eldrickm/wakey_wakey/netlists/README.md

Use:
design_extracted.spice-hand-route-diode-fix.gz
- This has D0 instead of X0 in the raw spice for the diode issue
design.lvs.v-dbg-decapped-wrapped.gz
- This adds user_project_wrapper as well as the relevant power connections

These pass LVS.
