eldrickm/wakey_wakey/pd_proprietary/custom_lvs_no_bbox/inputs/README.md

This needs:
adk/
design.lvs.v
design_extracted.spice

Move stdcells.spi to adk/, this deals with he VNB pins in conb_1
