eldrickm/wakey_wakey/py/model_summary.png

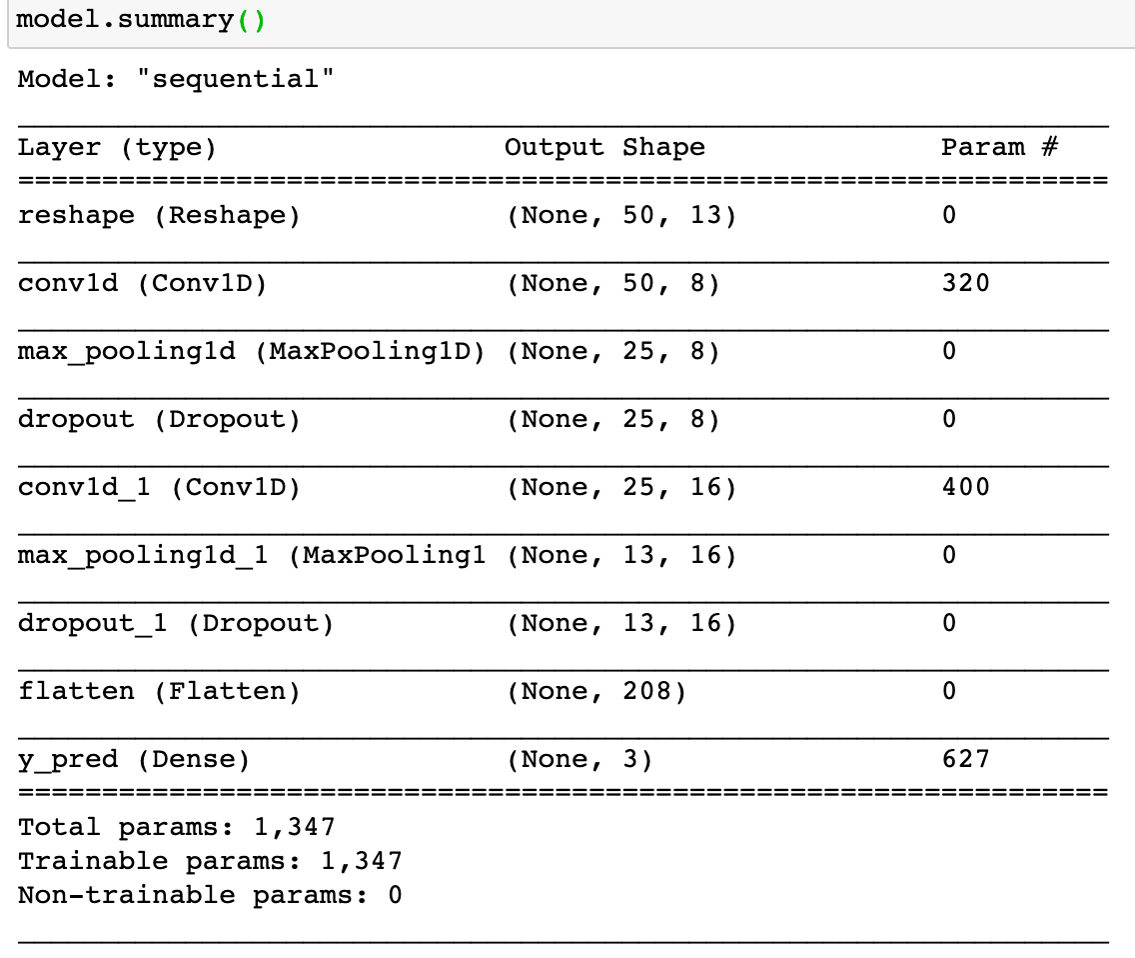
py/model_summary.png
