eldrickm/wakey_wakey/py/outputs/err_cic1_16000_ps.png

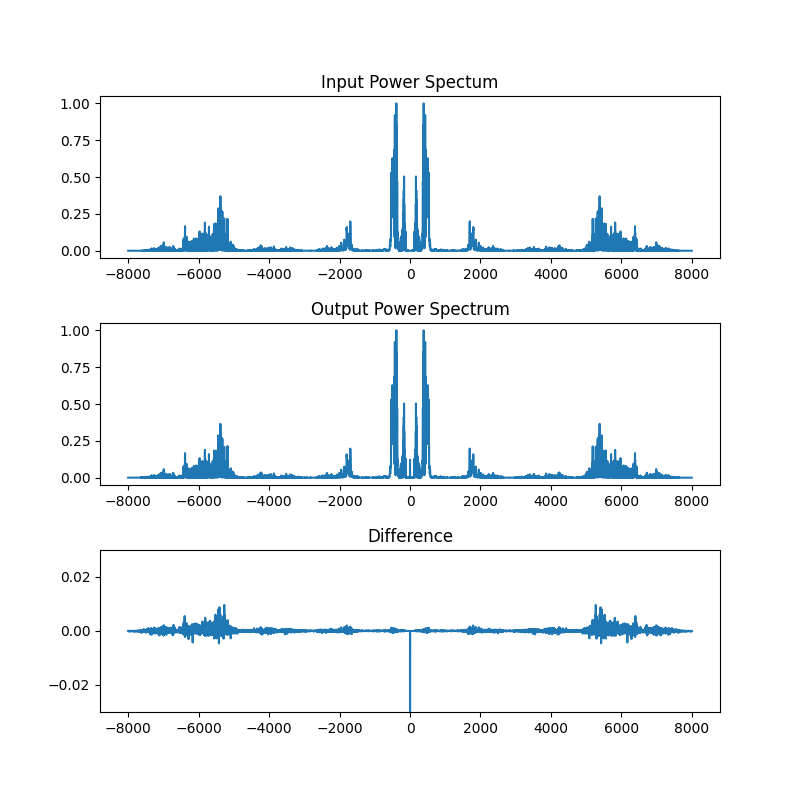
py/outputs/err_cic1_16000_ps.png
