eldrickm/wakey_wakey/rtl/aco/aco/plots/test_1/2Power_spectrum.png

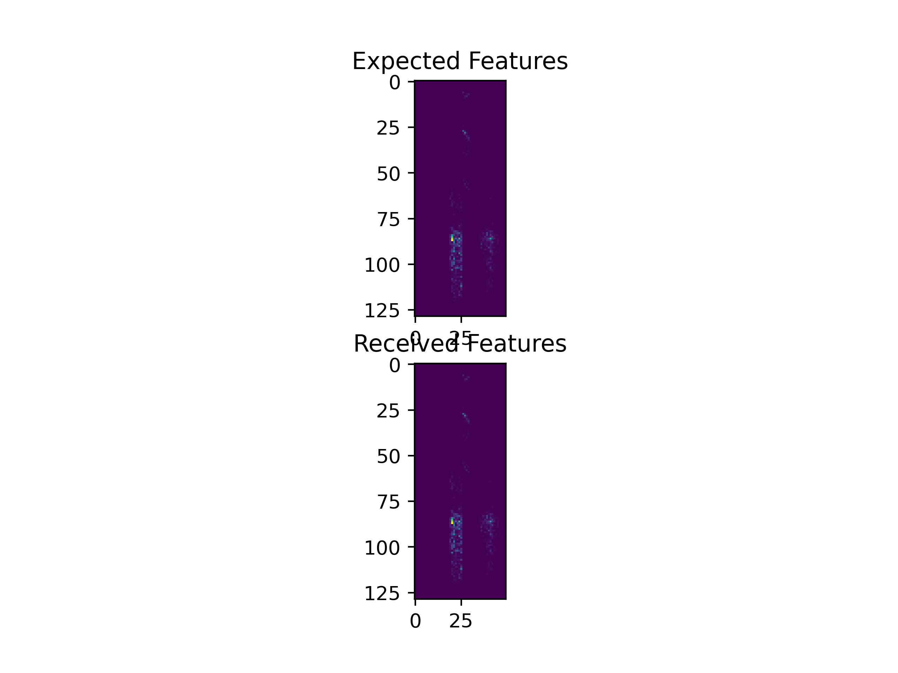
rtl/aco/aco/plots/test_1/2Power_spectrum.png
