eldrickm/wakey_wakey/rtl/aco/fft_wrapper/plots/0.png

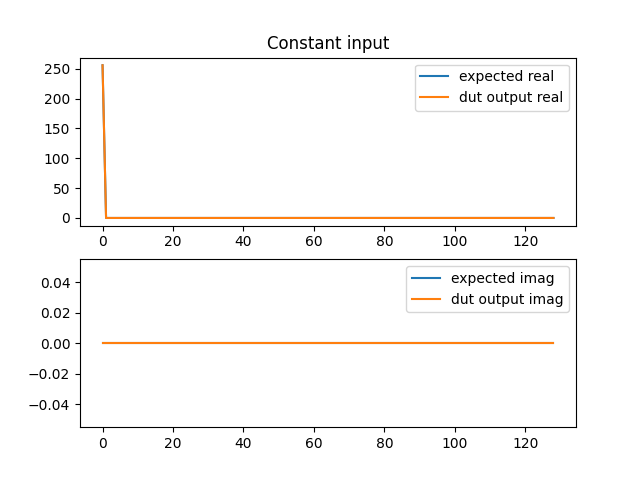
rtl/aco/fft_wrapper/plots/0.png
