eldrickm/wakey_wakey/rtl/aco/fft_wrapper/plots/1.png

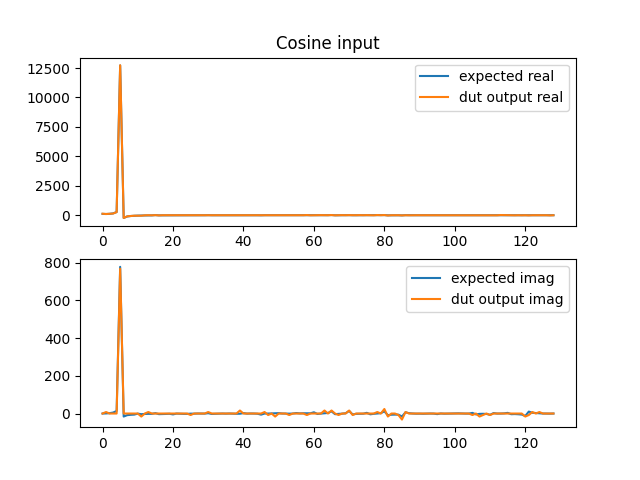
rtl/aco/fft_wrapper/plots/1.png
