eldrickm/wakey_wakey/rtl/aco/fft_wrapper/plots/2.png

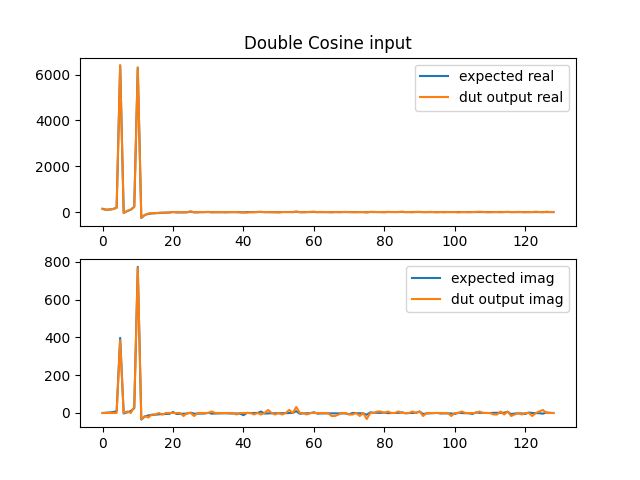
rtl/aco/fft_wrapper/plots/2.png
