eldrickm/wakey_wakey/rtl/aco/fft_wrapper/plots/3.png

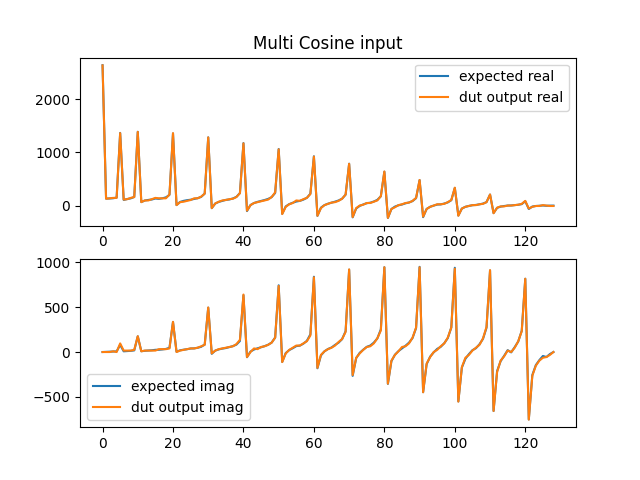
rtl/aco/fft_wrapper/plots/3.png
