eldrickm/wakey_wakey/rtl/aco/fft_wrapper/plots/4.png

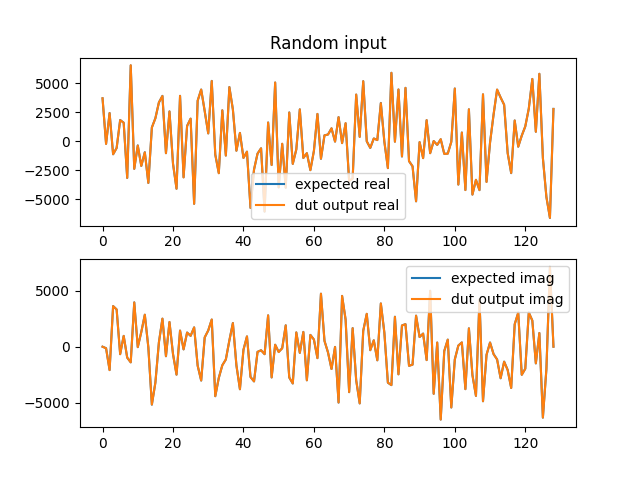
rtl/aco/fft_wrapper/plots/4.png
