eldrickm/wakey_wakey/rtl/aco/aco/plots/test_1/3Filterbank.png

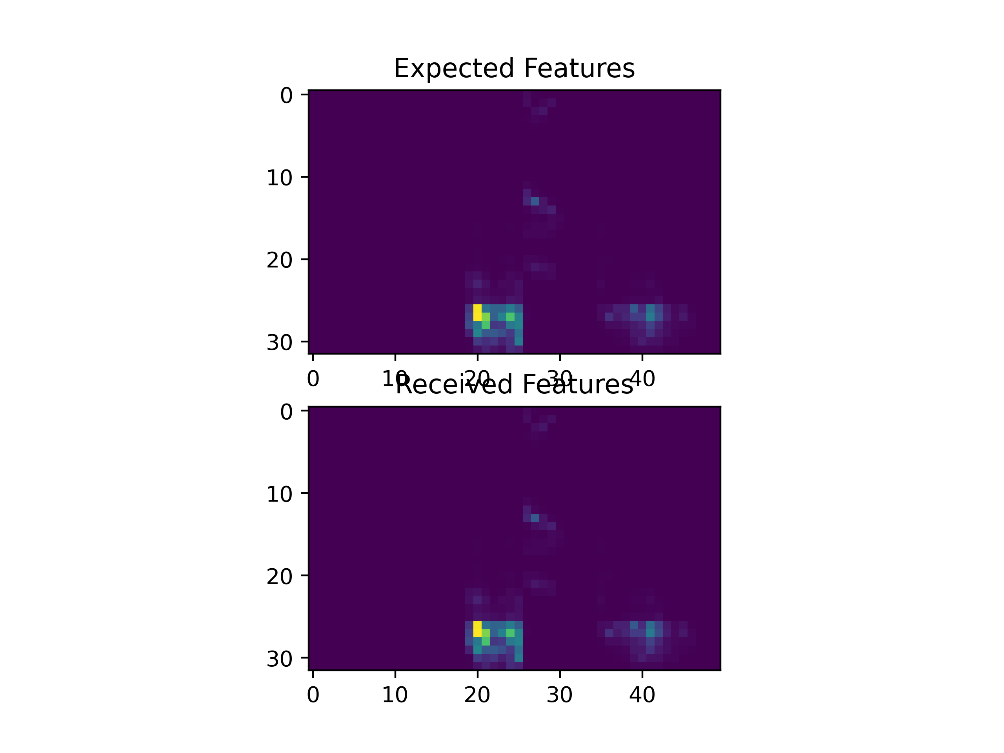
rtl/aco/aco/plots/test_1/3Filterbank.png
