eldrickm/wakey_wakey/rtl/aco/aco/plots/test_1/4Log.png

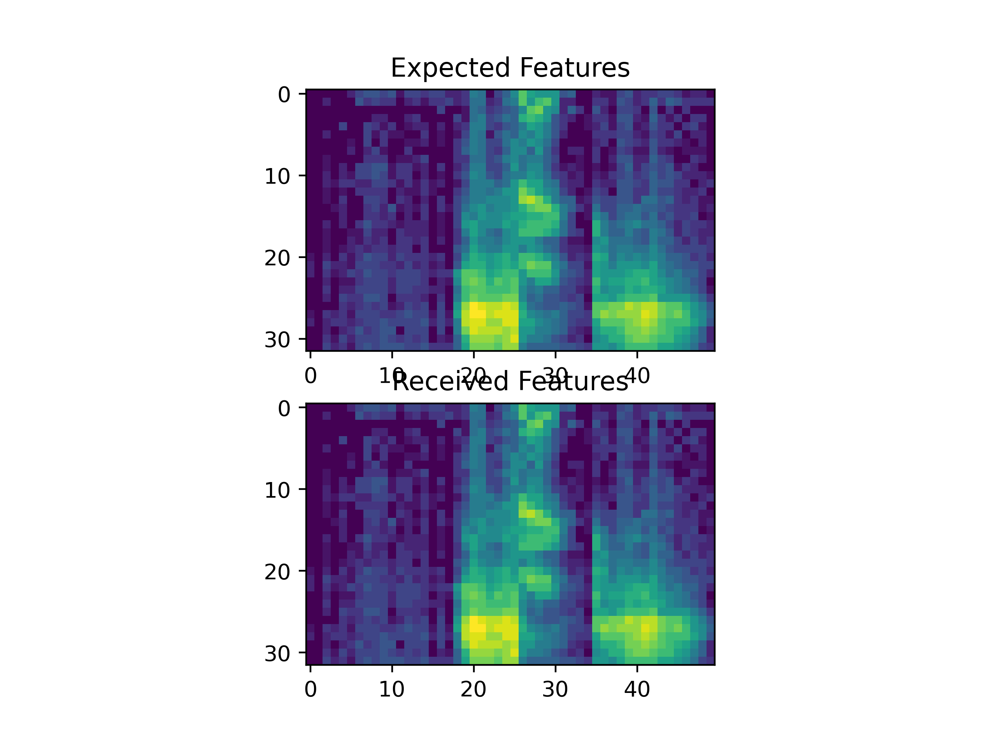
rtl/aco/aco/plots/test_1/4Log.png
