eldrickm/wakey_wakey/rtl/aco/aco/plots/test_1/5DCT.png

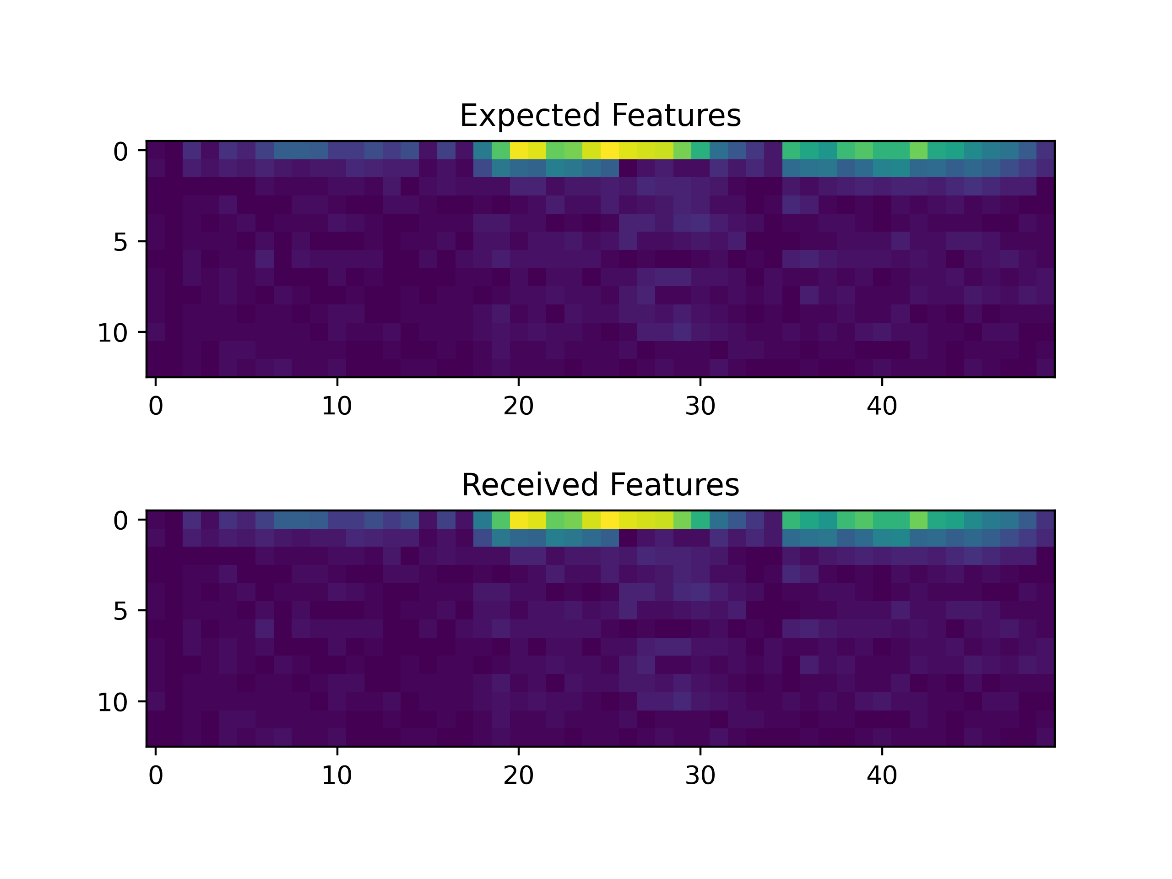
rtl/aco/aco/plots/test_1/5DCT.png
