eldrickm/wakey_wakey/rtl/aco/aco/plots/test_2/3Filterbank.png

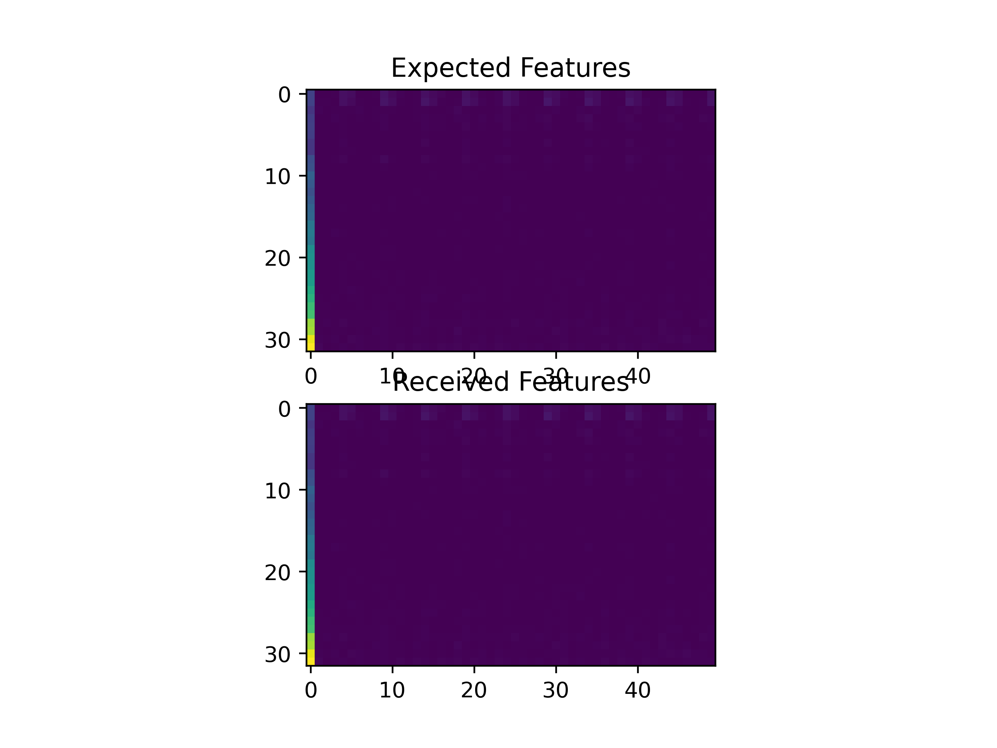
rtl/aco/aco/plots/test_2/3Filterbank.png
