eldrickm/wakey_wakey/rtl/aco/aco/plots/test_2/5DCT.png

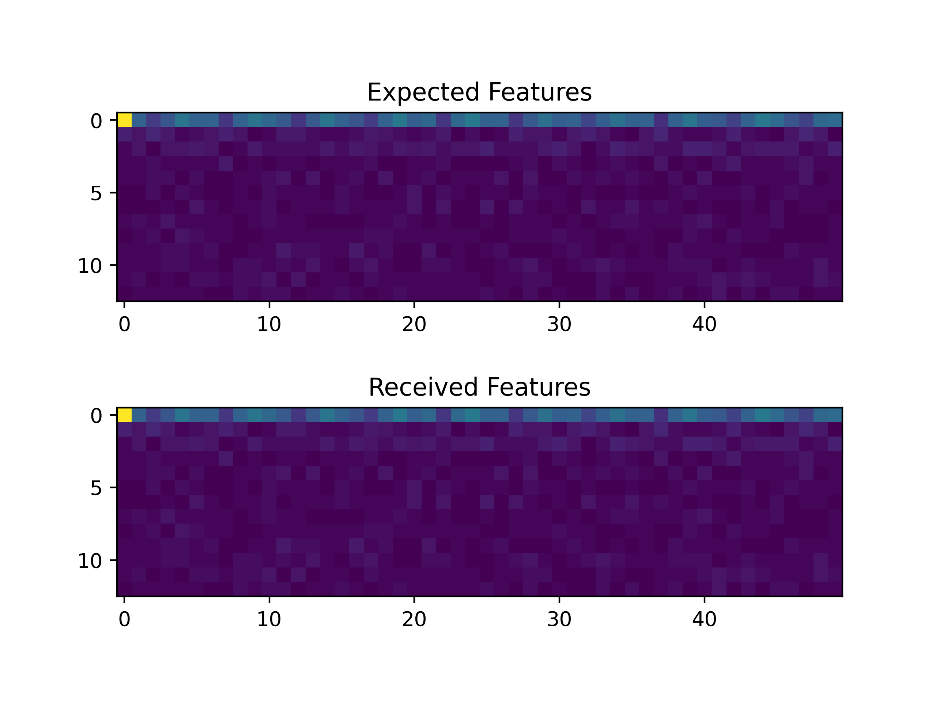
rtl/aco/aco/plots/test_2/5DCT.png
