eldrickm/wakey_wakey/rtl/aco/aco/plots/test_3/4Log.png

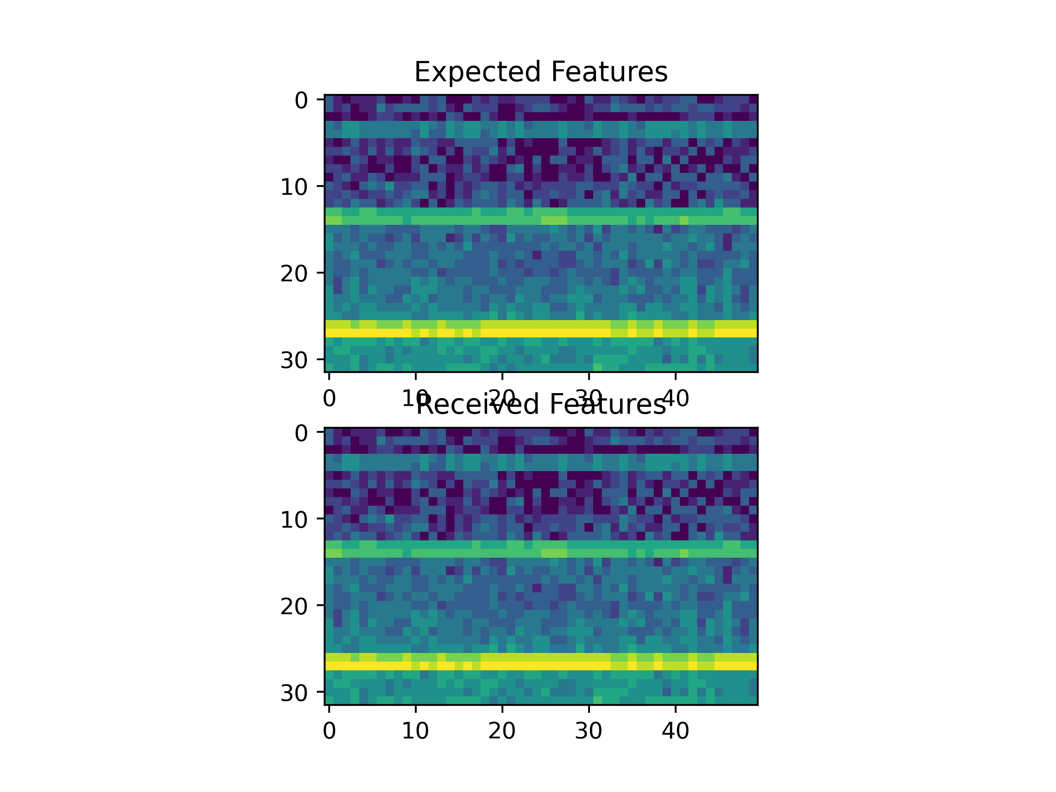
rtl/aco/aco/plots/test_3/4Log.png
