eldrickm/wakey_wakey/rtl/aco/aco/plots/test_3/5DCT.png

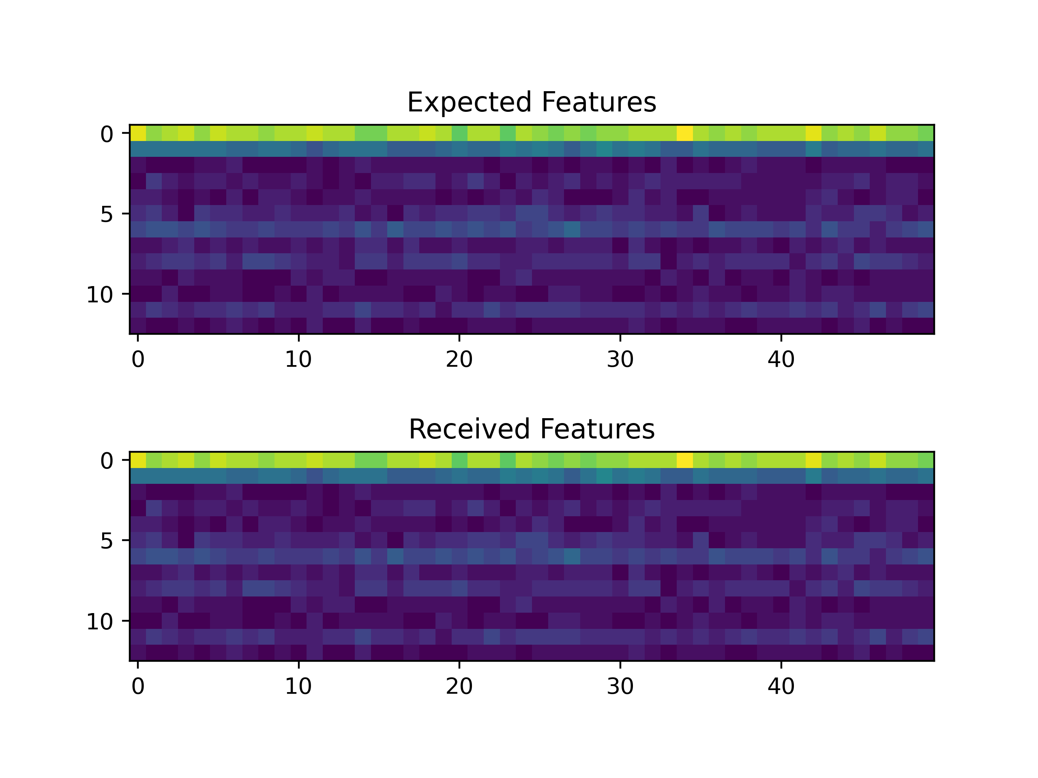
rtl/aco/aco/plots/test_3/5DCT.png
