eldrickm/wakey_wakey/rtl/aco/aco/plots/test_4/5DCT.png

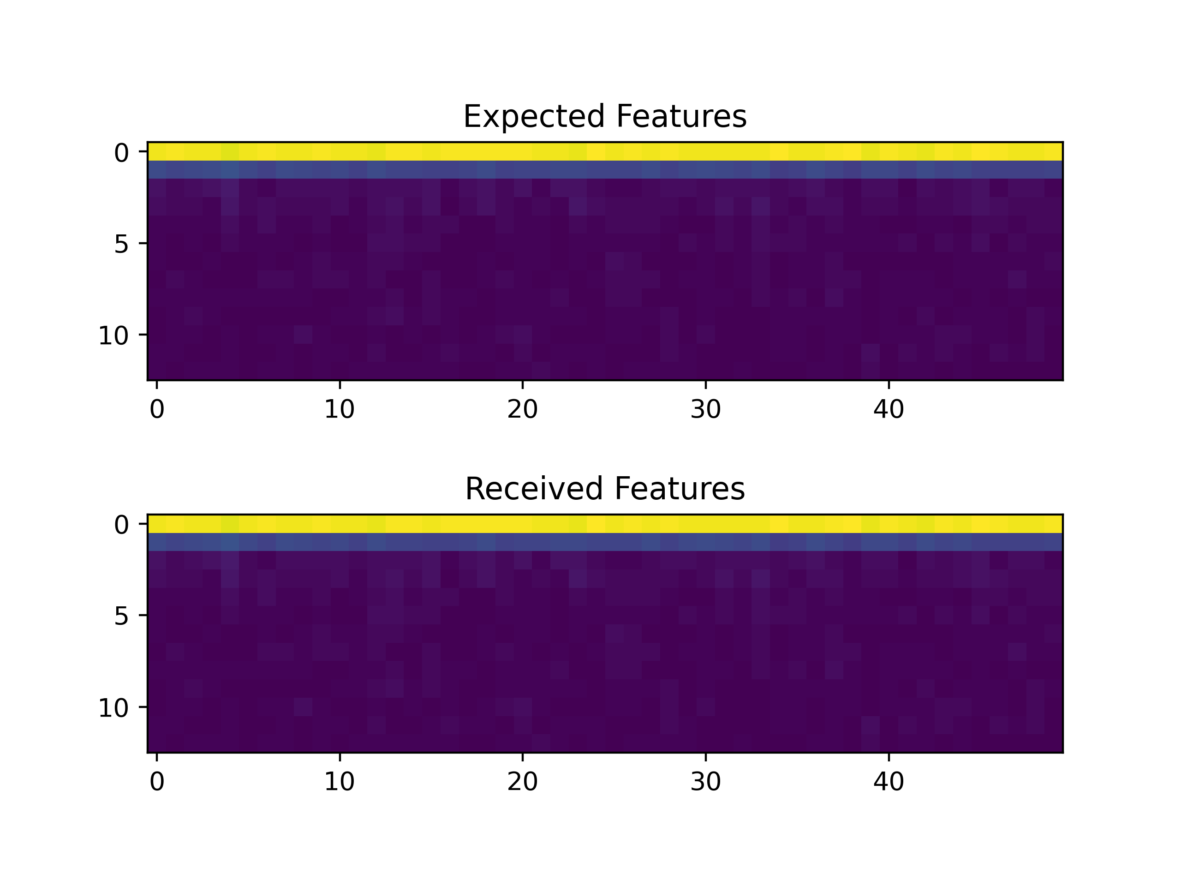
rtl/aco/aco/plots/test_4/5DCT.png
