eldrickm/wakey_wakey/rtl/aco/aco/plots/test_5/5DCT.png

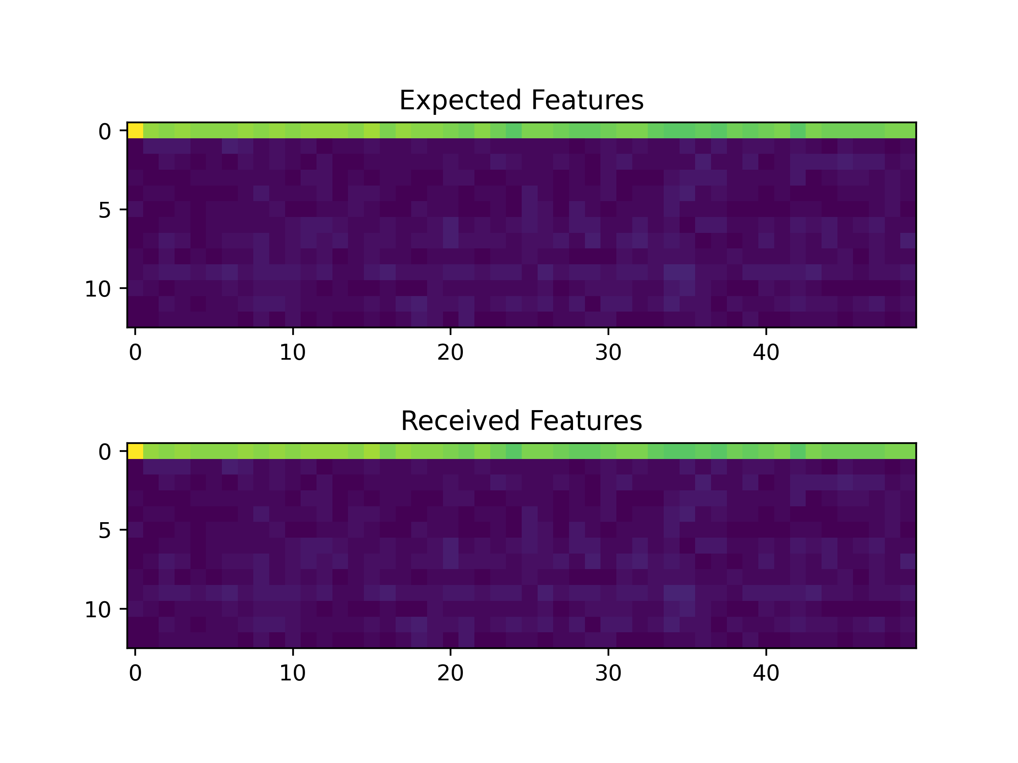
rtl/aco/aco/plots/test_5/5DCT.png
