eldrickm/wakey_wakey/rtl/aco/aco/plots/test_6/5DCT.png

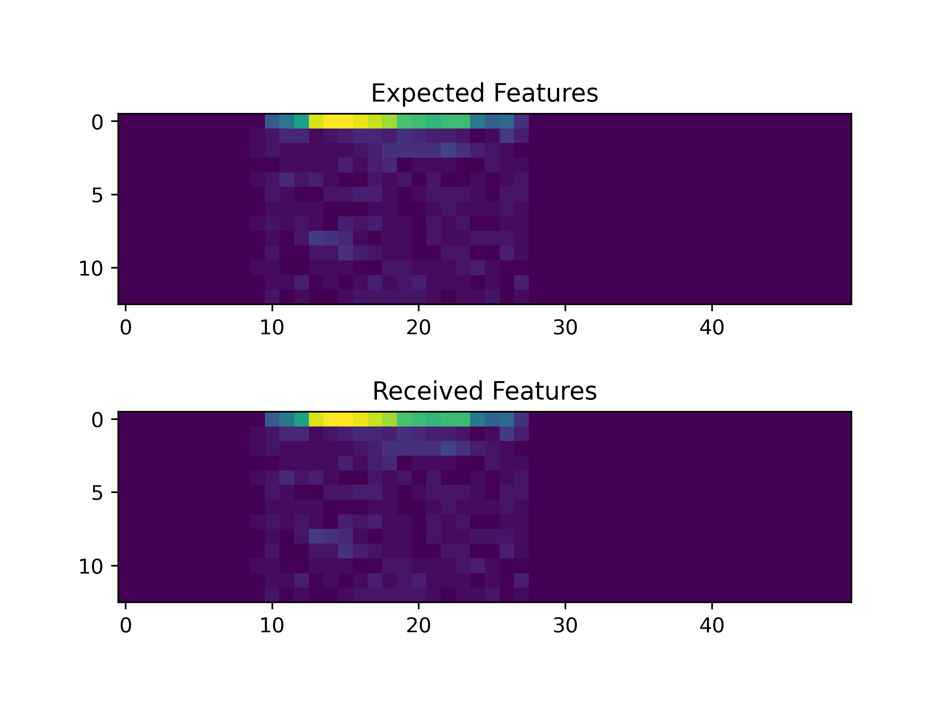
rtl/aco/aco/plots/test_6/5DCT.png
