eldrickm/wakey_wakey/rtl/aco/aco/plots/test_7/5DCT.png

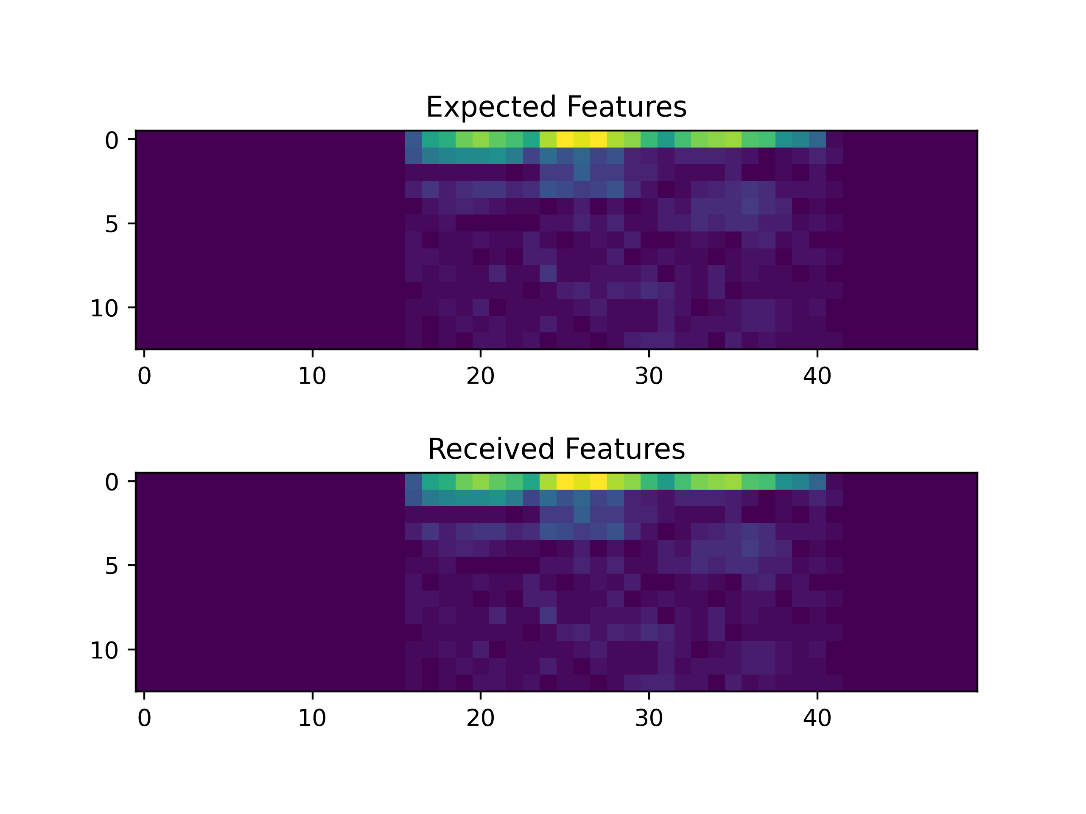
rtl/aco/aco/plots/test_7/5DCT.png
