eldrickm/wakey_wakey/rtl/aco/aco/plots/test_8/5DCT.png

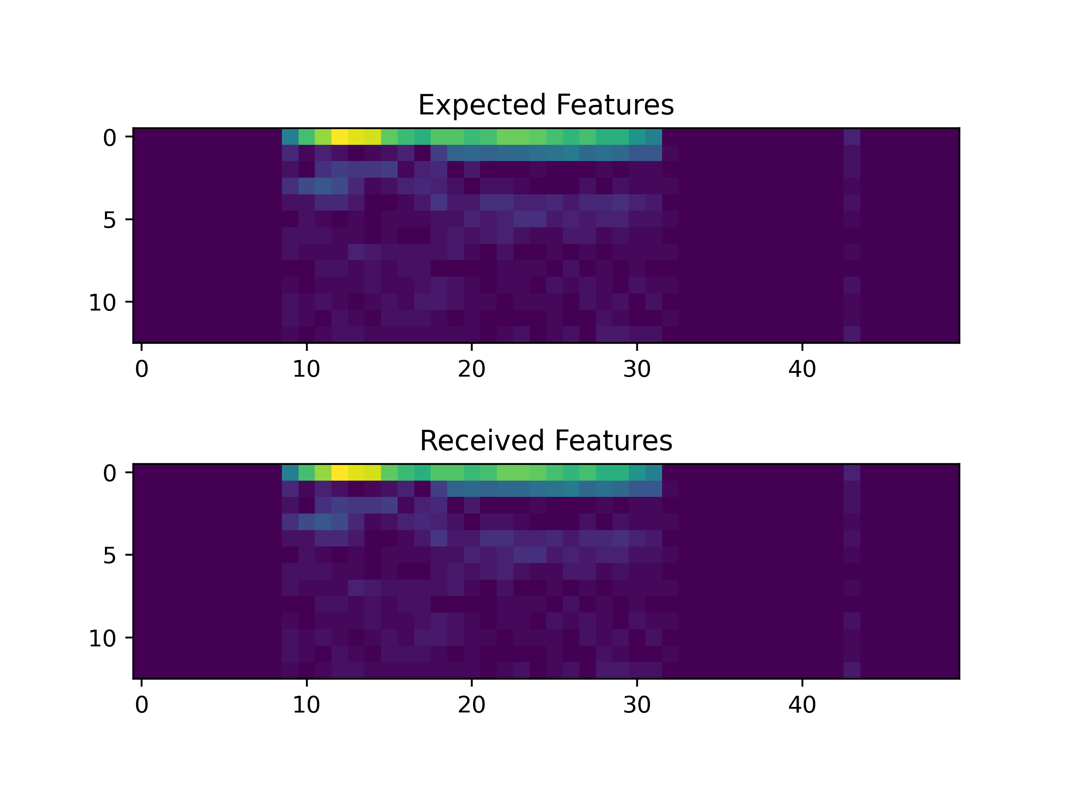
rtl/aco/aco/plots/test_8/5DCT.png
