eldrickm/wakey_wakey/rtl/aco/aco/plots/test_9/5DCT.png

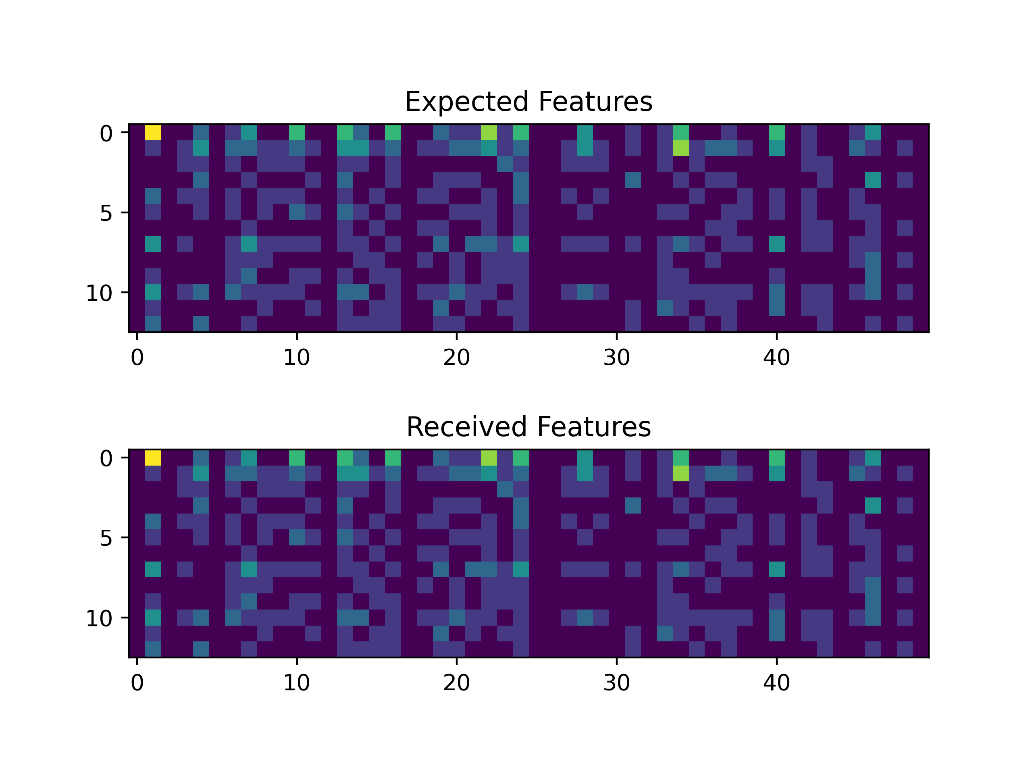
rtl/aco/aco/plots/test_9/5DCT.png
