eldrickm/wakey_wakey/rtl/aco/aco/plots/test_10/5DCT.png

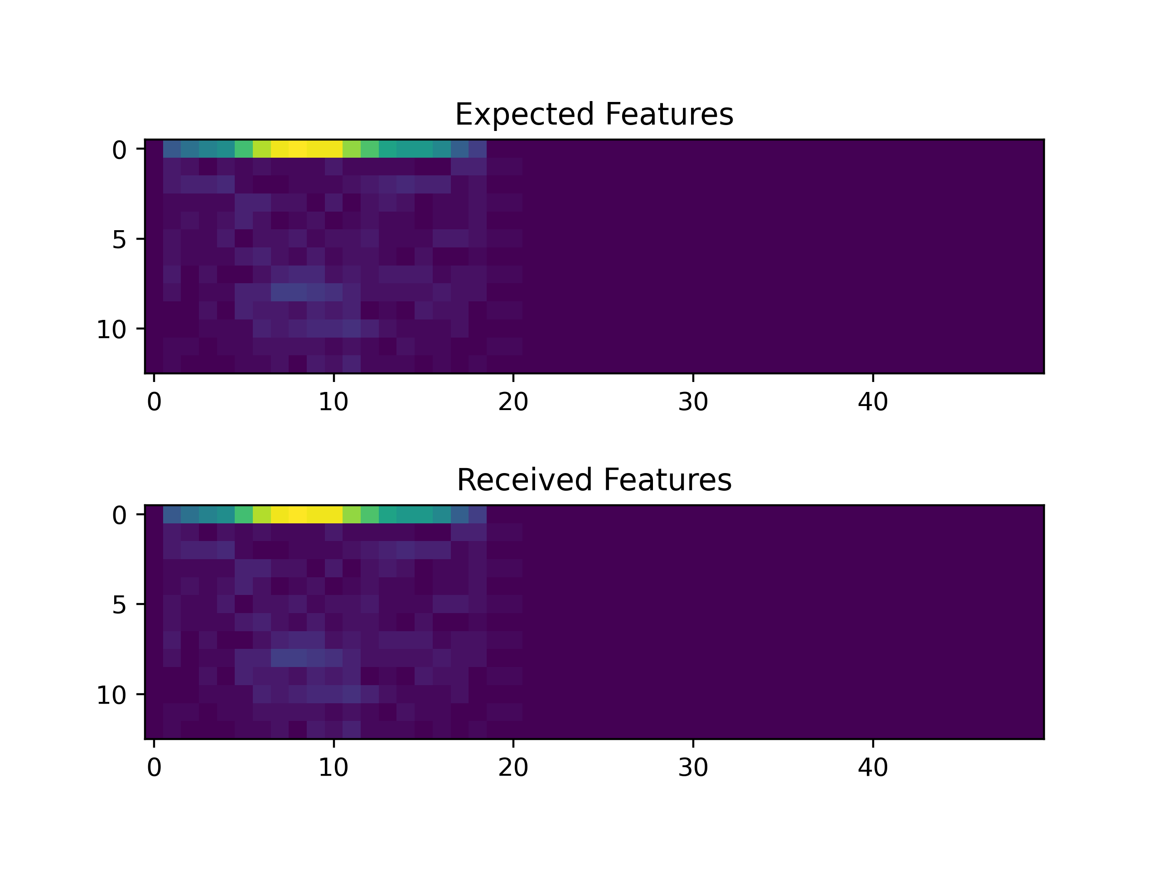
rtl/aco/aco/plots/test_10/5DCT.png
