eldrickm/wakey_wakey/rtl/aco/aco/plots/test_11/4Log.png

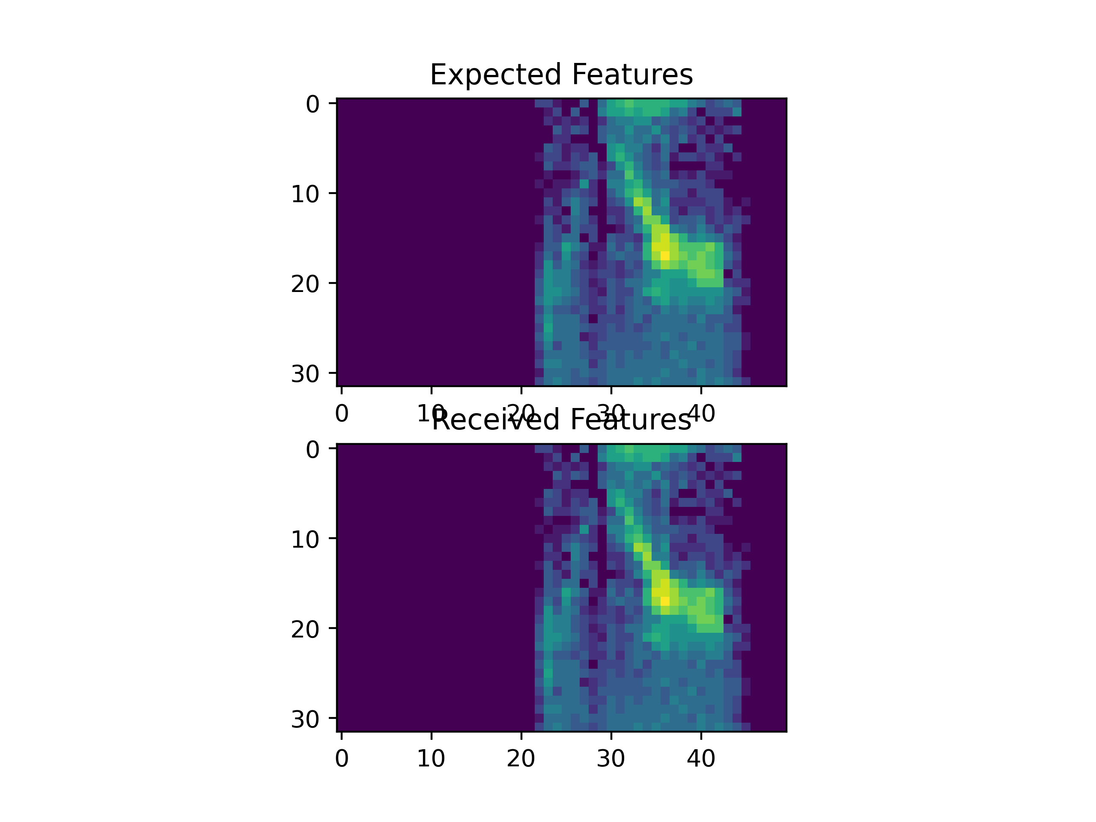
rtl/aco/aco/plots/test_11/4Log.png
