eldrickm/wakey_wakey/rtl/aco/aco/plots/test_11/5DCT.png

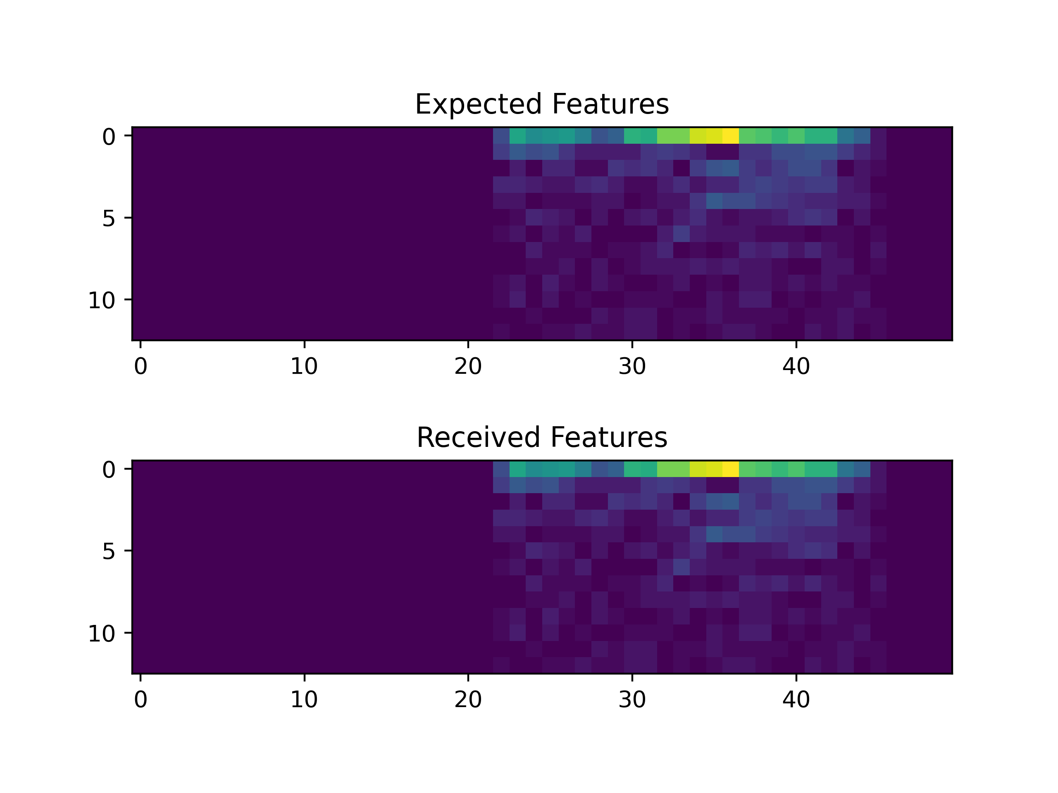
rtl/aco/aco/plots/test_11/5DCT.png
