eldrickm/wakey_wakey/rtl/top/top/plots/test_4/7Final.png

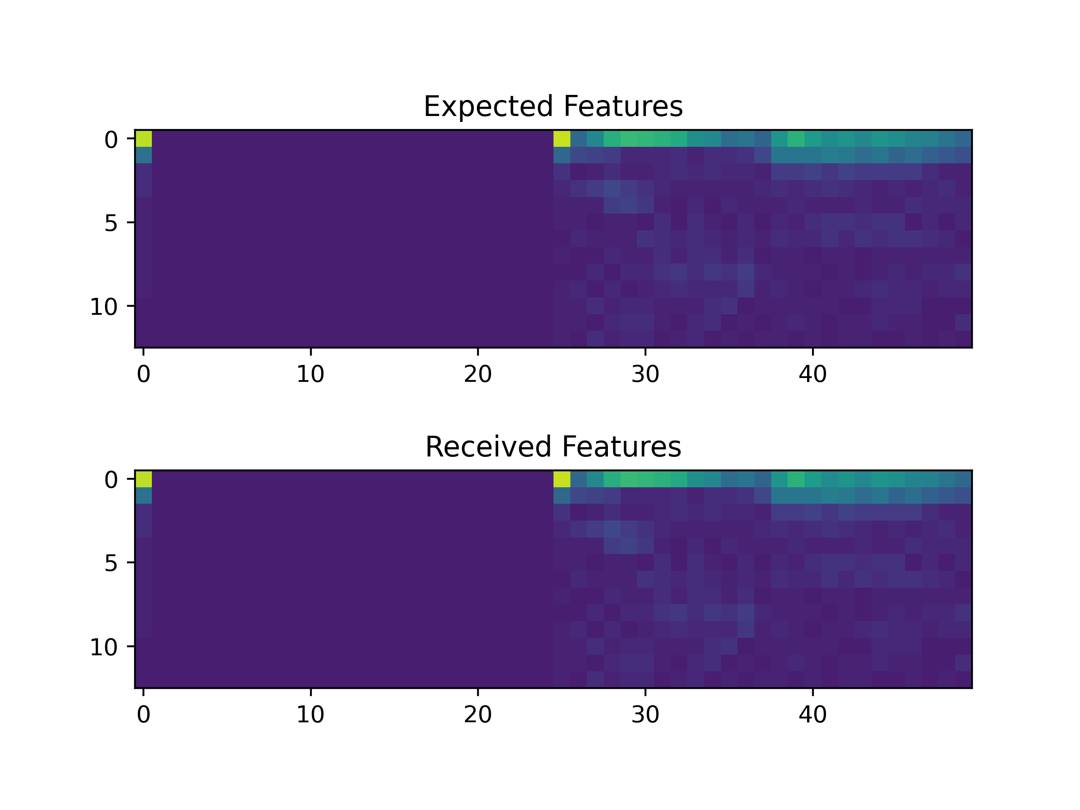
rtl/top/top/plots/test_4/7Final.png
