eldrickm/wakey_wakey/rtl/top/top/plots/test_5/7Final.png

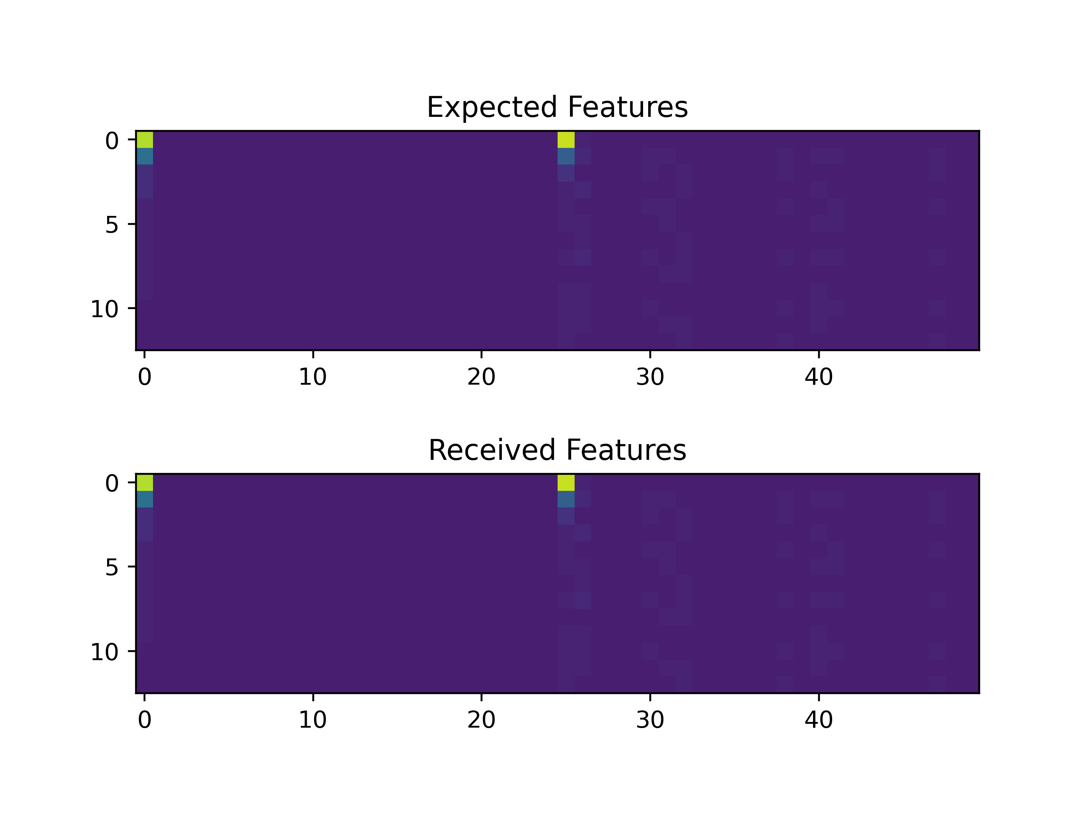
rtl/top/top/plots/test_5/7Final.png
