eldrickm/wakey_wakey/rtl/top/top/plots/test_6/7Final.png

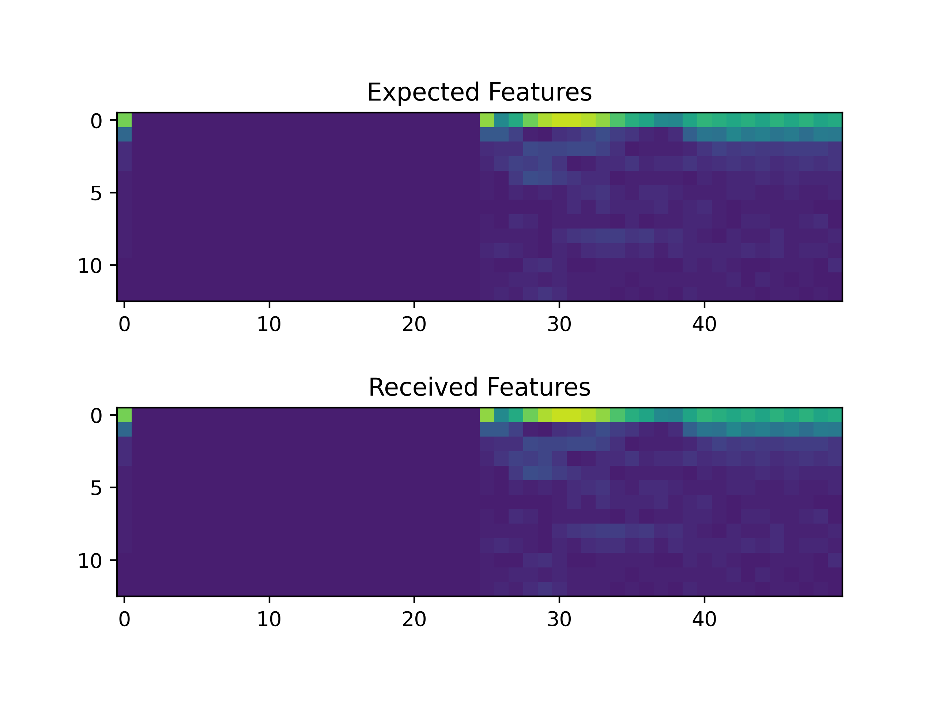
rtl/top/top/plots/test_6/7Final.png
