eldrickm/wakey_wakey/rtl/top/top/plots/test_9/7Final.png

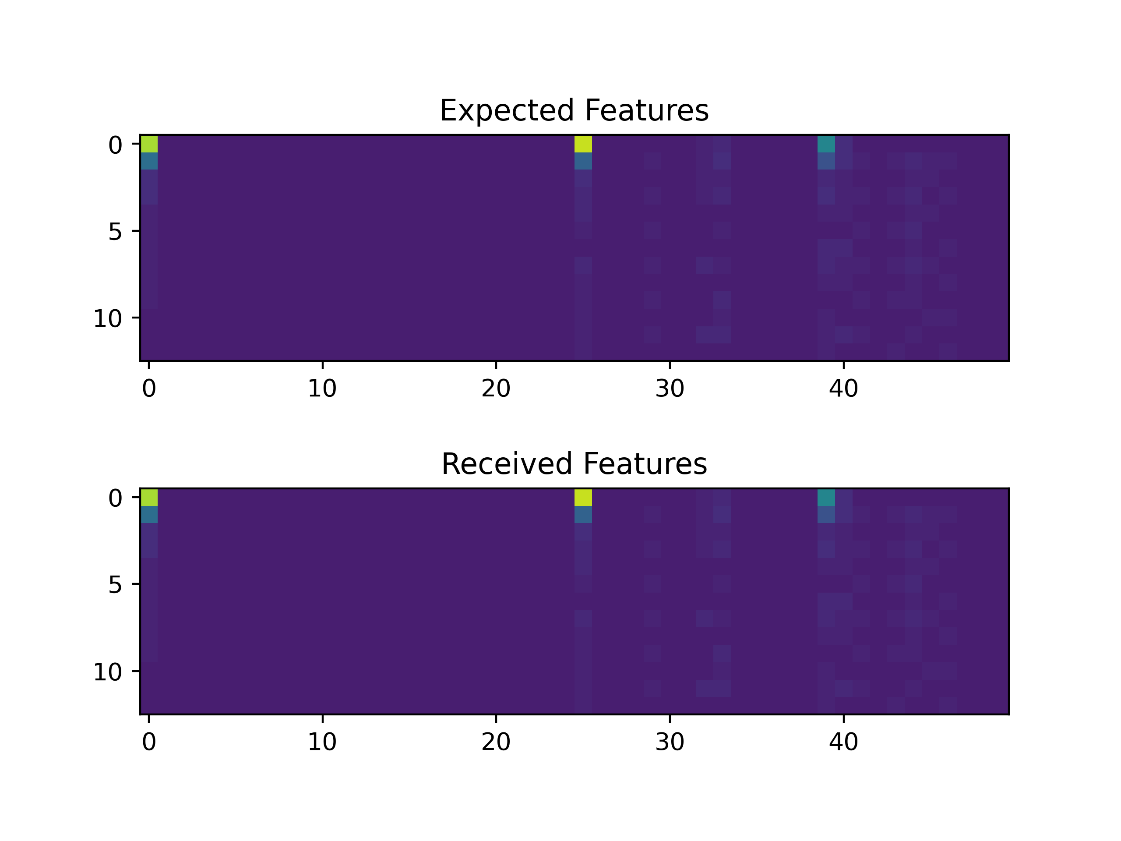
rtl/top/top/plots/test_9/7Final.png
