eldrickm/wakey_wakey/rtl/top/top/plots/test_11/7Final.png

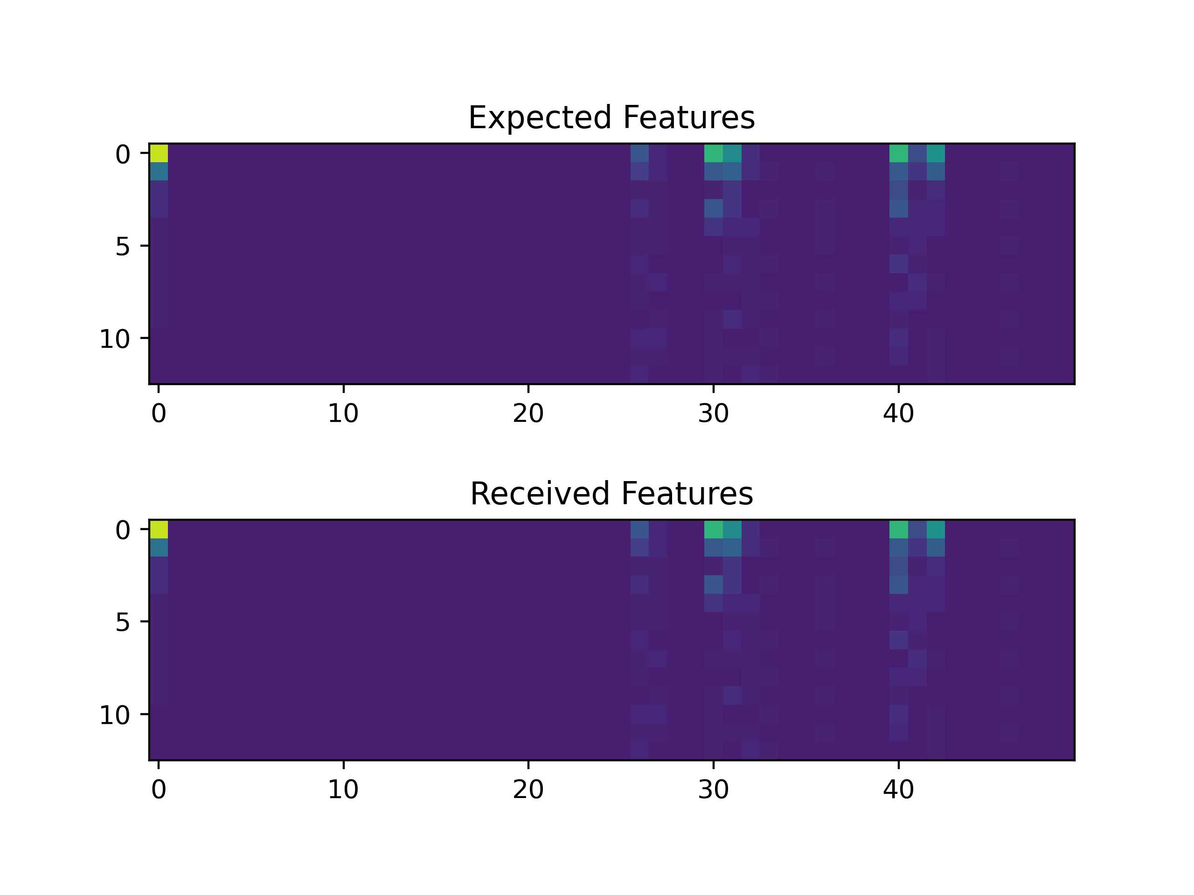
rtl/top/top/plots/test_11/7Final.png
