eldrickm/wakey_wakey/rtl/top/top/plots/test_13/7Final.png

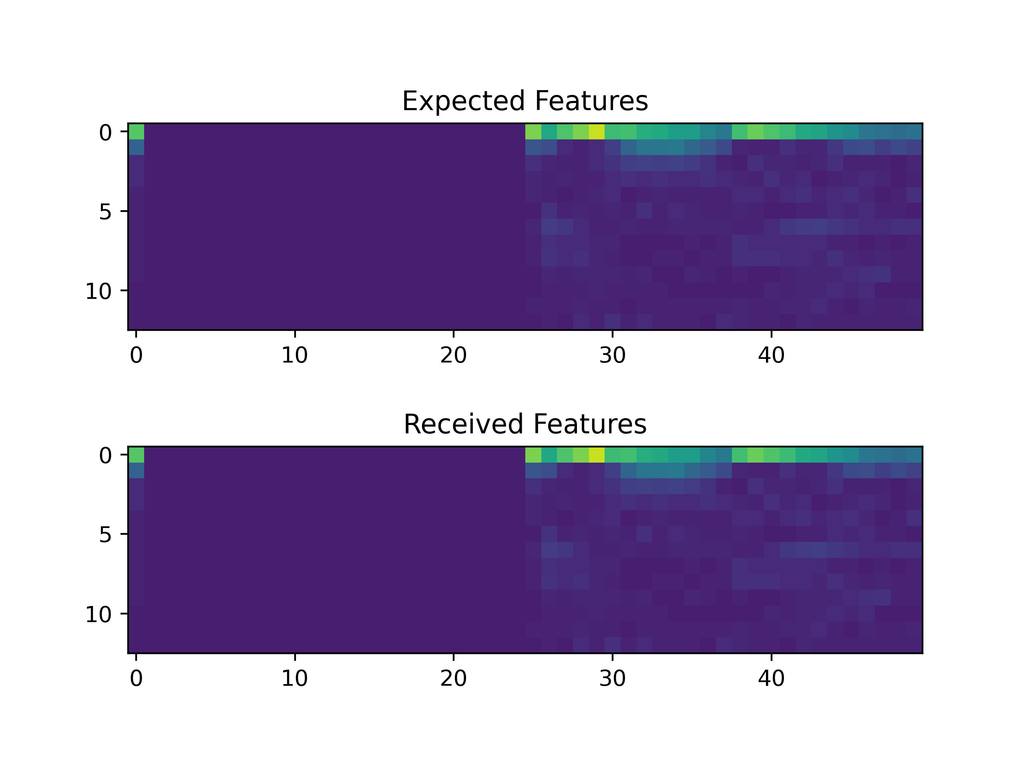
rtl/top/top/plots/test_13/7Final.png
