eldrickm/wakey_wakey/rtl/top/top/plots/test_15/7Final.png

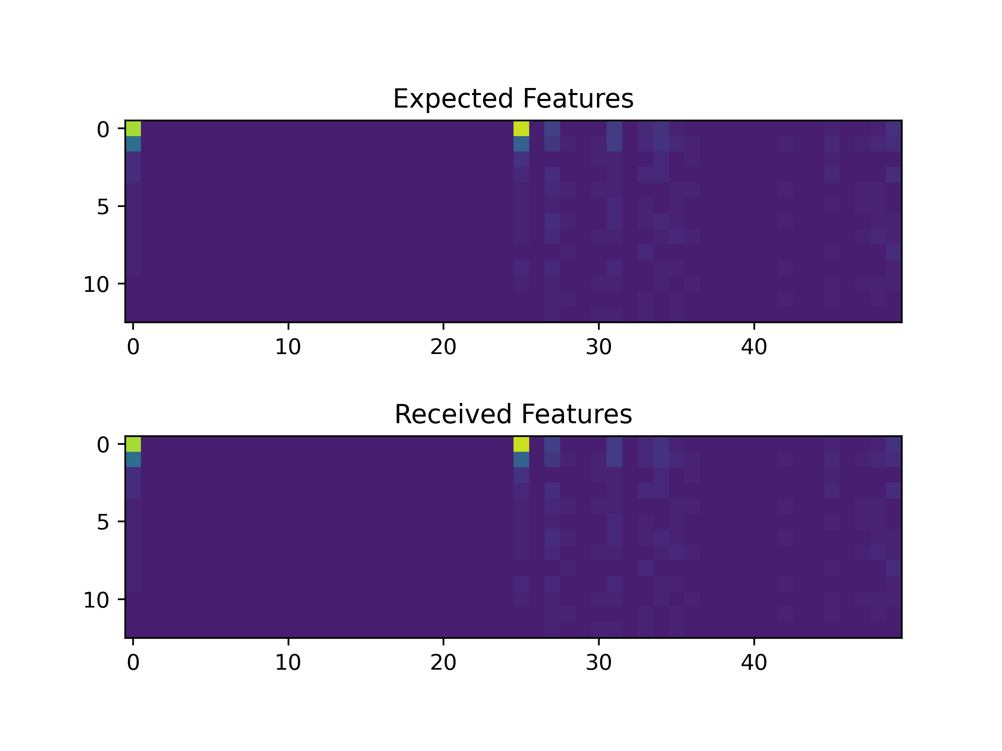
rtl/top/top/plots/test_15/7Final.png
