eldrickm/wakey_wakey/rtl/top/top/plots/test_17/7Final.png

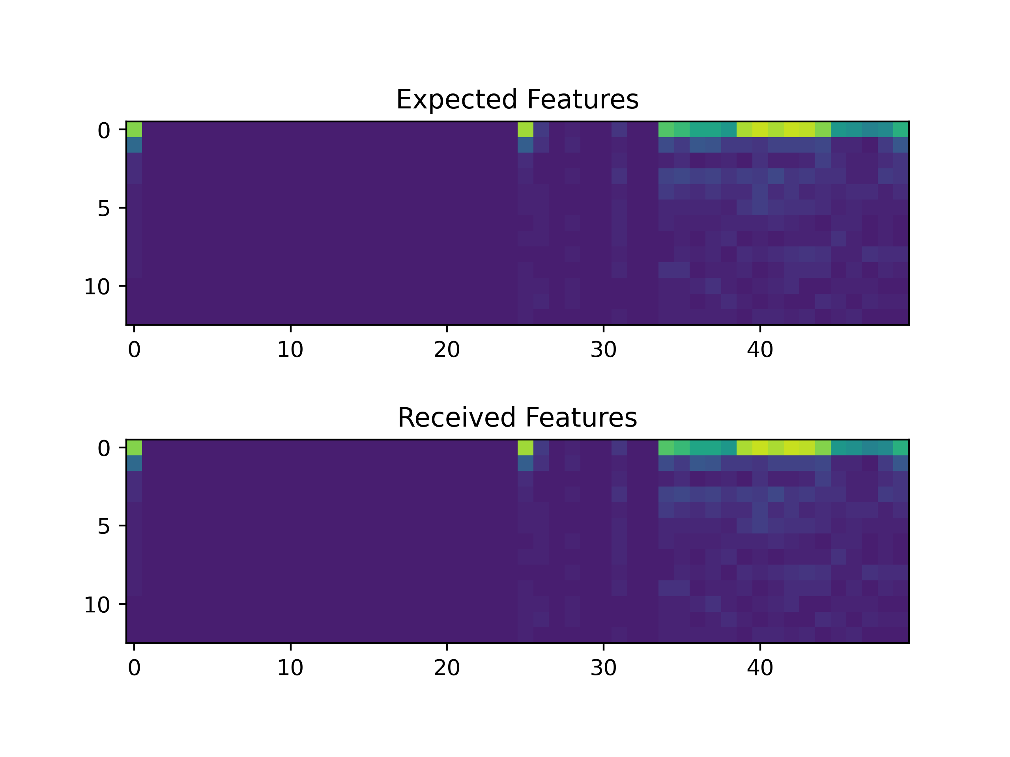
rtl/top/top/plots/test_17/7Final.png
