eldrickm/wakey_wakey/rtl/top/top/plots/test_19/7Final.png

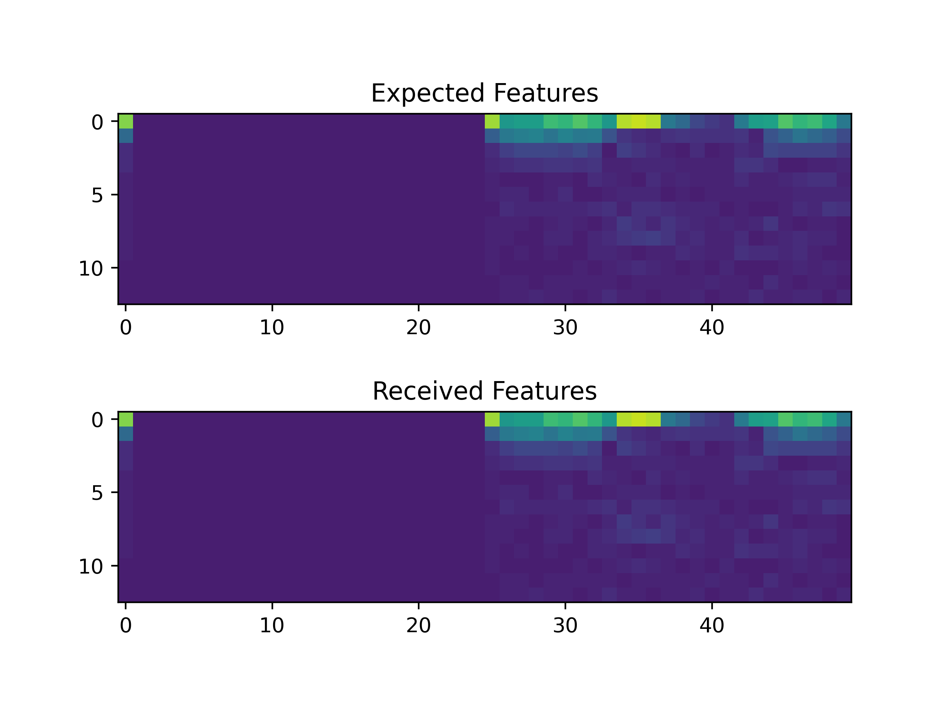
rtl/top/top/plots/test_19/7Final.png
