eldrickm/wakey_wakey/rtl/top/top/plots/test_20/7Final.png

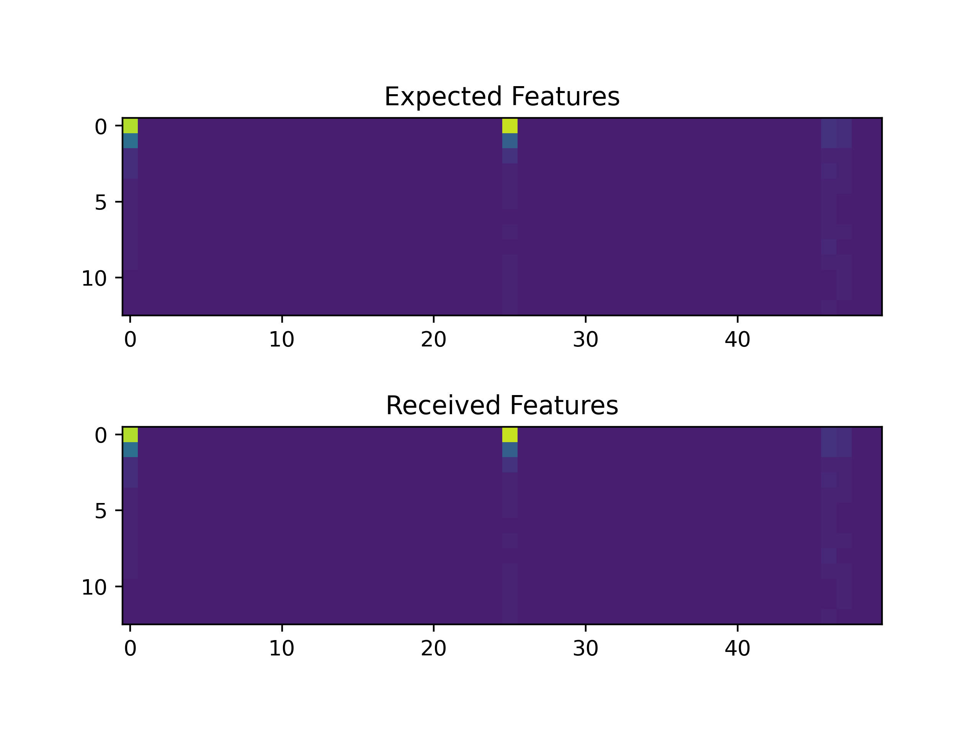
rtl/top/top/plots/test_20/7Final.png
