eldrickm/wakey_wakey/rtl/top/top/plots/test_21/7Final.png

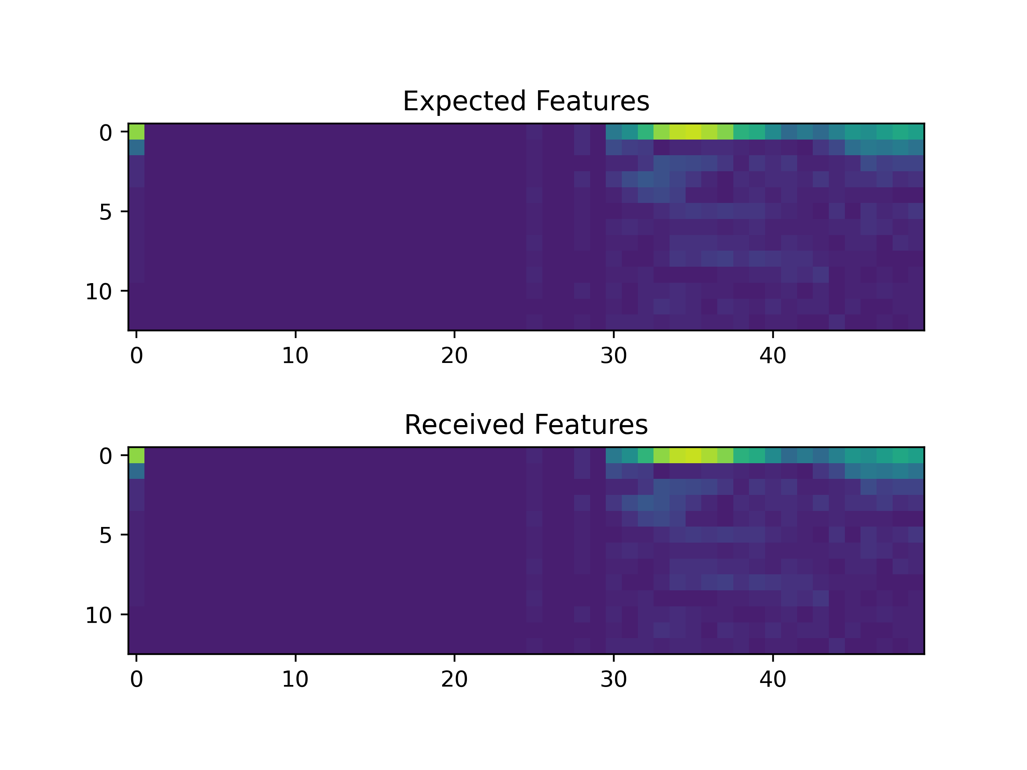
rtl/top/top/plots/test_21/7Final.png
