eldrickm/wakey_wakey/rtl/top/top/plots/test_22/7Final.png

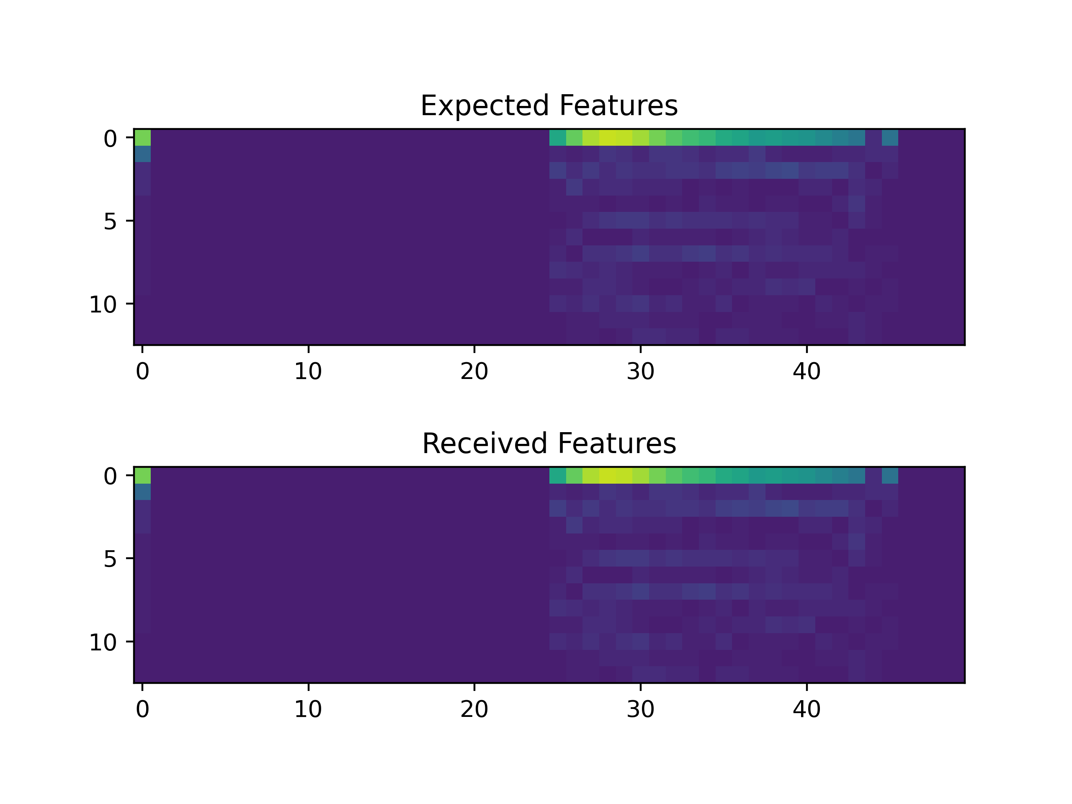
rtl/top/top/plots/test_22/7Final.png
