eldrickm/wakey_wakey/rtl/top/top/plots/test_28/7Final.png

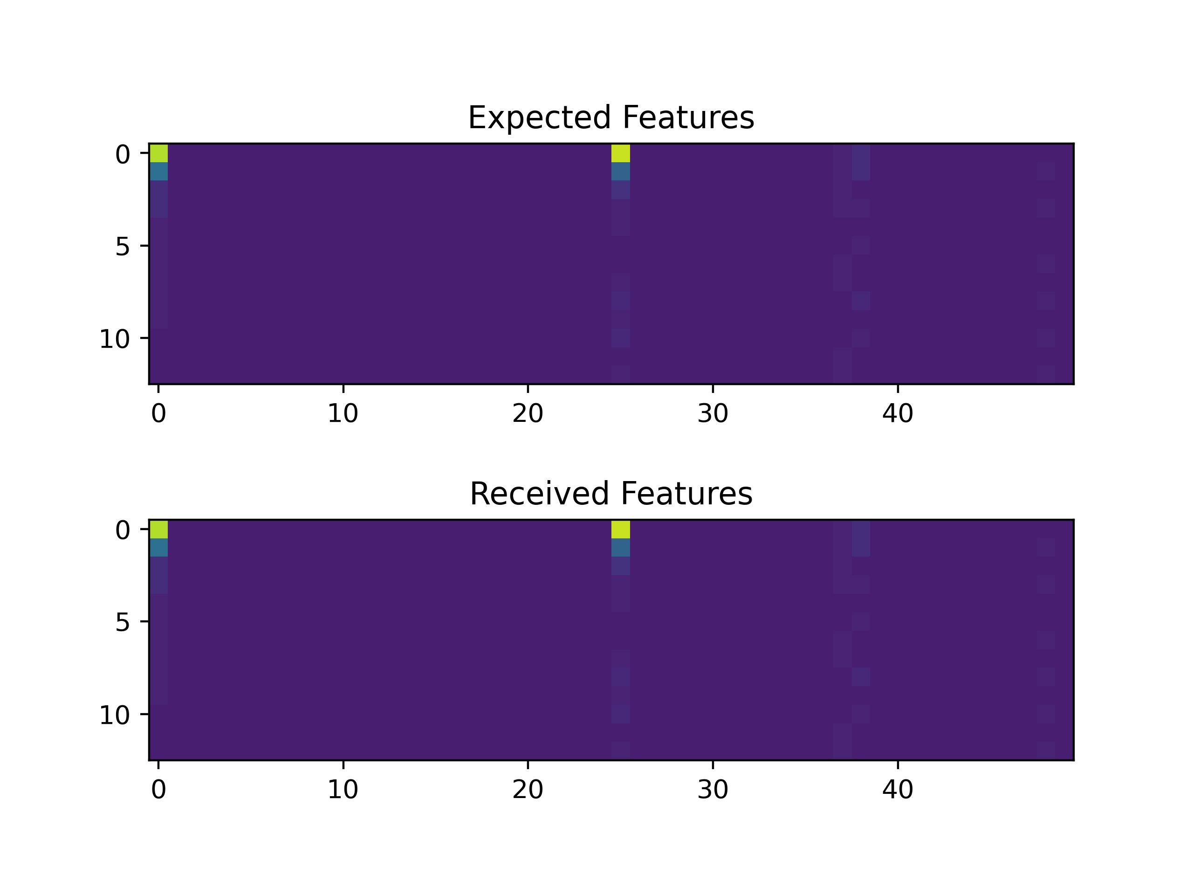
rtl/top/top/plots/test_28/7Final.png
