eldrickm/wakey_wakey/test/pdm_capture_test/py/out_dfe_dynamic_range_1cic_2mhz.png

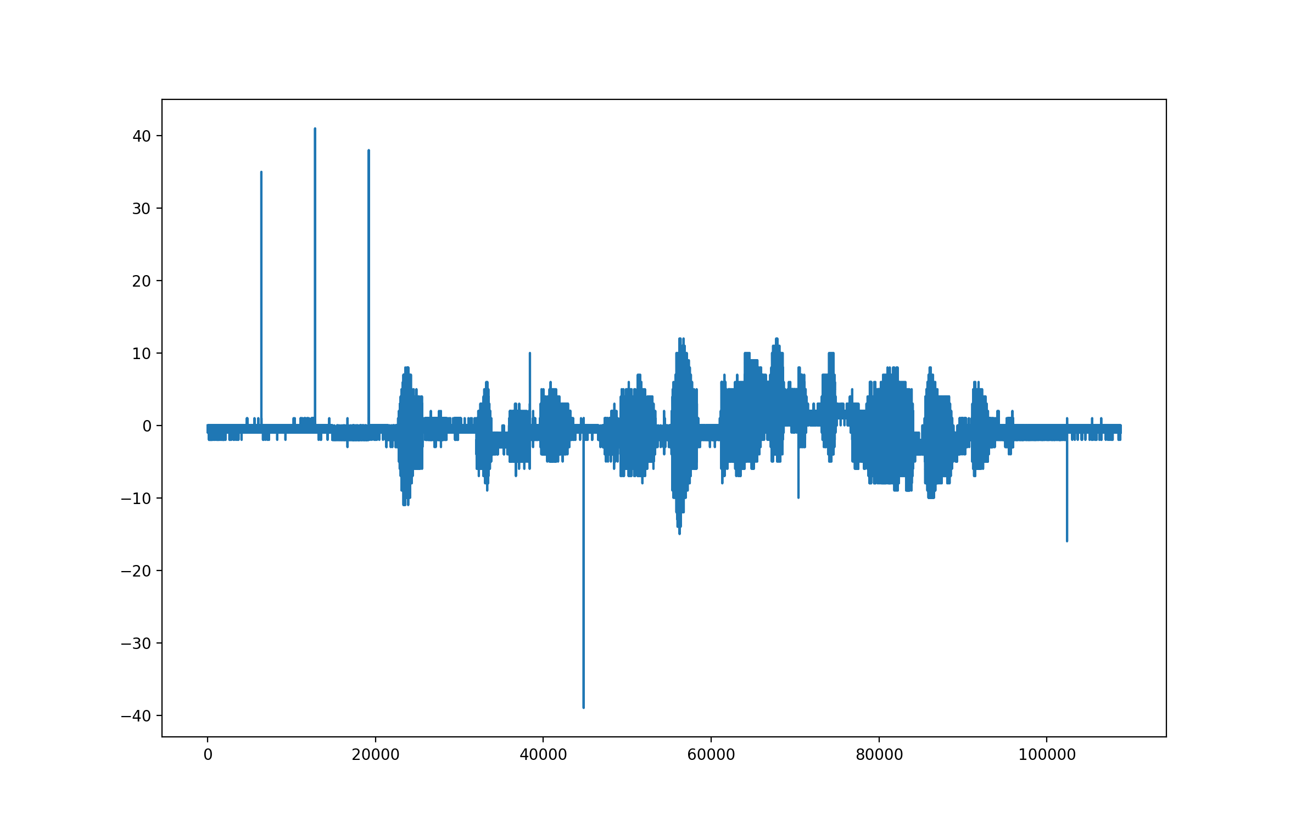
test/pdm_capture_test/py/out_dfe_dynamic_range_1cic_2mhz.png
