eldrickm/wakey_wakey/pd_proprietary/WakeyWakey/build/graph.pdf

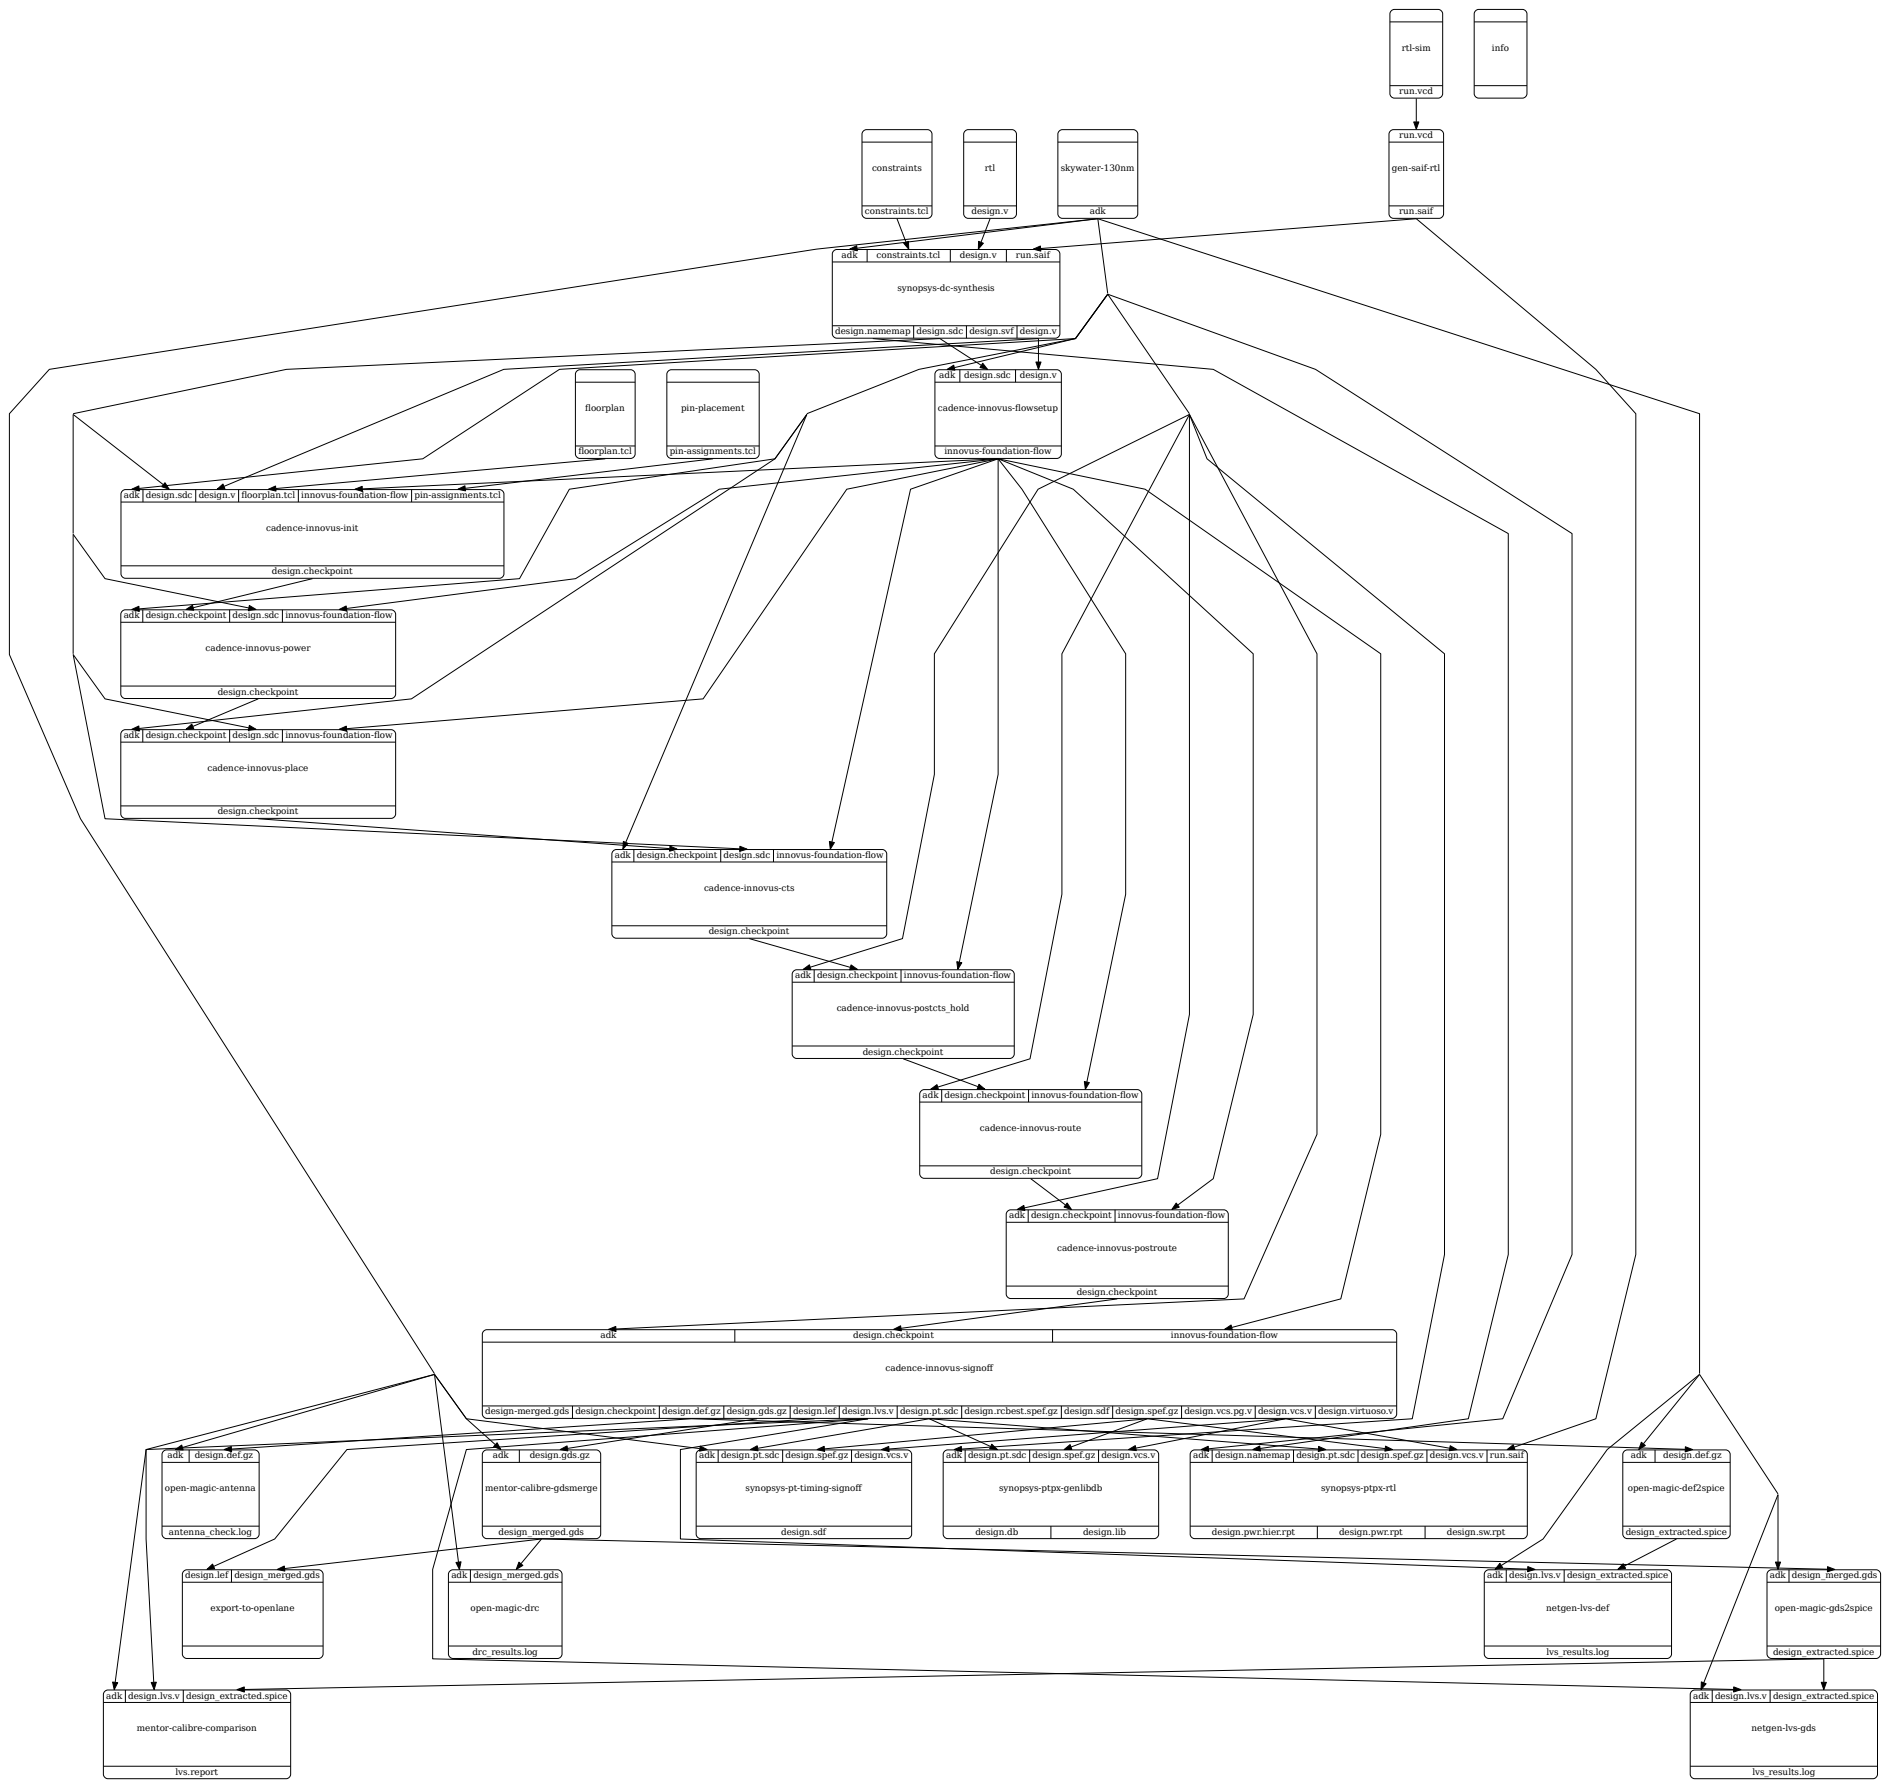
[picture p45: page 1]
design.checkpoint; cadence-innovus-postcts_hold; adk; innovus-foundation-flow; lvs.report; design.gds.gz; design_merged.gds; lvs_results.log; antenna_check.log; design.def.gz; open-magic-def2spice; design_extracted.spice; design.sdf; design.db; design.lib; design.pwr.hier.rpt; design.pwr.rpt; design.sw.rpt; constraints; constraints.tcl; design.v; run.saif; floorplan; floorplan.tcl; run.vcd; info; adk design_merged.gds; drc_results.log; open-magic-gds2spice; pin-placement; rtl; rtl-sim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

gen-saif-rtl

synopsys-dc-synthesis

design.namemap design.sdc design.svf design.v

adk design.sdc design.v

cadence-innovus-flowsetup

pin-assignments.tcl

innovus-foundation-flow

adk design.sdc design.v floorplan.tcl innovus-foundation-flow pin-assignments.tcl

cadence-innovus-init

adk design.checkpoint design.sdc innovus-foundation-flow

cadence-innovus-power

cadence-innovus-place

cadence-innovus-cts

adk design.checkpoint innovus-foundation-flow

cadence-innovus-route

cadence-innovus-postroute

cadence-innovus-signoff

design-merged.gds design.checkpoint design.def.gz design.gds.gz design.lef design.lvs.v design.pt.sdc design.rcbest.spef.gz design.sdf design.spef.gz design.vcs.pg.v design.vcs.v design.virtuoso.v

adk design.def.gz

adk design.pt.sdc design.spef.gz design.vcs.v

adk design.namemap design.pt.sdc design.spef.gz design.vcs.v run.saif

open-magic-antenna

mentor-calibre-gdsmerge

synopsys-pt-timing-signoff

synopsys-ptpx-genlibdb

synopsys-ptpx-rtl

design.lef design_merged.gds

adk design.lvs.v design_extracted.spice

export-to-openlane

open-magic-drc

netgen-lvs-def

mentor-calibre-comparison

netgen-lvs-gds
