eldrickm/wakey_wakey/rtl/aco/filterbank_half/filterbank_half.v

// =============================================================================
// Module:       Filterbank Half
// Design:       Matthew Pauly
// Verification: Eldrick Millares
// Notes:        Takes in an input power spectrum and multiplies it by half 
//               (even or odd only) MFCC overlapping triangular windows.
//               Deassertions of valid are not permitted.
// =============================================================================

module filterbank_half # (
    parameter COEFFILE     = "coef_even.hex",
    parameter BOUNDARYFILE = "boundary_even.hex",

    // =========================================================================
    // Local Parameters - Do Not Edit
    // =========================================================================
    parameter I_BW = 32,
    parameter O_BW = 32
) (
    // clock and reset
    input                                   clk_i,
    input                                   rst_n_i,
    input                                   en_i,

    // streaming input
    input         [I_BW - 1 : 0]            data_i,
    input                                   valid_i,
    input                                   last_i,

    // streaming output
    output         [O_BW - 1 : 0]           data_o,
    output                                  valid_o,
    output                                  last_o
);
    // =========================================================================
    // Local Parameters
    // =========================================================================
    localparam INTERNAL_BW  = 64;   // 48 would be sufficient but why not
    localparam COEF_BW      = 16;   // bitwidth of the filterbank coefficients
    localparam INPUT_LEN    = 129;  // length of the power spectrum
    localparam NUM_BOUNDARY = 16;   // number of triangle boundary indices
                                    // Signals when a MFCC coefficient is done
    localparam BOUNDARY_BW  = 8;

    // =========================================================================
    // Signal Declarations
    // =========================================================================
    reg [COEF_BW - 1 : 0] coef;  // filters 0,2,...30 (even)
                                                     // or      1,3,...31 (odd)
    reg [BOUNDARY_BW - 1 : 0] boundary;  // boundaries

    // =========================================================================
    // Element counter
    // =========================================================================
    reg [BOUNDARY_BW - 1 : 0] elem_counter;
    always @(posedge clk_i) begin
        if (!rst_n_i | !en_i) begin
            elem_counter <= 'd0;
        end else begin
            if (last_i) begin
                elem_counter <= 'd0;
            end else if (valid_i) begin
                elem_counter <= elem_counter + 'd1;
            end else begin
                elem_counter <= 'd0;
            end
        end
    end

    // =========================================================================
    // Boundary counter
    // =========================================================================
    reg [BOUNDARY_BW - 1 : 0] boundary_counter;
    // wire at_boundary = (boundary[boundary_counter] == elem_counter);
    wire at_boundary = (boundary == elem_counter);
    always @(posedge clk_i) begin
        if (!rst_n_i | !en_i) begin
            boundary_counter <= 'd0;
        end else begin
            if (last_i) begin
                boundary_counter <= 'd0;
            end else if (at_boundary & (boundary_counter == NUM_BOUNDARY - 1)) begin
                boundary_counter <= 'd0;
            end else if (at_boundary) begin
                boundary_counter <= boundary_counter + 'd1;
            end else begin
                boundary_counter <= boundary_counter;
            end
        end
    end

    // =========================================================================
    // Running sum
    // =========================================================================
    // Stores the running sum for an output coefficient up to but not
    // including the last element.
    reg [INTERNAL_BW - 1 : 0] sum;
    always @(posedge clk_i) begin
        if (!rst_n_i | !en_i) begin
            sum <= 'd0;
        end else begin
            if (at_boundary) begin  // reset the running sum at boundaries
                sum <= 'd0;
            end else if (valid_i) begin
                // sum <= sum + (data_i * coef[elem_counter]);
                sum <= sum + (data_i * coef);
            end else begin
                sum <= 'd0;
            end
        end
    end

    // wire [INTERNAL_BW - 1 : 0] sum_result = sum + (data_i * coef[elem_counter]);
    wire [INTERNAL_BW - 1 : 0] sum_result = sum + (data_i * coef);

    // =========================================================================
    // Output Assignment
    // =========================================================================
    assign valid_o = (en_i & at_boundary);
    assign data_o = sum_result >> COEF_BW;
    assign last_o = last_i;

    // =========================================================================
    // ROM Memories for filterbank coefficients and boundary indices
    // =========================================================================
    // reg [COEF_BW - 1 : 0] coef [0 : INPUT_LEN - 1];  // filters 0,2,...30 (even)
    //                                                  // or      1,3,...31 (odd)
    // reg [BOUNDARY_BW - 1 : 0] boundary [0 : NUM_BOUNDARY - 1];  // boundaries

    generate
    if (COEFFILE == "coef_even.hex") begin
        always @(*) begin
            case(elem_counter)
                0   : coef = 'h0000;
                1   : coef = 'h0000;
                2   : coef = 'h0000;
                3   : coef = 'h0000;
                4   : coef = 'h0000;
                5   : coef = 'hffff;
                6   : coef = 'h7fff;
                7   : coef = 'h0000;
                8   : coef = 'hffff;
                9   : coef = 'h0000;
                10  : coef = 'h7fff;
                11  : coef = 'hffff;
                12  : coef = 'h0000;
                13  : coef = 'h7fff;
                14  : coef = 'hffff;
                15  : coef = 'h0000;
                16  : coef = 'h7fff;
                17  : coef = 'hffff;
                18  : coef = 'h7fff;
                19  : coef = 'h0000;
                20  : coef = 'h7fff;
                21  : coef = 'hffff;
                22  : coef = 'haaaa;
                23  : coef = 'h5555;
                24  : coef = 'h0000;
                25  : coef = 'h7fff;
                26  : coef = 'hffff;
                27  : coef = 'h7fff;
                28  : coef = 'h0000;
                29  : coef = 'h5555;
                30  : coef = 'haaaa;
                31  : coef = 'hffff;
                32  : coef = 'haaaa;
                33  : coef = 'h5555;
                34  : coef = 'h0000;
                35  : coef = 'h5555;
                36  : coef = 'haaaa;
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
                100 : coef = 'h9248;
                101 : coef = 'hb6da;
                102 : coef = 'hdb6c;
                103 : coef = 'hffff;
                104 : coef = 'hdfff;
                105 : coef = 'hbfff;
                106 : coef = 'h9fff;
                107 : coef = 'h7fff;
                108 : coef = 'h5fff;
                109 : coef = 'h3fff;
                110 : coef = 'h1fff;
                111 : coef = 'h0000;
                112 : coef = 'h1fff;
                113 : coef = 'h3fff;
                114 : coef = 'h5fff;
                115 : coef = 'h7fff;
                116 : coef = 'h9fff;
                117 : coef = 'hbfff;
                118 : coef = 'hdfff;
                119 : coef = 'hffff;
                120 : coef = 'he38d;
                121 : coef = 'hc71b;
                122 : coef = 'haaaa;
                123 : coef = 'h8e38;
                124 : coef = 'h71c6;
                125 : coef = 'h5555;
                126 : coef = 'h38e3;
                127 : coef = 'h1c71;
                128 : coef = 'h0000;
            endcase
        end
    end
    endgenerate

    generate
    if (BOUNDARYFILE == "boundary_even.hex") begin
        always @(*) begin
            case(boundary_counter)
                0   : boundary = 'h07;
                1   : boundary = 'h09;
                2   : boundary = 'h0c;
                3   : boundary = 'h0f;
                4   : boundary = 'h13;
                5   : boundary = 'h18;
                6   : boundary = 'h1c;
                7   : boundary = 'h22;
                8   : boundary = 'h29;
                9   : boundary = 'h30;
                10  : boundary = 'h38;
                11  : boundary = 'h42;
                12  : boundary = 'h4d;
                13  : boundary = 'h59;
                14  : boundary = 'h67;
                15  : boundary = 'h77;
            endcase
        end
    end else begin
        always @(*) begin
            case(boundary_counter)
                0   : boundary = 'h08;
                1   : boundary = 'h0b;
                2   : boundary = 'h0e;
                3   : boundary = 'h11;
                4   : boundary = 'h15;
                5   : boundary = 'h1a;
                6   : boundary = 'h1f;
                7   : boundary = 'h25;
                8   : boundary = 'h2c;
                9   : boundary = 'h34;
                10  : boundary = 'h3d;
                11  : boundary = 'h47;
                12  : boundary = 'h53;
                13  : boundary = 'h60;
                14  : boundary = 'h6f;
                15  : boundary = 'h80;
            endcase
        end
    end
    endgenerate

    initial begin
        // $display("reading from: %s", COEFFILE);
        // $display("reading from: %s", BOUNDARYFILE);
        // $readmemh(COEFFILE, coef);
        // $readmemh(BOUNDARYFILE, boundary);

        // =====================================================================
        // Simulation Only Waveform Dump (.vcd export)
        // =====================================================================
        `ifdef COCOTB_SIM
        `ifndef SCANNED
        `define SCANNED
        $dumpfile ("wave.vcd");
        $dumpvars (0, filterbank_half);
        #1;
        `endif
        `endif
    end

endmodule
