eldrickm/wakey_wakey/pd/caravel_integration/verilog/rtl/design.v

// SPDX-FileCopyrightText: 2020 Efabless Corporation
//
// Licensed under the Apache License, Version 2.0 (the "License");
// you may not use this file except in compliance with the License.
// You may obtain a copy of the License at
//
//      http://www.apache.org/licenses/LICENSE-2.0
//
// Unless required by applicable law or agreed to in writing, software
// distributed under the License is distributed on an "AS IS" BASIS,
// WITHOUT WARRANTIES OR CONDITIONS OF ANY KIND, either express or implied.
// See the License for the specific language governing permissions and
// limitations under the License.
// SPDX-License-Identifier: Apache-2.0

// `default_nettype none

`ifndef MPRJ_IO_PADS
    `define MPRJ_IO_PADS 38
`endif

/*
 *-------------------------------------------------------------
 *
 * user_proj_example
 *
 * Instatiates WakeyWakey in user_proj_example for Caravel integration
 *-------------------------------------------------------------
 */

module user_proj_example (
`ifdef USE_POWER_PINS
    // inout vdda1,	// User area 1 3.3V supply
    // inout vdda2,	// User area 2 3.3V supply
    // inout vssa1,	// User area 1 analog ground
    // inout vssa2,	// User area 2 analog ground
    inout vccd1,	// User area 1 1.8V supply
    inout vccd2,	// User area 2 1.8v supply
    inout vssd1,	// User area 1 digital ground
    inout vssd2,	// User area 2 digital ground
`endif

    input wire user_clock2,

    // Wishbone Slave ports (WB MI A)
    input wire wb_clk_i,
    input wire wb_rst_i,
    input wire wbs_stb_i,
    input wire wbs_cyc_i,
    input wire wbs_we_i,
    input wire [3:0] wbs_sel_i,
    input wire [31:0] wbs_dat_i,
    input wire [31:0] wbs_adr_i,
    output wire wbs_ack_o,
    output wire [31:0] wbs_dat_o,

    // Logic Analyzer Signals
    input  wire [127:0] la_data_in,
    output wire [127:0] la_data_out,
    input  wire [127:0] la_oenb,

    // IOs
    input  wire [`MPRJ_IO_PADS-1:0] io_in,
    output wire [`MPRJ_IO_PADS-1:0] io_out,
    output wire [`MPRJ_IO_PADS-1:0] io_oeb,

    // IRQ
    output wire [2:0] irq
);

    // =========================================================================
    // Wakey Wakey External I/O Declarations
    // =========================================================================
    wire wake;
    `ifndef COCOTB_SIM
    wire pdm_data;
    wire pdm_clk;
    `endif
    wire vad;

    // =========================================================================
    // Wakey Wakey Inputs
    // =========================================================================
    `ifdef COCOTB_SIM
    localparam DFE_OUTPUT_BW = 8;
    wire [DFE_OUTPUT_BW - 1 : 0] dfe_data = io_in[DFE_OUTPUT_BW - 1 : 0];  // 7-0
    wire dfe_valid                        = io_in[DFE_OUTPUT_BW];  // 8
    `else
    assign pdm_data = io_in[36];
    `endif
    assign vad = io_in[34];

    // =========================================================================
    // Wakey Wakey Instantiation
    // =========================================================================
    wakey_wakey wakey_wakey_inst (
        // clock and reset
        .clk_i(wb_clk_i),
        .rst_n_i(~wb_rst_i),

        // wishbone slave ports (wb mi a)
        .wbs_stb_i(wbs_stb_i),
        .wbs_cyc_i(wbs_cyc_i),
        .wbs_we_i(wbs_we_i),
        .wbs_sel_i(wbs_sel_i),
        .wbs_dat_i(wbs_dat_i),
        .wbs_adr_i(wbs_adr_i),
        .wbs_ack_o(wbs_ack_o),
        .wbs_dat_o(wbs_dat_o),

        // logic analyzer signals
        .la_data_in_i(la_data_in),
        .la_data_out_o(la_data_out),
        .la_oenb_i(la_oenb),

        // microphone i/o
        `ifdef COCOTB_SIM
        .dfe_data(dfe_data),  // bypass DFE for test bench
        .dfe_valid(dfe_valid),
        `else
        .pdm_data_i(pdm_data),
        .pdm_clk_o(pdm_clk),
        `endif
        .vad_i(vad),

        // wake output
        .wake_o_muxed(wake)
    );

    // =========================================================================
    // Pin Directions (Output Enable)
    // =========================================================================
    assign io_oeb[37] = 1'b0;       // wake_o
    assign io_oeb[36] = 1'b1;       // pdm_data_i
    assign io_oeb[35] = 1'b0;       // pdm_clk_o
    assign io_oeb[34] = 1'b1;       // vad_i
    assign io_oeb[33:0] = 34'b1;    // unused, except by test bench

    // =========================================================================
    // Wakey Wakey Outputs
    // =========================================================================
    assign io_out[37] = wake;       // wake_o
    assign io_out[36] = 1'b0;       // pdm_data_i
    `ifdef COCOTB_SIM
    assign io_out[35] = 1'b0;       // no pdm clock for test bench
    `else
    assign io_out[35] = pdm_clk;    // pdm_clk_o
    `endif
    assign io_out[34] = 1'b0;       // vad_i
    assign io_out[33:0] = 34'b0;    // unused


    // =========================================================================
    // IRQ
    // =========================================================================
    assign irq = 3'b000;            // unused

    // =========================================================================
    // Simulation Only Waveform Dump (.vcd export)
    // =========================================================================
    `ifdef COCOTB_SIM
    `ifndef SCANNED
    `define SCANNED
    initial begin
      $dumpfile ("wave.vcd");
      $dumpvars (0, user_proj_example);
      #1;
    end
    `endif
    `endif

endmodule
// =============================================================================
// Module:       Wakey Wakey
// Design:       Eldrick Millares & Matthew Pauly
// Verification: Eldrick Millares & Matthew Pauly
// Notes:
// =============================================================================

module wakey_wakey (
    // clock and reset
    input           clk_i,
    input           rst_n_i,

    // wishbone slave ports (wb mi a)
    input           wbs_stb_i,
    input           wbs_cyc_i,
    input           wbs_we_i,
    input  [3  : 0] wbs_sel_i,
    input  [31 : 0] wbs_dat_i,
    input  [31 : 0] wbs_adr_i,
    output          wbs_ack_o,
    output [31 : 0] wbs_dat_o,

    // logic analyzer signals
    input  [127:0] la_data_in_i,
    output [127:0] la_data_out_o,
    input  [127:0] la_oenb_i,

    // microphone i/o
    `ifdef COCOTB_SIM
    input [DFE_OUTPUT_BW - 1 : 0] dfe_data,  // bypass DFE for test bench
    input                         dfe_valid,
    `else
    input           pdm_data_i,
    output          pdm_clk_o,
    `endif
    input           vad_i,  // voice activity detection

    // wake output
    output wake_o_muxed
);
    localparam F_SYSTEM_CLK = 16000000;

    // =========================================================================
    // CFG - System Configuration
    // =========================================================================
    localparam CONV1_BANK_BW = 3;
    localparam CONV1_ADDR_BW = 3;
    localparam CONV1_VECTOR_BW = 104;
    localparam CONV2_BANK_BW = 3;
    localparam CONV2_ADDR_BW = 4;
    localparam CONV2_VECTOR_BW = 64;
    localparam FC_BANK_BW = 2;
    localparam FC_ADDR_BW = 8;
    localparam FC_BIAS_BW = 32;
    localparam WISHBONE_BASE_ADDR = 32'h30000000;

    // conv1 memory configuration
    wire                                  conv1_rd_en;
    wire                                  conv1_wr_en;
    wire        [CONV1_BANK_BW - 1 : 0]   conv1_rd_wr_bank;
    wire        [CONV1_ADDR_BW - 1 : 0]   conv1_rd_wr_addr;
    wire signed [CONV1_VECTOR_BW - 1 : 0] conv1_wr_data;
    wire signed [CONV1_VECTOR_BW - 1 : 0] conv1_rd_data;

    // conv2 memory configuration
    wire                                  conv2_rd_en;
    wire                                  conv2_wr_en;
    wire        [CONV2_BANK_BW - 1 : 0]   conv2_rd_wr_bank;
    wire        [CONV2_ADDR_BW - 1 : 0]   conv2_rd_wr_addr;
    wire signed [CONV2_VECTOR_BW - 1 : 0] conv2_wr_data;
    wire signed [CONV2_VECTOR_BW - 1 : 0] conv2_rd_data;

    // fc memory configuration
    wire                                  fc_rd_en;
    wire                                  fc_wr_en;
    wire        [FC_BANK_BW - 1 : 0]      fc_rd_wr_bank;
    wire        [FC_ADDR_BW - 1 : 0]      fc_rd_wr_addr;
    wire signed [FC_BIAS_BW - 1 : 0]      fc_wr_data;
    wire signed [FC_BIAS_BW - 1 : 0]      fc_rd_data;

    cfg #(
        .CONV1_BANK_BW(CONV1_BANK_BW),
        .CONV1_ADDR_BW(CONV1_ADDR_BW),
        .CONV1_VECTOR_BW(CONV1_VECTOR_BW),
        .CONV2_BANK_BW(CONV2_BANK_BW),
        .CONV2_ADDR_BW(CONV2_ADDR_BW),
        .CONV2_VECTOR_BW(CONV2_VECTOR_BW),
        .FC_BANK_BW(FC_BANK_BW),
        .FC_ADDR_BW(FC_ADDR_BW),
        .FC_BIAS_BW(FC_BIAS_BW),
        .WISHBONE_BASE_ADDR(WISHBONE_BASE_ADDR)
    ) cfg_inst (
        // clock and reset
        .clk_i(clk_i),
        .rst_n_i(rst_n_i),

        // wishbone slave ports (wb mi a)
        .wbs_stb_i(wbs_stb_i),
        .wbs_cyc_i(wbs_cyc_i),
        .wbs_we_i(wbs_we_i),
        .wbs_sel_i(wbs_sel_i),
        .wbs_dat_i(wbs_dat_i),
        .wbs_adr_i(wbs_adr_i),
        .wbs_ack_o(wbs_ack_o),
        .wbs_dat_o(wbs_dat_o),

        // conv1 memory configuration
        .conv1_rd_en_o(conv1_rd_en),
        .conv1_wr_en_o(conv1_wr_en),
        .conv1_rd_wr_bank_o(conv1_rd_wr_bank),
        .conv1_rd_wr_addr_o(conv1_rd_wr_addr),
        .conv1_wr_data_o(conv1_wr_data),
        .conv1_rd_data_i(conv1_rd_data),

        // conv2 memory configuration
        .conv2_rd_en_o(conv2_rd_en),
        .conv2_wr_en_o(conv2_wr_en),
        .conv2_rd_wr_bank_o(conv2_rd_wr_bank),
        .conv2_rd_wr_addr_o(conv2_rd_wr_addr),
        .conv2_wr_data_o(conv2_wr_data),
        .conv2_rd_data_i(conv2_rd_data),

        // fc memory configuration
        .fc_rd_en_o(fc_rd_en),
        .fc_wr_en_o(fc_wr_en),
        .fc_rd_wr_bank_o(fc_rd_wr_bank),
        .fc_rd_wr_addr_o(fc_rd_wr_addr),
        .fc_wr_data_o(fc_wr_data),
        .fc_rd_data_i(fc_rd_data)
    );

    // =========================================================================
    // CTL - Pipeline control
    // =========================================================================
    wire pipeline_en;
    wire pipeline_en_muxed;
    wire wake_valid;  // driven by WRD
    wire wake_valid_muxed;

    ctl #(
        .F_SYSTEM_CLK(F_SYSTEM_CLK)
    ) ctl_inst (
        .clk_i(clk_i),
        .rst_n_i(rst_n_i),

        .vad_i(vad_i),

        .wake_valid_i(wake_valid_muxed),

        .en_o(pipeline_en)
    );

    // =========================================================================
    // DFE - Digital Front End
    // =========================================================================
    localparam DFE_OUTPUT_BW = 8;

    wire [DFE_OUTPUT_BW - 1 : 0] dfe_data_muxed;
    wire                         dfe_valid_muxed;
    `ifndef COCOTB_SIM
    wire pdm_data_i_muxed;
    wire [DFE_OUTPUT_BW - 1 : 0] dfe_data;
    wire                         dfe_valid;

    dfe dfe_inst (
        // clock, reset, and enable
        .clk_i(clk_i),
        .rst_n_i(rst_n_i),
        .en_i(pipeline_en_muxed),

        // pdm input
        .pdm_data_i(pdm_data_i_muxed),

        // pdm clock output
        .pdm_clk_o(pdm_clk_o),

        // streaming output
        .data_o(dfe_data),
        .valid_o(dfe_valid)
    );
    `endif

    // =========================================================================
    // ACO - Acoustic Featurizer
    // =========================================================================
    localparam ACO_OUTPUT_BW = 8 * 13;

    wire [ACO_OUTPUT_BW - 1 : 0] aco_data;
    wire                         aco_valid;
    wire                         aco_last;
    wire [ACO_OUTPUT_BW - 1 : 0] aco_data_muxed;
    wire                         aco_valid_muxed;
    wire                         aco_last_muxed;

    aco aco_inst (
        // clock, reset, and enable
        .clk_i(clk_i),
        .rst_n_i(rst_n_i),
        .en_i(pipeline_en_muxed),

        // streaming input
        .data_i(dfe_data_muxed),
        .valid_i(dfe_valid_muxed),

        // streaming output
        .data_o(aco_data),
        .valid_o(aco_valid),
        .last_o(aco_last)
    );

    // =========================================================================
    // WRD - Word Recognition DNN Accelerator Module
    // =========================================================================
    wire wrd_ready;
    wire wake_o;

    wrd wrd_inst (
        // clock and reset
        .clk_i(clk_i),
        .rst_n_i(rst_n_i & pipeline_en_muxed),

        // streaming input
        .data_i(aco_data_muxed),
        .valid_i(aco_valid_muxed),
        .last_i(aco_last_muxed),
        .ready_o(wrd_ready),

        // wake pin
        .wake_o(wake_o),
        .wake_valid(wake_valid),

        // conv1 memory configuration
        .conv1_rd_en_i(conv1_rd_en),
        .conv1_wr_en_i(conv1_wr_en),
        .conv1_rd_wr_bank_i(conv1_rd_wr_bank),
        .conv1_rd_wr_addr_i(conv1_rd_wr_addr),
        .conv1_wr_data_i(conv1_wr_data),
        .conv1_rd_data_o(conv1_rd_data),

        // conv2 memory configuration
        .conv2_rd_en_i(conv2_rd_en),
        .conv2_wr_en_i(conv2_wr_en),
        .conv2_rd_wr_bank_i(conv2_rd_wr_bank),
        .conv2_rd_wr_addr_i(conv2_rd_wr_addr),
        .conv2_wr_data_i(conv2_wr_data),
        .conv2_rd_data_o(conv2_rd_data),

        // fc memory configuration
        .fc_rd_en_i(fc_rd_en),
        .fc_wr_en_i(fc_wr_en),
        .fc_rd_wr_bank_i(fc_rd_wr_bank),
        .fc_rd_wr_addr_i(fc_rd_wr_addr),
        .fc_wr_data_i(fc_wr_data),
        .fc_rd_data_o(fc_rd_data)
    );

    // =========================================================================
    // DBG - Debug Logic Analyzer
    // =========================================================================
    dbg #(
        .DFE_OUTPUT_BW(DFE_OUTPUT_BW),
        .ACO_OUTPUT_BW(ACO_OUTPUT_BW)
    ) dbg_inst (
        .clk_i(clk_i),
        .rst_n_i(rst_n_i),

        .la_data_in_i(la_data_in_i),
        .la_data_out_o(la_data_out_o),
        .la_oenb_i(la_oenb_i),

        // ctl
        .ctl_pipeline_en_i(pipeline_en),
        .ctl_pipeline_en_o(pipeline_en_muxed),

        `ifndef COCOTB_SIM
        // mic -> dfe
        .mic_pdm_data_i(pdm_data_i),
        .mic_pdm_data_o(pdm_data_i_muxed),
        `endif

        // dfe -> aco
        .dfe_data_i(dfe_data),
        .dfe_valid_i(dfe_valid),
        .dfe_data_o(dfe_data_muxed),
        .dfe_valid_o(dfe_valid_muxed),

        // aco -> wrd
        .aco_data_i(aco_data),
        .aco_valid_i(aco_valid),
        .aco_last_i(aco_last),
        .aco_data_o(aco_data_muxed),
        .aco_valid_o(aco_valid_muxed),
        .aco_last_o(aco_last_muxed),

        // wrd -> wake
        .wrd_wake_i(wake_o),
        .wrd_wake_valid_i(wake_valid),
        .wrd_wake_o(wake_o_muxed),
        .wrd_wake_valid_o(wake_valid_muxed)
    );

    // =========================================================================
    // Simulation Only Waveform Dump (.vcd export)
    // =========================================================================
    `ifdef COCOTB_SIM
    `ifndef SCANNED
    `define SCANNED
    initial begin
      $dumpfile ("wave.vcd");
      $dumpvars (0, wakey_wakey);
      #1;
    end
    `endif
    `endif

endmodule
// =============================================================================
// Module:       Configuration
// Design:       Eldrick Millares
// Verification: Matthew Pauly
// Notes:
// User address space goes from 0x3000_0000 to 0x7FFF_FFFF
// INFO: Design not sensitized to cyc_i; only strobe is needed if trust wb
// INFO: Wishbone ack may be one cycle too early, add NOP to firmware if needed
// =============================================================================

module cfg #(
    parameter CONV1_BANK_BW = 3,
    parameter CONV1_ADDR_BW = 3,
    parameter CONV1_VECTOR_BW = 104,
    parameter CONV2_BANK_BW = 3,
    parameter CONV2_ADDR_BW = 4,
    parameter CONV2_VECTOR_BW = 64,
    parameter FC_BANK_BW = 2,
    parameter FC_ADDR_BW = 8,
    parameter FC_BIAS_BW = 32,
    parameter WISHBONE_BASE_ADDR = 32'h30000000
)(
    // clock and reset
    input                                   clk_i,
    input                                   rst_n_i,

    // wishbone slave ports (wb mi a)
    input                                   wbs_stb_i,
    input                                   wbs_cyc_i,
    input                                   wbs_we_i,
    input         [3  : 0]                  wbs_sel_i,
    input         [31 : 0]                  wbs_dat_i,
    input         [31 : 0]                  wbs_adr_i,
    output                                  wbs_ack_o,
    output reg    [31 : 0]                  wbs_dat_o,

    // conv1 memory configuration
    output                                  conv1_rd_en_o,
    output                                  conv1_wr_en_o,
    output        [CONV1_BANK_BW - 1 : 0]   conv1_rd_wr_bank_o,
    output        [CONV1_ADDR_BW - 1 : 0]   conv1_rd_wr_addr_o,
    output signed [CONV1_VECTOR_BW - 1 : 0] conv1_wr_data_o,
    input  signed [CONV1_VECTOR_BW - 1 : 0] conv1_rd_data_i,

    // conv2 memory configuration
    output                                  conv2_rd_en_o,
    output                                  conv2_wr_en_o,
    output        [CONV2_BANK_BW - 1 : 0]   conv2_rd_wr_bank_o,
    output        [CONV2_ADDR_BW - 1 : 0]   conv2_rd_wr_addr_o,
    output signed [CONV2_VECTOR_BW - 1 : 0] conv2_wr_data_o,
    input  signed [CONV2_VECTOR_BW - 1 : 0] conv2_rd_data_i,

    // fc memory configuration
    output                                  fc_rd_en_o,
    output                                  fc_wr_en_o,
    output        [FC_BANK_BW - 1 : 0]      fc_rd_wr_bank_o,
    output        [FC_ADDR_BW - 1 : 0]      fc_rd_wr_addr_o,
    output signed [FC_BIAS_BW - 1 : 0]      fc_wr_data_o,
    input  signed [FC_BIAS_BW - 1 : 0]      fc_rd_data_i
);

    // =========================================================================
    // Wishbone Address Space
    // =========================================================================
    localparam ADDR   = WISHBONE_BASE_ADDR + 'h00;
    localparam CTRL   = WISHBONE_BASE_ADDR + 'h04;
    localparam DATA_0 = WISHBONE_BASE_ADDR + 'h08;
    localparam DATA_1 = WISHBONE_BASE_ADDR + 'h0C;
    localparam DATA_2 = WISHBONE_BASE_ADDR + 'h10;
    localparam DATA_3 = WISHBONE_BASE_ADDR + 'h14;


    // =========================================================================
    // Wakey Wakey Address Space
    // =========================================================================
    localparam CONV1_WEIGHT0_START = 'h000;
    localparam CONV1_WEIGHT0_END   = 'h007;
    localparam CONV1_WEIGHT1_START = 'h010;
    localparam CONV1_WEIGHT1_END   = 'h017;
    localparam CONV1_WEIGHT2_START = 'h020;
    localparam CONV1_WEIGHT2_END   = 'h027;
    localparam CONV1_BIAS_START    = 'h030;
    localparam CONV1_BIAS_END      = 'h037;
    localparam CONV1_SHIFT_START   = 'h040;
    localparam CONV1_SHIFT_END     = 'h040;

    localparam CONV2_WEIGHT0_START = 'h050;
    localparam CONV2_WEIGHT0_END   = 'h05F;
    localparam CONV2_WEIGHT1_START = 'h060;
    localparam CONV2_WEIGHT1_END   = 'h06F;
    localparam CONV2_WEIGHT2_START = 'h070;
    localparam CONV2_WEIGHT2_END   = 'h07F;
    localparam CONV2_BIAS_START    = 'h080;
    localparam CONV2_BIAS_END      = 'h08F;
    localparam CONV2_SHIFT_START   = 'h090;
    localparam CONV2_SHIFT_END     = 'h090;

    localparam FC_WEIGHT0_START    = 'h100;
    localparam FC_WEIGHT0_END      = 'h1CF;
    localparam FC_WEIGHT1_START    = 'h200;
    localparam FC_WEIGHT1_END      = 'h2CF;
    localparam FC_BIAS_0_START     = 'h300;
    localparam FC_BIAS_0_END       = 'h300;
    localparam FC_BIAS_1_START     = 'h400;
    localparam FC_BIAS_1_END       = 'h400;


    // =========================================================================
    // Wishbone Addressable Registers
    // =========================================================================
    reg [31 : 0] addr;
    reg [31 : 0] ctrl;
    reg [31 : 0] data_0;
    reg [31 : 0] data_1;
    reg [31 : 0] data_2;
    reg [31 : 0] data_3;


    // =========================================================================
    // Wishbone Addressing Logic
    // =========================================================================
    // shorthand for this peripheral is selected and we're writing
    wire wr_active  = wbs_stb_i && wbs_we_i;

    // shorthand for wishbone addressable registers being addressed
    wire adr_addr   = wbs_adr_i == ADDR;
    wire adr_ctrl   = wbs_adr_i == CTRL;
    wire adr_data_0 = wbs_adr_i == DATA_0;
    wire adr_data_1 = wbs_adr_i == DATA_1;
    wire adr_data_2 = wbs_adr_i == DATA_2;
    wire adr_data_3 = wbs_adr_i == DATA_3;


    // =========================================================================
    // Module Selection Logic
    // =========================================================================
    wire conv1_sel = (addr >= CONV1_WEIGHT0_START) && (addr <= CONV1_SHIFT_END);
    wire conv2_sel = (addr >= CONV2_WEIGHT0_START) && (addr <= CONV2_SHIFT_END);
    wire fc_sel    = (addr >= FC_WEIGHT0_START)    && (addr <= FC_BIAS_1_END);


    // =========================================================================
    // Bank Selection Logic
    // =========================================================================
    reg [CONV1_BANK_BW - 1 : 0] conv1_rd_wr_bank;
    reg [CONV2_BANK_BW - 1 : 0] conv2_rd_wr_bank;
    reg [FC_BANK_BW - 1 : 0]    fc_rd_wr_bank;

    always @(posedge clk_i) begin
        if (!rst_n_i) begin
            conv1_rd_wr_bank <= 0;
            conv2_rd_wr_bank <= 0;
            fc_rd_wr_bank    <= 0;
        end else begin
            // conv1 address space is laid out so we can use the upper 4 bits in
            // the LSB to select the bank
            conv1_rd_wr_bank <= addr[6:4];

            // conv2 address space is laid out so we can use the upper 4 bits in
            // the LSB, minus 5, to select the bank
            conv2_rd_wr_bank <= addr[6:4] - 3'd5;

            // fc address space is laid out so we can use the lower 2 bits in
            // the 2nd byte, minus 1, to select the bank
            fc_rd_wr_bank    <= addr[9:8] - 2'd1;
        end
    end

    assign conv1_rd_wr_bank_o = conv1_rd_wr_bank;
    assign conv2_rd_wr_bank_o = conv2_rd_wr_bank;
    assign fc_rd_wr_bank_o    = fc_rd_wr_bank;


    // =========================================================================
    // Address Assignment
    // =========================================================================
    assign conv1_rd_wr_addr_o = addr[2:0];
    assign conv2_rd_wr_addr_o = addr[3:0];
    assign fc_rd_wr_addr_o    = addr[7:0];

    // =========================================================================
    // Data Assignment
    // =========================================================================
    assign conv1_wr_data_o = {data_3[7:0], data_2, data_1, data_0};
    assign conv2_wr_data_o =                      {data_1, data_0};
    assign fc_wr_data_o    =                              {data_0};

    // =========================================================================
    // Address Register
    // =========================================================================
    always @(posedge clk_i) begin
        if (!rst_n_i) begin
            addr <= 'h0;
        end else begin
            addr <= (wr_active && adr_addr) ? wbs_dat_i : addr;
        end
    end

    // =========================================================================
    // Control Register
    // =========================================================================
    always @(posedge clk_i) begin
        if (!rst_n_i) begin
            ctrl <= 'h0;
        end else begin
            // self clearing register
            ctrl <= (wr_active && adr_ctrl) ? wbs_dat_i : 0;
        end
    end

    // =========================================================================
    // Wishbone Read
    // =========================================================================
    always @(posedge clk_i) begin
        if (!rst_n_i) begin
            wbs_dat_o <= 'h0;
        end else begin
            if (wbs_stb_i) begin
                case (wbs_adr_i)
                    ADDR: begin
                        wbs_dat_o <= addr;
                    end
                    CTRL: begin
                        wbs_dat_o <= ctrl;
                    end
                    DATA_0: begin
                        wbs_dat_o <= data_0;
                    end
                    DATA_1: begin
                        wbs_dat_o <= data_1;
                    end
                    DATA_2: begin
                        wbs_dat_o <= data_2;
                    end
                    DATA_3: begin
                        wbs_dat_o <= data_3;
                    end
                    default: begin
                        wbs_dat_o <= 'h0;
                    end
                endcase
            end
        end
    end


    // =========================================================================
    // Wishbone Acknowledge
    // =========================================================================
    reg wbs_ack;
    reg wbs_ack_q;

    always @(posedge clk_i) begin
        if (!rst_n_i) begin
            wbs_ack   <= 1'b0;
            wbs_ack_q <= 1'b0;
        end else begin
            wbs_ack   <= wbs_stb_i;
            wbs_ack_q <= wbs_ack;
        end
    end

    assign wbs_ack_o = wbs_ack_q;


    // =========================================================================
    // Store
    // =========================================================================
    assign conv1_wr_en_o = (ctrl == 'h1) && (conv1_sel);
    assign conv2_wr_en_o = (ctrl == 'h1) && (conv2_sel);
    assign fc_wr_en_o    = (ctrl == 'h1) && (fc_sel);


    // =========================================================================
    // Load
    // =========================================================================
    assign conv1_rd_en_o = (ctrl == 'h2) && (conv1_sel);
    assign conv2_rd_en_o = (ctrl == 'h2) && (conv2_sel);
    assign fc_rd_en_o    = (ctrl == 'h2) && (fc_sel);

    reg conv1_rd_en_d;
    reg conv2_rd_en_d;
    reg fc_rd_en_d;

    always @(posedge clk_i) begin
        if (!rst_n_i) begin
            conv1_rd_en_d <= 1'b0;
            conv2_rd_en_d <= 1'b0;
            fc_rd_en_d    <= 1'b0;
        end else begin
            conv1_rd_en_d <= conv1_rd_en_o;
            conv2_rd_en_d <= conv2_rd_en_o;
            fc_rd_en_d    <= fc_rd_en_o;
        end
    end


    // =========================================================================
    // Data Registers
    // =========================================================================
    always @(posedge clk_i) begin
        if (!rst_n_i) begin
            data_0 <= 'h0;
            data_1 <= 'h0;
            data_2 <= 'h0;
            data_3 <= 'h0;
        end else begin
            data_0 <= (wr_active && adr_data_0) ?   wbs_dat_i:
                      (conv1_rd_en_d) ? conv1_rd_data_i[31:0]:
                      (conv2_rd_en_d) ? conv2_rd_data_i[31:0]:
                      (fc_rd_en_d)    ?    fc_rd_data_i[31:0]:
                      data_0;
            data_1 <= (wr_active && adr_data_1) ?    wbs_dat_i:
                      (conv1_rd_en_d) ? conv1_rd_data_i[63:32]:
                      (conv2_rd_en_d) ? conv2_rd_data_i[63:32]:
                      (fc_rd_en_d)    ? 'h0:
                      data_1;
            data_2 <= (wr_active && adr_data_2) ?    wbs_dat_i:
                      (conv1_rd_en_d) ? conv1_rd_data_i[95:64]:
                      (conv2_rd_en_d) ? 'h0:
                      (fc_rd_en_d)    ? 'h0:
                      data_2;
            data_3 <= (wr_active && adr_data_3) ?     wbs_dat_i:
                      (conv1_rd_en_d) ? {24'b0, conv1_rd_data_i[103:96]}:
                      (conv2_rd_en_d) ? 'h0:
                      (fc_rd_en_d)    ? 'h0:
                      data_3;
        end
    end


    // =========================================================================
    // Simulation Only Waveform Dump (.vcd export)
    // =========================================================================
    `ifdef COCOTB_SIM
    `ifndef SCANNED
    `define SCANNED
    initial begin
      $dumpfile ("wave.vcd");
      $dumpvars (0, cfg);
      #1;
    end
    `endif
    `endif

endmodule
// =============================================================================
// Module:       CTL
// Design:       Matthew Pauly
// Verification: Eldrick Millares
// Notes:
//
// Top level module for pipeline control.
// =============================================================================

module ctl # (
    parameter F_SYSTEM_CLK = 1000  // used for unit test bench
) (
    // clock and reset
    input                                   clk_i,
    input                                   rst_n_i,

    // voice activity input 
    input                                   vad_i,

    // wake valid
    input                                   wake_valid_i,

    // enable output
    output                                  en_o
);
    // =========================================================================
    // Local Parameters
    // =========================================================================
    // 5ms empirically determined with microphone. See test/pdm_capture_test.
    // INFO: Design Compiler does not support rtoi
    // localparam COUNT_CYCLES   = $rtoi(0.005 * F_SYSTEM_CLK);
    `ifdef COCOTB_SIM
    localparam integer COUNT_CYCLES  = 1000 / 200;
    `else
    localparam integer COUNT_CYCLES  = F_SYSTEM_CLK / 200;
    `endif
    localparam COUNTER_BW            = $clog2(COUNT_CYCLES + 1);

    // =========================================================================
    // Falling Edge Detection for wake_valid_i
    // =========================================================================
    reg wake_valid_q;
    always @(posedge clk_i) begin
        if (!rst_n_i) begin
            wake_valid_q <= 'd0;
        end else begin
            wake_valid_q <= wake_valid_i;
        end
    end
    wire wake_valid_falling_edge = (wake_valid_q & !wake_valid_i);

    // =========================================================================
    // State Machine
    //
    // STATE_IDLE:              Waiting for voice activity on vad_i.
    // STATE_ON:                Wait for a falling edge on wake_valid_i
    //                            indicating that an inference just finished.
    // STATE_TIMEOUT:           Wait until 50ms has passed after turning off
    //                            pipeline and pdm clk before checking VAD
    //                            again.
    // =========================================================================
    localparam STATE_IDLE               = 2'd0,
               STATE_ON                 = 2'd1,
               STATE_TIMEOUT            = 2'd2;

    reg [1 : 0] state;
    reg [COUNTER_BW - 1 : 0] counter;

    always @(posedge clk_i) begin
        if (!rst_n_i) begin
            state <= STATE_IDLE;
            counter <= 'd0;
        end else begin
            case (state)
                STATE_IDLE: begin
                    state   <= (vad_i) ? STATE_ON : STATE_IDLE;
                    counter <= 'd0;
                end
                STATE_ON: begin
                    state   <= (wake_valid_falling_edge) ? STATE_TIMEOUT
                                                         : STATE_ON;
                    counter <= 'd0;
                end
                STATE_TIMEOUT: begin
                    state   <= (counter >= COUNT_CYCLES) ? STATE_IDLE
                                                         : STATE_TIMEOUT;
                    counter <= counter + 'd1;
                end
                default: begin
                    state   <= STATE_IDLE;
                    counter <= 'd0;
                end
            endcase
        end
    end

    // =========================================================================
    // Output Assignment
    // =========================================================================
    assign en_o = (state == STATE_ON) ? 'd1 : 'd0;

    // ========================================================================
    // Simulation Only Waveform Dump (.vcd export)
    // ========================================================================
    `ifdef COCOTB_SIM
    `ifndef SCANNED
    `define SCANNED
    initial begin
        $dumpfile ("wave.vcd");
        $dumpvars (0, ctl);
        #1;
    end
    `endif
    `endif

endmodule
// =============================================================================
// Module:       Convolution Memory
// Design:       Eldrick Millares
// Verification: Matthew Pauly
// Notes:
//
// Stores weights, biases, and shifts in different banks, numbered like so:
// [0, NUM_FILTERS-1] : Kernel weights for nth output channel
// [NUM_FILTERS]      : Bias terms for each kernel
// [NUM_FILTERS+1]    : Global shift applied to all outputs of this convolution
// =============================================================================

module conv_mem #(
    parameter BW          = 8,
    parameter BIAS_BW     = 32,
    parameter SHIFT_BW    = $clog2(BIAS_BW),
    parameter FRAME_LEN   = 50,
    parameter VECTOR_LEN  = 13,
    parameter NUM_FILTERS = 8,

    // =========================================================================
    // Local Parameters - DO NOT EDIT
    // =========================================================================
    // This unit is hard coded for width 3 filters
    parameter FILTER_LEN = 3,

    // Bitwidth Definitions
    parameter VECTOR_BW = VECTOR_LEN * BW,
    parameter ADDR_BW   = $clog2(NUM_FILTERS),
    // Number of weight banks + bias bank + shift bank
    parameter BANK_BW   = $clog2(FILTER_LEN + 2)
) (
    // clock and reset
    input                             clk_i,
    input                             rst_n_i,

    // control
    input                             cycle_en_i,

    // memory configuration
    input                             rd_en_i,
    input                             wr_en_i,
    input         [BANK_BW - 1 : 0]   rd_wr_bank_i,
    input         [ADDR_BW - 1 : 0]   rd_wr_addr_i,
    input  signed [VECTOR_BW - 1 : 0] wr_data_i,
    output signed [VECTOR_BW - 1 : 0] rd_data_o,

    // streaming output
    output signed [VECTOR_BW - 1 : 0] data0_o,
    output signed [VECTOR_BW - 1 : 0] data1_o,
    output signed [VECTOR_BW - 1 : 0] data2_o,
    output signed [BIAS_BW - 1 : 0]   bias_o,
    output        [SHIFT_BW - 1 : 0]  shift_o,
    output                            valid_o,
    output                            last_o,
    input                             ready_i
);

    // =========================================================================
    // Local Parameters
    // =========================================================================
    localparam FRAME_COUNTER_BW = $clog2(FRAME_LEN);
    localparam FILTER_COUNTER_BW = $clog2(NUM_FILTERS);

    genvar i;

    // ========================================================================
    // Convolution Memory Controller
    // ========================================================================
    // Define States
    reg [FRAME_COUNTER_BW - 1 : 0] frame_counter;
    reg [FILTER_COUNTER_BW - 1 : 0] filter_counter;

    always @(posedge clk_i) begin
        if (!rst_n_i) begin
            frame_counter <= 0;
            filter_counter <= 0;
        end else begin
            if (cycle_en_i) begin
                frame_counter <= (frame_counter < FRAME_LEN - 1) ?
                                  frame_counter + 'd1 : 'd0;
                filter_counter <= (frame_counter == FRAME_LEN - 1) ?
                                    ((filter_counter < NUM_FILTERS - 1) ?
                                     filter_counter + 1 : 'd0)
                                  : filter_counter;
            end else begin
                frame_counter <= frame_counter;
                filter_counter <= filter_counter;
            end
        end
    end

    // ========================================================================
    // Weight Memories
    // ========================================================================
    wire weight_en;
    wire                     weight_wr_en    [NUM_FILTERS - 1 : 0];
    wire [VECTOR_BW - 1 : 0] weight_data_in;
    wire [ADDR_BW - 1 : 0]   weight_addr;
    wire [VECTOR_BW - 1 : 0] weight_data_out [NUM_FILTERS - 1 : 0];

    assign weight_en      = (wr_en_i | rd_en_i | cycle_en_i);
    for (i = 0; i < FILTER_LEN; i = i + 1) begin: weight_banks_wr_en
        assign weight_wr_en[i] = (wr_en_i) & (rd_wr_bank_i == i);
    end
    assign weight_data_in = (wr_en_i) ? wr_data_i : 'd0;
    assign weight_addr    = (wr_en_i | rd_en_i) ? rd_wr_addr_i : filter_counter;

    for (i = 0; i < FILTER_LEN; i = i + 1) begin: weight_banks
        dffram #(
            .WIDTH(VECTOR_BW),
            .DEPTH(NUM_FILTERS)
        ) weight_ram_inst (
            .clk_i(clk_i),

            .wr_en_i(weight_wr_en[i]),
            .en_i(weight_en),

            .addr_i(weight_addr),
            .data_i(weight_data_in),
            .data_o(weight_data_out[i])
        );
    end

    // ========================================================================
    // Bias Memory
    // ========================================================================
    wire bias_en;
    wire                   bias_wr_en;
    wire [BIAS_BW - 1 : 0] bias_data_in;
    wire [ADDR_BW - 1 : 0] bias_addr;
    wire [BIAS_BW - 1 : 0] bias_data_out;

    assign bias_en      = (wr_en_i | rd_en_i | cycle_en_i);
    assign bias_wr_en   = (wr_en_i) & (rd_wr_bank_i == FILTER_LEN);
    assign bias_data_in = (wr_en_i) ? wr_data_i[BIAS_BW - 1 : 0] : 'd0;
    assign bias_addr    = (wr_en_i | rd_en_i) ? rd_wr_addr_i : filter_counter;

    dffram #(
        .WIDTH(BIAS_BW),
        .DEPTH(NUM_FILTERS)
    ) bias_ram_inst (
        .clk_i(clk_i),

        .wr_en_i(bias_wr_en),
        .en_i(bias_en),

        .addr_i(bias_addr),
        .data_i(bias_data_in),
        .data_o(bias_data_out)
    );

    // ========================================================================
    // Shift Memory
    // ========================================================================
    // wire shift_en;
    wire                   shift_wr_en;
    wire [SHIFT_BW - 1 : 0] shift_data_in;
    reg [SHIFT_BW - 1 : 0] shift_data_out;

    // assign shift_en      = (wr_en_i | rd_en_i | cycle_en_i);
    assign shift_wr_en   = (wr_en_i) & (rd_wr_bank_i == FILTER_LEN + 1);
    assign shift_data_in = (wr_en_i) ? wr_data_i[SHIFT_BW - 1 : 0] : 'd0;

    always @(posedge clk_i) begin
        if (shift_wr_en) begin
            shift_data_out <= shift_data_in;
        end else begin
            shift_data_out <= shift_data_out;
        end
    end

    // ========================================================================
    // Read Data Assignment
    // ========================================================================
    reg [BANK_BW - 1 : 0] rd_wr_bank_q;
    always @(posedge clk_i) begin
        if (!rst_n_i) begin
            rd_wr_bank_q <= 'b0;
        end else begin
            rd_wr_bank_q <= rd_wr_bank_i;
        end
    end

    // build array of all the output data, properly padded, to mux to rd_data_o
    wire [VECTOR_BW - 1 : 0] out_data_arr [FILTER_LEN + 1 : 0];

    for (i = 0; i < FILTER_LEN; i = i + 1) begin: weight_banks_out_data_arr
        assign out_data_arr[i] = weight_data_out[i];
    end
    assign out_data_arr[FILTER_LEN] = {{{VECTOR_BW - BIAS_BW}{1'b0}},
                                       bias_data_out};
    assign out_data_arr[FILTER_LEN + 1] = {{{VECTOR_BW - SHIFT_BW}{1'b0}},
                                           shift_data_out};

    assign rd_data_o = out_data_arr[rd_wr_bank_q];

    // ========================================================================
    // Output Assignment
    // ========================================================================
    reg cycle_en_i_q;
    always @(posedge clk_i) begin
        cycle_en_i_q <= cycle_en_i;
    end

    reg frame_last;
    always @(posedge clk_i) begin
        frame_last <= (frame_counter == FRAME_LEN - 1);
    end

    assign data0_o = weight_data_out[0];
    assign data1_o = weight_data_out[1];
    assign data2_o = weight_data_out[2];
    assign bias_o  = bias_data_out;
    assign shift_o  = shift_data_out;
    assign valid_o = cycle_en_i_q;
    assign last_o  = valid_o & frame_last;

    // ========================================================================
    // Simulation Only Waveform Dump (.vcd export)
    // ========================================================================
    `ifdef COCOTB_SIM
    `ifndef SCANNED
    `define SCANNED
    initial begin
        $dumpfile ("wave.vcd");
        $dumpvars (0, conv_mem);
        #1;
    end
    `endif
    `endif

endmodule
// ============================================================================
// Module:       Convolution Serial In, Parallel Out
// Design:       Eldrick Millares
// Verification: Matthew Pauly
// Notes:
// ============================================================================

module conv_sipo #(
    parameter BW         = 8,
    parameter FRAME_LEN  = 50,
    parameter VECTOR_LEN = 8,

    // ========================================================================
    // Local Parameters - Do Not Edit
    // ========================================================================
    parameter VECTOR_BW  = VECTOR_LEN * BW
) (
    // clock and reset
    input                      clk_i,
    input                      rst_n_i,

    // streaming input
    input  signed [BW - 1 : 0] data_i,
    input                      valid_i,
    input                      last_i,
    output                     ready_o,
 
    // streaming output
    output [VECTOR_BW - 1 : 0] data_o,
    output                     valid_o,
    output                     last_o,
    input                      ready_i
);

    genvar i;

    // ========================================================================
    // Local Parameters
    // ========================================================================
    // Bitwidth Definitions
    localparam COUNTER_BW = $clog2(FRAME_LEN);

    // =========================================================================
    // Control Logic
    // =========================================================================
    localparam STATE_IDLE   = 2'd0,
               STATE_OUTPUT = 2'd1;

    reg [1:0] state;
    reg [COUNTER_BW - 1 : 0] counter;
    reg [VECTOR_LEN - 1 : 0] fifo_sel;

    always @(posedge clk_i) begin
        if (!rst_n_i) begin
            counter <= 'd0;
            state <= STATE_IDLE;
        end else begin
            case (state)
                STATE_IDLE: begin
                    counter <= 'd0;
                    state   <= ((fifo_sel == {{VECTOR_LEN - 1{1'b0}}, 1'b1})
                               && (last_i)) ? STATE_OUTPUT : STATE_IDLE;
                end
                STATE_OUTPUT: begin
                    counter <= counter + 'd1;
                    state   <= (counter == FRAME_LEN - 1) ? STATE_IDLE :
                                                            STATE_OUTPUT;
                end
                default: begin
                    counter <= 'd0;
                    state <= STATE_IDLE;
                end
            endcase
        end
    end

    always @(posedge clk_i) begin
        if (!rst_n_i) begin
            fifo_sel <= {1'b1, {VECTOR_LEN - 1{1'b0}}};
        end else begin
            fifo_sel <= (last_i & valid_i) ?
                        {fifo_sel[0], fifo_sel[VECTOR_LEN - 1 : 1]}
                        : fifo_sel;
        end
    end

    // =========================================================================
    // FIFO Banks
    // =========================================================================
    wire [BW - 1 : 0]         fifo_din;
    wire [BW - 1 : 0]         fifo_dout [VECTOR_LEN - 1 : 0];
    wire [VECTOR_LEN - 1 : 0] fifo_enq;
    wire fifo_deq;

    assign fifo_din = data_i;
    assign fifo_deq = (state == STATE_OUTPUT);
    for (i = 0; i < VECTOR_LEN; i = i + 1) begin: create_sipo_fifo
        assign fifo_enq[i] = fifo_sel[i] && valid_i;
        fifo #(
            .DATA_WIDTH(BW),
            .FIFO_DEPTH(FRAME_LEN)
        ) fifo_inst (
            .clk_i(clk_i),
            .rst_n_i(rst_n_i),

            .enq_i(fifo_enq[i]),
            .deq_i(fifo_deq),

            .din_i(fifo_din),
            .dout_o(fifo_dout[i]),

            .full_o_n(),
            .empty_o_n()
        );
    end

    // =========================================================================
    // Output Assignment
    // =========================================================================
    // register all outputs
    reg ready_q;
    always @(posedge clk_i) begin
        if (!rst_n_i) begin
            ready_q <= 'b0;
        end else begin
            ready_q <= ready_i;
        end
    end

    for (i = 0; i < VECTOR_LEN; i = i + 1) begin: pack_output
        assign data_o[(i + 1) * BW - 1 : i * BW] = fifo_dout[i];
    end

    assign valid_o = (state == STATE_OUTPUT);
    assign ready_o = ready_q;
    assign last_o  = (counter == FRAME_LEN - 1);

    // =========================================================================
    // Simulation Only Waveform Dump (.vcd export)
    // =========================================================================
    `ifdef COCOTB_SIM
    `ifndef SCANNED
    `define SCANNED
    initial begin
        $dumpfile ("wave.vcd");
        $dumpvars (0, conv_sipo);
        #1;
    end
    `endif
    `endif

endmodule
// ============================================================================
// Max Pool
// Design: Eldrick Millares
// Verification: Matthew Pauly
// Notes:
// ============================================================================

module max_pool #(
    parameter BW = 8
) (
    // clock and reset
    input                      clk_i,
    input                      rst_n_i,

    // streaming input
    input  signed [BW - 1 : 0] data_i,
    input                      valid_i,
    input                      last_i,
    output                     ready_o,

    // streaming output
    output signed [BW - 1 : 0] data_o,
    output                     valid_o,
    output                     last_o,
    input                      ready_i
);

    // =========================================================================
    // Output Register Declaratons
    // =========================================================================
    reg signed [BW - 1 : 0] data_q, data_q2, max;
    reg valid_q, valid_q2, valid_q3, last_q, last_q2, ready_q;

    // =========================================================================
    // State Machine
    // =========================================================================
    localparam STATE_IDLE   = 2'd0,
               STATE_LOAD_1 = 2'd1,
               STATE_LOAD_2 = 2'd2,
               STATE_VALID  = 2'd3;
    reg [1:0] state;

    always @(posedge clk_i) begin
        if (!rst_n_i) begin
            state <= STATE_IDLE;
        end else begin
            case(state)
                STATE_IDLE: begin
                    state <= (valid_i) ? STATE_LOAD_1 : STATE_IDLE;
                end
                STATE_LOAD_1: begin
                    state <= (valid_i) ? STATE_LOAD_2 : STATE_IDLE;
                end
                STATE_LOAD_2: begin
                    state <= STATE_VALID;
                end
                STATE_VALID: begin
                    state <= (valid_q) ?
                             ((last_q) ? STATE_VALID : STATE_LOAD_2) :
                             STATE_IDLE;
                end
                default: begin
                end
            endcase
        end
    end

    // register all outputs
    always @(posedge clk_i) begin
        if (!rst_n_i) begin
            valid_q  <= 'b0;
            valid_q2 <= 'b0;
            valid_q3 <= 'b0;
            last_q   <= 'b0;
            last_q2  <= 'b0;
            ready_q  <= 'b0;
            data_q   <= 'b0;
            data_q2  <= 'b0;
            max      <= 'b0;
        end else begin
            valid_q  <= valid_i;
            valid_q2 <= valid_q;
            valid_q3 <= valid_q2;
            last_q   <= last_i;
            last_q2  <= last_q;
            ready_q  <= ready_i;
            data_q   <= data_i;
            data_q2  <= data_q;
            max      <= (state == STATE_VALID) ? 
                          data_q  // if 2 new data are not ready yet just
                                  // output the first one
                          : ((data_q > data_q2) ? data_q : data_q2);
        end
    end


    assign data_o  = max;
    assign valid_o = (state == STATE_VALID);
    assign last_o  = last_q2;
    assign ready_o = ready_q;

    // =========================================================================
    // Simulation Only Waveform Dump (.vcd export)
    // =========================================================================
    `ifdef COCOTB_SIM
    `ifndef SCANNED
    `define SCANNED
    initial begin
        $dumpfile ("wave.vcd");
        $dumpvars (0, max_pool);
        #1;
    end
    `endif
    `endif

endmodule
// ============================================================================
// Quantizer
// Design: Eldrick Millares
// Verification: Matthew Pauly
// Notes:
// ============================================================================

module quantizer #(
    parameter I_BW     = 32,
    parameter O_BW     = 8,
    parameter SHIFT_BW = $clog2(I_BW)
) (
    input                    clk_i,
    input                    rst_n_i,

    input [SHIFT_BW - 1 : 0] shift_i,

    input [I_BW - 1 : 0]     data_i,
    input                    valid_i,
    input                    last_i,
    output                   ready_o,

    output [O_BW - 1 : 0]    data_o,
    output                   valid_o,
    output                   last_o,
    input                    ready_i
);

    localparam [O_BW - 1 : 0] saturate_point = {1'b0, {O_BW - 1{1'b1}}};

    reg [I_BW - 1 : 0] shifted;

    always @(posedge clk_i) begin
        shifted <= (data_i >> shift_i);
    end

    wire [O_BW - 1 : 0] truncated;
    assign truncated = shifted[O_BW - 1 : 0];

    // register all outputs
    reg valid_q, last_q, ready_q;
    always @(posedge clk_i) begin
        if (!rst_n_i) begin
            valid_q <= 'b0;
            last_q  <= 'b0;
            ready_q <= 'b0;
        end else begin
            valid_q <= valid_i;
            last_q  <= last_i;
            ready_q <= ready_i;
        end
    end

    assign data_o  = (shifted > saturate_point) ? saturate_point :
                                                  shifted[O_BW - 1 : 0];
    assign valid_o = valid_q;
    assign last_o  = last_q;
    assign ready_o = ready_q;

    // =========================================================================
    // Simulation Only Waveform Dump (.vcd export)
    // =========================================================================
    `ifdef COCOTB_SIM
    `ifndef SCANNED
    `define SCANNED
    initial begin
        $dumpfile ("wave.vcd");
        $dumpvars (0, quantizer);
        #1;
    end
    `endif
    `endif

endmodule
// =============================================================================
// Module:       Recycler
// Design:       Eldrick Millares
// Verification: Matthew Pauly
// Notes:
// Constraint: FRAME_LEN > FILTER_LEN
// Constraint: FILTER_LEN == 3
// In order to change filter size, you'll have to parameterize the vec_add
// unit.
// INFO: SizedFIFO issues deque warning but functionality is correct.
// INFO: Deassertions of valid midstream not permitted
// =============================================================================

module recycler #(
    parameter BW          = 8,
    parameter FRAME_LEN   = 50,
    parameter VECTOR_LEN  = 13,
    parameter NUM_FILTERS = 8,

    // =========================================================================
    // Local Parameters - Do Not Edit
    // =========================================================================
    parameter VECTOR_BW  = VECTOR_LEN * BW
) (
    // clock and reset
    input                             clk_i,
    input                             rst_n_i,

    // streaming input
    input  signed [VECTOR_BW - 1 : 0] data_i,
    input                             valid_i,
    input                             last_i,
    output                            ready_o,

    // streaming output
    output signed [VECTOR_BW - 1 : 0] data0_o,
    output signed [VECTOR_BW - 1 : 0] data1_o,
    output signed [VECTOR_BW - 1 : 0] data2_o,
    output                            valid_o,
    output                            last_o,
    input                             ready_i
);

    genvar i;

    // =========================================================================
    // Local Parameters
    // =========================================================================
    // This unit is hard coded for width 3 filters
    localparam FILTER_LEN = 3;
    // Need to account for cycles where the ends of the featuremap wrap
    // through the shift registers, hence the extra "+ NUM_FILTERS - 1"
    localparam CYCLE_PERIOD = (FRAME_LEN + FILTER_LEN - 1);
    localparam MAX_CYCLES = NUM_FILTERS * CYCLE_PERIOD;
    // Number of cycles where we want to requeue data into the FIFO. For last
    // filter want to drop all the data and leave the FIFO empty.
    localparam MAX_CYCLES_REQUEUE = (NUM_FILTERS - 1) * CYCLE_PERIOD;

    // bitwidth definitions
    localparam COUNTER_BW = $clog2(MAX_CYCLES);
    localparam FRAME_COUNTER_BW = $clog2(FRAME_LEN + FILTER_LEN - 1);

    // ========================================================================
    // Recycler Controller
    // ========================================================================
    // Define States
    localparam STATE_IDLE    = 2'd0,
               STATE_PRELOAD = 2'd1,
               STATE_LOAD    = 2'd2,
               STATE_CYCLE   = 2'd3;

    reg [1:0] state;
    reg [COUNTER_BW - 1 : 0] counter;
    // frame_counter is used to determine when the output is invalid due to
    // having the ends of the featuremap both in the shift registers
    reg [FRAME_COUNTER_BW - 1 : 0] frame_counter;

    always @(posedge clk_i) begin
        if (!rst_n_i) begin
            counter <= 'd0;
            state <= STATE_IDLE;
        end else begin
            case (state)
                STATE_IDLE: begin
                    // FIFO State only transitions to PRELOAD on valid input
                    counter <= 'd0;
                    frame_counter <= 'd0;
                    state   <= (valid_i) ? STATE_PRELOAD : STATE_IDLE;
                end
                STATE_PRELOAD: begin
                    // In PRELOAD, we're shifting the first FILTER_LEN - 1
                    // elements into our shift register, then transition
                    // to regular LOAD where the shift register is not active
                    counter <= counter + 'd1;
                    frame_counter <= 'd0;
                    state   <= (counter == FILTER_LEN) ? STATE_LOAD :
                                                         STATE_PRELOAD;
                end
                STATE_LOAD: begin
                    // In LOAD we're just shifting enough elements until
                    // last_i is asserted
                    counter <= 'd0;
                    frame_counter <= 'd0;
                    state   <= (last_i) ? STATE_CYCLE: STATE_LOAD;
                end
                STATE_CYCLE: begin
                    // In CYCLE, we begin cycling MAX_CYCLE times.
                    // If valid_i is high, we transition straight into
                    // PRELOAD again since a new frame is immediately
                    // available.
                    // If valid_i is deasserted, we transition into IDLE
                    // and wait on the next input blocks to come in
                    counter <= counter + 'd1;
                    frame_counter <= (frame_counter < FRAME_LEN + FILTER_LEN - 1)
                                        ? frame_counter + 'd1
                                        : 'd1;
                    state   <= (counter < MAX_CYCLES - 1) ? STATE_CYCLE :
                               ((valid_i) ? STATE_PRELOAD : STATE_IDLE);
                end
                default: begin
                    counter <= 'd0;
                    frame_counter <= 'd0;
                    state   <= STATE_IDLE;
                end
            endcase
        end
    end

    // ========================================================================
    // Recycling FIFO
    // ========================================================================
    // Needed to ensure we do not drop data_i the first cycle "valid"
    // is asserted
    reg [VECTOR_BW - 1: 0] data_i_q;
    always @(posedge clk_i) begin
        data_i_q <= data_i;
    end

    // Delayed by 1 cycle since data_i_q is delayed by one cycle
    reg fifo_recycle;
    always @(posedge clk_i) begin
        fifo_recycle <= (state == STATE_CYCLE);
    end

    // FIFO Output Shift Register
    reg [VECTOR_BW - 1 : 0] fifo_out_sr [FILTER_LEN - 1 : 0];

    // Assign din to input if loading, otherwise feedback output to recycle
    wire [VECTOR_BW - 1 : 0] fifo_din;
    assign fifo_din = fifo_recycle ? fifo_out_sr[FILTER_LEN - 1] : data_i_q;

    // Always enqueue if FIFO is not idle
    wire fifo_enq;
    assign fifo_enq = (!(state == STATE_IDLE) & (counter <= MAX_CYCLES_REQUEUE));

    // Dequeue the FIFO when we begin recycling
    // or dequeue the FIFO exactly FILTER_LEN - 1 times when Preloading
    wire fifo_deq;
    assign fifo_deq = ((state == STATE_CYCLE) |
                       ((state == STATE_PRELOAD) &
                        (counter < FILTER_LEN - 1)));

    wire [VECTOR_BW - 1 : 0] fifo_dout;

    fifo #(
        .DATA_WIDTH(VECTOR_BW),
        .FIFO_DEPTH(FRAME_LEN)
    ) fifo_inst (
        .clk_i(clk_i),
        .rst_n_i(rst_n_i),

        .enq_i(fifo_enq),
        .deq_i(fifo_deq),

        .din_i(fifo_din),
        .dout_o(fifo_dout),

        .full_o_n(),
        .empty_o_n()
    );

    // FIFO Output Shift Register Enable
    wire sr_en;
    assign sr_en = (fifo_recycle | (state == STATE_PRELOAD));

    // FIFO Output Shift Register
    always @(posedge clk_i) begin
        if (sr_en) begin
            fifo_out_sr[0] <= fifo_dout;
        end
    end
    for (i = 1; i < FILTER_LEN; i = i + 1) begin: create_fifo_out_sr
        always @(posedge clk_i) begin
            if (sr_en) begin
                fifo_out_sr[i] <= fifo_out_sr[i-1];
            end
        end
    end

    // FIFO Output Valid Shift Register
    reg fifo_out_valid;
    always @(posedge clk_i) begin
        fifo_out_valid <= (state == STATE_CYCLE);
    end

    // ========================================================================
    // Output Assignment
    // ========================================================================
    assign data0_o = fifo_out_sr[0];
    assign data1_o = fifo_out_sr[1];
    assign data2_o = fifo_out_sr[2];
    // Output is not valid when both ends of the featuremap are in the shift
    // register
    assign valid_o = fifo_out_valid & (frame_counter <= FRAME_LEN);
    assign ready_o = ready_i;
    assign last_o  = last_i;

    // ========================================================================
    // Simulation Only Waveform Dump (.vcd export)
    // ========================================================================
    `ifdef COCOTB_SIM
    `ifndef SCANNED
    `define SCANNED
    initial begin
        $dumpfile ("wave.vcd");
        $dumpvars (0, recycler);
        #1;
    end
    `endif
    `endif

endmodule
// ============================================================================
// Module:       Reduction Addition
// Design:       Eldrick Millares
// Verification: Matthew Pauly
// Notes:
// ============================================================================

module red_add #(
    parameter I_BW = 18,
    parameter O_BW = 32,
    parameter VECTOR_LEN = 2
) (
    // clock and reset
    input                                       clk_i,
    input                                       rst_n_i,

    // streaming input
    input  signed [(VECTOR_LEN * I_BW) - 1 : 0] data_i,
    input                                       valid_i,
    input                                       last_i,
    output                                      ready_o,

    // streaming output
    output signed [O_BW - 1 : 0]                data_o,
    output                                      valid_o,
    output                                      last_o,
    input                                       ready_i
);

    genvar i;

    // =========================================================================
    // Input Unpacking
    // =========================================================================
    // unpacked arrays
    wire signed [I_BW - 1 : 0] data_arr [VECTOR_LEN - 1 : 0];
    wire signed [O_BW - 1 : 0] sum      [VECTOR_LEN - 1 : 0];
    reg  signed [O_BW - 1 : 0] final_sum_q;

    // unpack data input
    for (i = 0; i < VECTOR_LEN; i = i + 1) begin: unpack_inputs
        assign data_arr[i] = data_i[(i + 1) * I_BW - 1 : i * I_BW];
    end

    // =========================================================================
    // Reduction Addition
    // =========================================================================
    for (i = 1; i < VECTOR_LEN; i = i + 1) begin: reduction_sum
         if (i == 1) begin
             assign sum[i] = data_arr[i] + data_arr[i-1];
         end else begin
             assign sum[i] = sum[i-1] + data_arr[i];
         end
    end

    always @(posedge clk_i) begin
        if (!rst_n_i) begin
            final_sum_q <= 'd0;
        end else begin
            final_sum_q <= sum[VECTOR_LEN - 1];
        end
    end

    // =========================================================================
    // Output Assignment
    // =========================================================================
    // register all outputs
    reg valid_q, last_q, ready_q;
    always @(posedge clk_i) begin
        if (!rst_n_i) begin
            valid_q <= 'b0;
            last_q  <= 'b0;
            ready_q <= 'b0;
        end else begin
            valid_q <= valid_i;
            last_q  <= last_i;
            ready_q <= ready_i;
        end
    end

    assign data_o   = final_sum_q;
    assign valid_o  = valid_q;
    assign last_o   = last_q;
    assign ready_o = ready_q;

    // =========================================================================
    // Simulation Only Waveform Dump (.vcd export)
    // =========================================================================
    `ifdef COCOTB_SIM
    `ifndef SCANNED
    `define SCANNED
    initial begin
        $dumpfile ("wave.vcd");
        $dumpvars (0, red_add);
        #1;
    end
    `endif
    `endif

endmodule
// =============================================================================
// Module:       ReLU (Rectified Linear Unit)
// Design:       Eldrick Millares
// Verification: Matthew Pauly
// Notes:
// =============================================================================

module relu #(
    parameter BW = 32
) (
    input                      clk_i,
    input                      rst_n_i,

    input  signed [BW - 1 : 0] data_i,
    input                      valid_i,
    input                      last_i,
    output                     ready_o,

    output signed [BW - 1 : 0] data_o,
    output                     valid_o,
    output                     last_o,
    input                      ready_i
);

    // =========================================================================
    // Rectification
    // =========================================================================
    reg [BW - 1 : 0] rectified;
    always @(posedge clk_i) begin
        rectified <= (data_i > 0) ? data_i : 0;
    end

    // =========================================================================
    // Output Assignment
    // =========================================================================
    // register all outputs
    reg valid_q, last_q, ready_q;
    always @(posedge clk_i) begin
        if (!rst_n_i) begin
            valid_q <= 'b0;
            last_q  <= 'b0;
            ready_q <= 'b0;
        end else begin
            valid_q <= valid_i;
            last_q  <= last_i;
            ready_q <= ready_i;
        end
    end

    assign data_o  = rectified;
    assign valid_o = valid_q;
    assign last_o  = last_q;
    assign ready_o = ready_q;

    // =========================================================================
    // Simulation Only Waveform Dump (.vcd export)
    // =========================================================================
    `ifdef COCOTB_SIM
    `ifndef SCANNED
    `define SCANNED
    initial begin
        $dumpfile ("wave.vcd");
        $dumpvars (0, relu);
        #1;
    end
    `endif
    `endif

endmodule
// =============================================================================
// Module:       Vector Adder
// Design:       Eldrick Millares
// Verification: Matthew Pauly
// Notes:
// =============================================================================

module vec_add #(
    parameter I_BW = 16,
    parameter O_BW = 18,
    parameter VECTOR_LEN = 13
) (
    // clock and reset
    input                                       clk_i,
    input                                       rst_n_i,

    // streaming input
    input  signed [(VECTOR_LEN * I_BW) - 1 : 0] data0_i,
    input                                       valid0_i,
    input                                       last0_i,
    output                                      ready0_o,

    // streaming input
    input  signed [(VECTOR_LEN * I_BW) - 1 : 0] data1_i,
    input                                       valid1_i,
    input                                       last1_i,
    output                                      ready1_o,

    // streaming input
    input  signed [(VECTOR_LEN * I_BW) - 1 : 0] data2_i,
    input                                       valid2_i,
    input                                       last2_i,
    output                                      ready2_o,

    // streaming output
    output signed [(VECTOR_LEN * O_BW) - 1 : 0] data_o,
    output                                      valid_o,
    output                                      last_o,
    input                                       ready_i
);

    genvar i;

    // =========================================================================
    // Input Unpacking
    // =========================================================================
    // unpacked arrays
    wire signed [I_BW - 1 : 0] data0_arr [VECTOR_LEN - 1 : 0];
    wire signed [I_BW - 1 : 0] data1_arr [VECTOR_LEN - 1 : 0];
    wire signed [I_BW - 1 : 0] data2_arr [VECTOR_LEN - 1 : 0];
    reg  signed [O_BW - 1 : 0] out_arr   [VECTOR_LEN - 1 : 0];

    // unpack data input
    for (i = 0; i < VECTOR_LEN; i = i + 1) begin: unpack_inputs
        assign data0_arr[i] = data0_i[(i + 1) * I_BW - 1 : i * I_BW];
        assign data1_arr[i] = data1_i[(i + 1) * I_BW - 1 : i * I_BW];
        assign data2_arr[i] = data2_i[(i + 1) * I_BW - 1 : i * I_BW];
    end

    // =========================================================================
    // Vector Addition
    // =========================================================================
    // registered addition of data elements
    for (i = 0; i < VECTOR_LEN; i = i + 1) begin: vector_addition
        always @(posedge clk_i) begin
            if (!rst_n_i) begin
                out_arr[i] <= 'd0;
            end else begin
                out_arr[i] <= data0_arr[i] + data1_arr[i] + data2_arr[i];
            end
        end
    end

    // =========================================================================
    // Output Packing
    // =========================================================================
    // pack addition results
    for (i = 0; i < VECTOR_LEN; i = i + 1) begin: pack_output
        assign data_o[(i + 1) * O_BW - 1 : i * O_BW] = out_arr[i];
    end

    // =========================================================================
    // Output Assignment
    // =========================================================================
    // register all outputs
    reg valid_q, last_q, ready_q;
    always @(posedge clk_i) begin
        if (!rst_n_i) begin
            valid_q <= 'b0;
            last_q  <= 'b0;
            ready_q <= 'b0;
        end else begin
            valid_q <= valid0_i & valid1_i & valid2_i;
            last_q  <= last0_i | last1_i | last2_i;
            ready_q <= ready_i;
        end
    end

    assign valid_o  = valid_q;
    assign last_o   = last_q;
    assign ready0_o = ready_q;
    assign ready1_o = ready_q;
    assign ready2_o = ready_q;

    // =========================================================================
    // Simulation Only Waveform Dump (.vcd export)
    // =========================================================================
    `ifdef COCOTB_SIM
    `ifndef SCANNED
    `define SCANNED
    initial begin
        $dumpfile ("wave.vcd");
        $dumpvars (0, vec_add);
        #1;
    end
    `endif
    `endif

endmodule
// =============================================================================
// Module:       Vector Multiplier
// Design:       Eldrick Millares
// Verification: Matthew Pauly
// Notes:
// =============================================================================

module vec_mul #(
    parameter I_BW = 8,
    parameter O_BW = 16,
    parameter VECTOR_LEN = 13
) (
    // clock and reset
    input                                       clk_i,
    input                                       rst_n_i,

    // streaming input
    input  signed [(VECTOR_LEN * I_BW) - 1 : 0] data0_i,
    input                                       valid0_i,
    input                                       last0_i,
    output                                      ready0_o,

    // streaming input
    input  signed [(VECTOR_LEN * I_BW) - 1 : 0] data1_i,
    input                                       valid1_i,
    input                                       last1_i,
    output                                      ready1_o,

    // streaming output
    output signed [(VECTOR_LEN * O_BW) - 1 : 0] data_o,
    output                                      valid_o,
    output                                      last_o,
    input                                       ready_i
);

    genvar i;

    // =========================================================================
    // Input Unpacking
    // =========================================================================
    // unpacked arrays
    wire signed [I_BW - 1 : 0] data0_arr [VECTOR_LEN - 1 : 0];
    wire signed [I_BW - 1 : 0] data1_arr [VECTOR_LEN - 1 : 0];
    reg  signed [O_BW - 1 : 0] out_arr   [VECTOR_LEN - 1 : 0];

    // unpack data input
    for (i = 0; i < VECTOR_LEN; i = i + 1) begin: unpack_inputs
        assign data0_arr[i] = data0_i[(i + 1) * I_BW - 1 : i * I_BW];
        assign data1_arr[i] = data1_i[(i + 1) * I_BW - 1 : i * I_BW];
    end

    // =========================================================================
    // Vector Multiplication
    // =========================================================================
    // registered multiplication of data elements
    for (i = 0; i < VECTOR_LEN; i = i + 1) begin: vector_multiply
        always @(posedge clk_i) begin
            if (!rst_n_i) begin
                out_arr[i] <= 'd0;
            end else begin
                out_arr[i] <= data0_arr[i] * data1_arr[i];
            end
        end
    end

    // =========================================================================
    // Output Packing
    // =========================================================================
    // pack multiplication results
    for (i = 0; i < VECTOR_LEN; i = i + 1) begin: pack_output
        assign data_o[(i + 1) * O_BW - 1 : i * O_BW] = out_arr[i];
    end

    // =========================================================================
    // Output Assignment
    // =========================================================================
    // register all outputs
    reg valid_q, last_q, ready_q;
    always @(posedge clk_i) begin
        if (!rst_n_i) begin
            valid_q <= 'b0;
            last_q  <= 'b0;
            ready_q <= 'b0;
        end else begin
            valid_q <= valid0_i & valid1_i;
            last_q  <= last0_i | last1_i;
            ready_q <= ready_i;
        end
    end

    assign valid_o  = valid_q;
    assign last_o   = last_q;
    assign ready0_o = ready_q;
    assign ready1_o = ready_q;

    // =========================================================================
    // Simulation Only Waveform Dump (.vcd export)
    // =========================================================================
    `ifdef COCOTB_SIM
    `ifndef SCANNED
    `define SCANNED
    initial begin
        $dumpfile ("wave.vcd");
        $dumpvars (0, vec_mul);
        #1;
    end
    `endif
    `endif

endmodule
// =============================================================================
// Module:       Zero Pad
// Design:       Eldrick Millares
// Verification: Matthew Pauly
// Notes:
// Adds 1 leading and 1 trailing zero to stream
//
// Minimum dead time between frames is 2 clock cycles.
// This increased dead-time is needed because we reduce latency in this
// module to just 1 cycle.
// =============================================================================

module zero_pad #(
    parameter BW         = 8,
    parameter VECTOR_LEN = 13,

    // =========================================================================
    // Local Parameters - Do Not Edit
    // =========================================================================
    parameter VECTOR_BW = VECTOR_LEN * BW
) (
    // clock and reset
    input                             clk_i,
    input                             rst_n_i,

    // streaming input
    input  signed [VECTOR_BW - 1 : 0] data_i,
    input                             valid_i,
    input                             last_i,
    output                            ready_o,

    // streaming output
    output signed [VECTOR_BW - 1 : 0] data_o,
    output                            valid_o,
    output                            last_o,
    input                             ready_i
);

    // =========================================================================
    // Delay Lines
    // =========================================================================
    reg signed [VECTOR_BW - 1 : 0] data_q, data_q2;
    reg valid_q, valid_q2, valid_q3, last_q, last_q2, last_q3, ready_q;
    always @(posedge clk_i) begin
        if (!rst_n_i) begin
            valid_q  <= 'b0;
            valid_q2 <= 'b0;
            valid_q3 <= 'b0;
            last_q   <= 'b0;
            last_q2  <= 'b0;
            last_q3  <= 'b0;
            ready_q  <= 'b0;
            data_q   <= 'b0;
            data_q2  <= 'b0;
        end else begin
            valid_q  <= valid_i;
            valid_q2 <= valid_q;
            valid_q3 <= valid_q2;
            last_q   <= last_i;
            last_q2  <= last_q;
            last_q3  <= last_q2;
            ready_q  <= ready_i;
            data_q   <= (valid_i) ? data_i : 0;
            data_q2  <= (valid_q) ? data_q : 0;
        end
    end

    // =========================================================================
    // Edge Detectors
    // =========================================================================
    // positive edge detector to emit initial 0
    wire valid_i_pos_edge  = valid_i  & (!valid_q);

    // negative edge detectors to extend valid_o, emit last 0
    wire valid_q_neg_edge  = valid_q2 & (!valid_q);
    wire valid_q2_neg_edge = valid_q3 & (!valid_q2);

    // =========================================================================
    // Output Assignment
    // =========================================================================
    assign data_o  = (valid_q2_neg_edge | valid_i_pos_edge) ? 0 : data_q2;
    assign valid_o = valid_q | valid_q_neg_edge | valid_q2_neg_edge;
    assign last_o  = last_q3;
    assign ready_o = ready_q;

    // =========================================================================
    // Simulation Only Waveform Dump (.vcd export)
    // =========================================================================
    `ifdef COCOTB_SIM
    `ifndef SCANNED
    `define SCANNED
    initial begin
        $dumpfile ("wave.vcd");
        $dumpvars (0, zero_pad);
        #1;
    end
    `endif
    `endif

endmodule
// ============================================================================
// Module:       Maximum
// Design:       Eldrick Millares
// Verification: Matthew Pauly
// Notes:
// INFO: Hard coded for 2 elements.
// ============================================================================

module argmax #(
    parameter I_BW = 24,

    // =========================================================================
    // Local Parameters - Do Not Edit
    // =========================================================================
    parameter VECTOR_LEN = 2
) (
    // clock and reset
    input                                       clk_i,
    input                                       rst_n_i,

    // streaming input
    input  signed [(VECTOR_LEN * I_BW) - 1 : 0] data_i,
    input                                       valid_i,
    input                                       last_i,
    output                                      ready_o,

    // streaming output
    output signed [VECTOR_LEN - 1 : 0]          data_o,
    output                                      valid_o,
    output                                      last_o,
    input                                       ready_i
);

    genvar i;

    // =========================================================================
    // Input Unpacking
    // =========================================================================
    wire signed [I_BW - 1 : 0] data_arr [VECTOR_LEN - 1 : 0];
    for (i = 0; i < VECTOR_LEN; i = i + 1) begin: unpack_inputs
        assign data_arr[i] = data_i[(i + 1) * I_BW - 1 : i * I_BW];
    end

    // =========================================================================
    // Max
    // =========================================================================
    wire [VECTOR_LEN - 1 : 0] argmax_one_hot;
    reg  [VECTOR_LEN - 1 : 0] argmax_one_hot_q;

    assign argmax_one_hot = (data_arr[0] > data_arr[1]) ? 'b01 : 'b10;

    always @(posedge clk_i) begin
        if (!rst_n_i) begin
            argmax_one_hot_q <= 'd0;
        end else begin
            argmax_one_hot_q <= argmax_one_hot;
        end
    end

    // =========================================================================
    // Output Assignment
    // =========================================================================
    // register all outputs
    reg valid_q, last_q, ready_q;
    always @(posedge clk_i) begin
        if (!rst_n_i) begin
            valid_q <= 'b0;
            last_q  <= 'b0;
            ready_q <= 'b0;
        end else begin
            valid_q <= valid_i;
            last_q  <= last_i;
            ready_q <= ready_i;
        end
    end

    assign data_o   = argmax_one_hot_q;
    assign valid_o  = valid_q;
    assign last_o   = last_q;
    assign ready_o  = ready_q;

    // =========================================================================
    // Simulation Only Waveform Dump (.vcd export)
    // =========================================================================
    `ifdef COCOTB_SIM
    `ifndef SCANNED
    `define SCANNED
    initial begin
        $dumpfile ("wave.vcd");
        $dumpvars (0, argmax);
        #1;
    end
    `endif
    `endif

endmodule
// =============================================================================
// Module:       1D Convolution
// Design:       Eldrick Millares
// Verification: Matthew Pauly
// Notes:
// Constraint: FRAME_LEN > FILTER_LEN
// Constraint: FILTER_LEN == 3
// INFO: Does not deal with ready's / backpressure
// =============================================================================

module conv_top #(
    parameter FRAME_LEN   = 50,  // output frame length
    parameter VECTOR_LEN  = 13,
    parameter NUM_FILTERS = 8,

    // =========================================================================
    // Local Parameters - Do Not Edit
    // =========================================================================
    parameter FILTER_LEN = 3,
    parameter BW                = 8,
    parameter VECTOR_BW         = VECTOR_LEN * BW,
    parameter BANK_BW           = $clog2(FILTER_LEN + 2),
    parameter ADDR_BW           = $clog2(NUM_FILTERS)
) (
    // clock and reset
    input                             clk_i,
    input                             rst_n_i,

    // streaming input
    input  signed [VECTOR_BW - 1 : 0] data_i,
    input                             valid_i,
    input                             last_i,
    output                            ready_o,

    // streaming output
    output signed [BW - 1 : 0]        data_o,
    output                            valid_o,
    output                            last_o,
    input                             ready_i,

    // memory configuration
    input                             rd_en_i,
    input                             wr_en_i,
    input         [BANK_BW - 1 : 0]   rd_wr_bank_i,
    input         [ADDR_BW - 1 : 0]   rd_wr_addr_i,
    input  signed [VECTOR_BW - 1 : 0] wr_data_i,
    output signed [VECTOR_BW - 1 : 0] rd_data_o
);

    genvar i;

    // =========================================================================
    // Local Parameters
    // =========================================================================
    localparam MAX_CYCLES = NUM_FILTERS * FRAME_LEN;

    // bitwidth definitions
    localparam MUL_BW            = 16;
    localparam ADD_BW            = 18;
    localparam BIAS_BW           = 32;
    localparam MUL_VECTOR_BW     = VECTOR_LEN * MUL_BW;
    localparam ADD_VECTOR_BW     = VECTOR_LEN * ADD_BW;
    localparam FRAME_COUNTER_BW  = $clog2(FRAME_LEN);
    localparam FILTER_COUNTER_BW = $clog2(NUM_FILTERS);
    localparam SHIFT_BW          = $clog2(BIAS_BW);

    // =========================================================================
    // Ready Signals - Declare-before-use needed for Design Compiler
    // =========================================================================
    wire vec_mul_ready0 [FILTER_LEN - 1 : 0];
    wire vec_mul_ready1 [FILTER_LEN - 1 : 0];
    wire vec_add_ready  [FILTER_LEN - 1 : 0];
    wire [0:0] red_add_ready; // [0:0] needed to avoid undecl. error
    wire bias_add_ready [FILTER_LEN - 1 : 0];
    wire [0:0] relu_ready;
    wire [0:0] quantizer_ready;

    // =========================================================================
    // Recycler
    // =========================================================================
    wire [VECTOR_BW - 1 : 0] recycler_data0;
    wire [VECTOR_BW - 1 : 0] recycler_data1;
    wire [VECTOR_BW - 1 : 0] recycler_data2;
    wire                     recycler_valid;
    wire                     recycler_last;
    wire                     recycler_ready;

    recycler #(
        .BW(BW),
        .FRAME_LEN(FRAME_LEN),
        .VECTOR_LEN(VECTOR_LEN),
        .NUM_FILTERS(NUM_FILTERS)
    ) recycler_inst (
        .clk_i(clk_i),
        .rst_n_i(rst_n_i),

        .data_i(data_i),
        .valid_i(valid_i),
        .last_i(last_i),
        .ready_o(recycler_ready),

        .data0_o(recycler_data0),
        .data1_o(recycler_data1),
        .data2_o(recycler_data2),
        .valid_o(recycler_valid),
        .last_o(recycler_last),
        .ready_i(vec_mul_ready0[0])
    );

    reg [VECTOR_BW - 1 : 0] recycler_data_q [FILTER_LEN - 1 : 0];
    reg                     recycler_valid_q;
    reg                     recycler_last_q;

    always @(posedge clk_i) begin
        recycler_data_q[0] <= recycler_data0;
        recycler_data_q[1] <= recycler_data1;
        recycler_data_q[2] <= recycler_data2;
        recycler_valid_q   <= recycler_valid;
        recycler_last_q    <= recycler_last;
    end

    // =========================================================================
    // Parameter Memory
    // =========================================================================
    wire [VECTOR_BW - 1 : 0] conv_mem_weight [FILTER_LEN - 1 : 0];
    wire [BIAS_BW - 1 : 0]   conv_mem_bias;
    wire [SHIFT_BW - 1 : 0]  conv_mem_shift;
    wire                     conv_mem_valid;
    wire                     conv_mem_last;

    conv_mem #(
        .BW(BW),
        .BIAS_BW(BIAS_BW),
        .SHIFT_BW(SHIFT_BW),
        .FRAME_LEN(FRAME_LEN),
        .VECTOR_LEN(VECTOR_LEN),
        .NUM_FILTERS(NUM_FILTERS)
    ) conv_mem_inst (
        .clk_i(clk_i),
        .rst_n_i(rst_n_i),

        .cycle_en_i(recycler_valid),

        .rd_en_i(rd_en_i),
        .wr_en_i(wr_en_i),
        .rd_wr_bank_i(rd_wr_bank_i),
        .rd_wr_addr_i(rd_wr_addr_i),
        .wr_data_i(wr_data_i),
        .rd_data_o(rd_data_o),

        .data0_o(conv_mem_weight[0]),
        .data1_o(conv_mem_weight[1]),
        .data2_o(conv_mem_weight[2]),
        .bias_o(conv_mem_bias),
        .shift_o(conv_mem_shift),
        .valid_o(conv_mem_valid),
        .last_o(conv_mem_last),
        .ready_i(vec_mul_ready1[0])
    );

    // Delay the bias term to align with the output of the multipliers,
    // vector addition, and reduction addition
    reg [BIAS_BW - 1 : 0] conv_mem_bias_q,
                          conv_mem_bias_q2,
                          conv_mem_bias_q3;

    reg                   conv_mem_valid_q,
                          conv_mem_valid_q2,
                          conv_mem_valid_q3;

    reg                   conv_mem_last_q,
                          conv_mem_last_q2,
                          conv_mem_last_q3;
    always @(posedge clk_i) begin
        conv_mem_bias_q  <= conv_mem_bias;
        conv_mem_bias_q2 <= conv_mem_bias_q;
        conv_mem_bias_q3 <= conv_mem_bias_q2;

        conv_mem_valid_q  <= conv_mem_valid;
        conv_mem_valid_q2 <= conv_mem_valid_q;
        conv_mem_valid_q3 <= conv_mem_valid_q2;

        conv_mem_last_q  <= conv_mem_last;
        conv_mem_last_q2 <= conv_mem_last_q;
        conv_mem_last_q3 <= conv_mem_last_q2;
    end

    // =========================================================================
    // Vector Multiplication
    // =========================================================================
    wire [MUL_VECTOR_BW - 1 : 0] vec_mul_data   [FILTER_LEN - 1 : 0];
    wire                         vec_mul_valid  [FILTER_LEN - 1 : 0];
    wire                         vec_mul_last   [FILTER_LEN - 1 : 0];

    for (i = 0; i < FILTER_LEN; i = i + 1) begin: vector_multiply
        vec_mul #(
            .I_BW(BW),
            .O_BW(MUL_BW),
            .VECTOR_LEN(VECTOR_LEN)
        ) vec_mul_inst (
            .clk_i(clk_i),
            .rst_n_i(rst_n_i),

            .data0_i(recycler_data_q[i]),
            .valid0_i(recycler_valid_q),
            .last0_i(recycler_last_q),
            .ready0_o(vec_mul_ready0[i]),

            .data1_i(conv_mem_weight[i]),
            .valid1_i(conv_mem_valid),
            .last1_i(conv_mem_last),
            .ready1_o(vec_mul_ready1[i]),

            .data_o(vec_mul_data[i]),
            .valid_o(vec_mul_valid[i]),
            .last_o(vec_mul_last[i]),
            .ready_i(vec_add_ready[i])
        );
    end

    // =========================================================================
    // Vector Addition
    // =========================================================================
    wire [ADD_VECTOR_BW - 1 : 0] vec_add_data;
    wire                         vec_add_valid;
    wire                         vec_add_last;

    vec_add #(
        .I_BW(MUL_BW),
        .O_BW(ADD_BW),
        .VECTOR_LEN(VECTOR_LEN)
    ) vec_add_inst (
        .clk_i(clk_i),
        .rst_n_i(rst_n_i),

        .data0_i(vec_mul_data[0]),
        .valid0_i(vec_mul_valid[0]),
        .last0_i(vec_mul_last[0]),
        .ready0_o(vec_add_ready[0]),

        .data1_i(vec_mul_data[1]),
        .valid1_i(vec_mul_valid[1]),
        .last1_i(vec_mul_last[1]),
        .ready1_o(vec_add_ready[0]),

        .data2_i(vec_mul_data[2]),
        .valid2_i(vec_mul_valid[2]),
        .last2_i(vec_mul_last[2]),
        .ready2_o(vec_add_ready[0]),

        .data_o(vec_add_data),
        .valid_o(vec_add_valid),
        .last_o(vec_add_last),
        .ready_i(red_add_ready[0])
    );

    // =========================================================================
    // Reduction Addition
    // =========================================================================
    wire [BIAS_BW - 1 : 0] red_add_data;
    wire                   red_add_valid;
    wire                   red_add_last;

    red_add #(
        .I_BW(ADD_BW),
        .O_BW(BIAS_BW),
        .VECTOR_LEN(VECTOR_LEN)
    ) red_add_inst (
        .clk_i(clk_i),
        .rst_n_i(rst_n_i),

        .data_i(vec_add_data),
        .valid_i(vec_add_valid),
        .last_i(vec_add_last),
        .ready_o(red_add_ready),

        .data_o(red_add_data),
        .valid_o(red_add_valid),
        .last_o(red_add_last),
        .ready_i(bias_add_ready[1])
    );

    // =========================================================================
    // Bias Addition
    // =========================================================================
    wire [BIAS_BW - 1 : 0] bias_add_data;
    wire                   bias_add_valid;
    wire                   bias_add_last;

    vec_add #(
        .I_BW(BIAS_BW),
        .O_BW(BIAS_BW),
        .VECTOR_LEN(1)
    ) bias_add_inst (
        .clk_i(clk_i),
        .rst_n_i(rst_n_i),

        // bias term
        .data0_i(conv_mem_bias_q3),
        .valid0_i(conv_mem_valid_q3),
        .last0_i(conv_mem_last_q3),
        .ready0_o(bias_add_ready[0]),

        // reduced sum
        .data1_i(red_add_data),
        .valid1_i(red_add_valid),
        .last1_i(red_add_last),
        .ready1_o(bias_add_ready[1]),

        // unused
        .data2_i({BIAS_BW{1'b0}}),
        .valid2_i(1'd1),
        .last2_i(1'd0),
        .ready2_o(bias_add_ready[2]),

        .data_o(bias_add_data),
        .valid_o(bias_add_valid),
        .last_o(bias_add_last),
        .ready_i(relu_ready[0])
    );

    // =========================================================================
    // ReLU Layer
    // =========================================================================
    wire [BIAS_BW - 1 : 0] relu_data;
    wire                   relu_valid;
    wire                   relu_last;

    relu #(
        .BW(BIAS_BW)
    ) relu_inst (
        .clk_i(clk_i),
        .rst_n_i(rst_n_i),

        .data_i(bias_add_data),
        .valid_i(bias_add_valid),
        .last_i(bias_add_last),
        .ready_o(relu_ready),

        .data_o(relu_data),
        .valid_o(relu_valid),
        .last_o(relu_last),
        .ready_i(quantizer_ready[0])
    );

    // =========================================================================
    // Quantization Layer
    // =========================================================================
    wire [BW - 1 : 0] quantizer_data;
    wire              quantizer_valid;
    wire              quantizer_last;

    quantizer #(
        .I_BW(BIAS_BW),
        .O_BW(BW),
        .SHIFT_BW(SHIFT_BW)
    ) quantizer_inst (
        .clk_i(clk_i),
        .rst_n_i(rst_n_i),

        .shift_i(conv_mem_shift),

        .data_i(relu_data),
        .valid_i(relu_valid),
        .last_i(relu_last),
        .ready_o(quantizer_ready),

        .data_o(quantizer_data),
        .valid_o(quantizer_valid),
        .last_o(quantizer_last),
        .ready_i(ready_i)
    );

    // =========================================================================
    // Output Assignment
    // =========================================================================
    assign data_o  = quantizer_data;
    assign valid_o = quantizer_valid;
    assign ready_o = recycler_ready;
    assign last_o  = quantizer_last;

    // =========================================================================
    // Simulation Only Waveform Dump (.vcd export)
    // =========================================================================
    `ifdef COCOTB_SIM
    `ifndef SCANNED
    `define SCANNED
    initial begin
      $dumpfile ("wave.vcd");
      $dumpvars (0, conv_top);
      #1;
    end
    `endif
    `endif

endmodule
// =============================================================================
// Module:       Fully Connected Memory
// Design:       Eldrick Millares
// Verification: Matthew Pauly
// Notes:
// Constraint: BIAS_BW > BW
// =============================================================================

module fc_mem #(
    parameter BW          = 8,
    parameter BIAS_BW     = 16,
    parameter FRAME_LEN   = 208,
    parameter NUM_CLASSES = 2,

    // ========================================================================
    // Local Parameters - Do Not Edit
    // ========================================================================
    // Bitwidth Definitions
    parameter ADDR_BW = $clog2(FRAME_LEN),
    // Number of weight banks + bias bank per class
    parameter BANK_BW = $clog2(NUM_CLASSES * 2)
) (
    // clock and reset
    input                                           clk_i,
    input                                           rst_n_i,

    // control
    input                                           cycle_en_i,

    // memory configuration
    input                                           rd_en_i,
    input                                           wr_en_i,
    input         [BANK_BW - 1 : 0]                 rd_wr_bank_i,
    input         [ADDR_BW - 1 : 0]                 rd_wr_addr_i,
    input  signed [BIAS_BW - 1 : 0]                 wr_data_i,
    output signed [BIAS_BW - 1 : 0]                 rd_data_o,

    // streaming output
    output signed [(BW * NUM_CLASSES) - 1 : 0]      data_w_o,
    output signed [(BIAS_BW * NUM_CLASSES) - 1 : 0] data_b_o,
    output                                          valid_o,
    output                                          last_o,
    input                                           ready_i
);

    genvar i;

    // ========================================================================
    // Local Parameters
    // ========================================================================
    localparam FRAME_COUNTER_BW = $clog2(FRAME_LEN);

    // ========================================================================
    // Frame Counter
    // ========================================================================
    reg [FRAME_COUNTER_BW - 1 : 0] frame_counter;

    always @(posedge clk_i) begin
        if (!rst_n_i) begin
            frame_counter <= 0;
        end else begin
            if (cycle_en_i) begin
                frame_counter <= (frame_counter < FRAME_LEN - 1) ?
                                  frame_counter + 'd1 : 'd0;
            end else begin
                frame_counter <= frame_counter;
            end
        end
    end

    // ========================================================================
    // Weight Memories
    // ========================================================================
    wire                    weight_wr_en    [NUM_CLASSES - 1 : 0];
    wire                    weight_en;
    wire [BW - 1 : 0]       weight_data_in;
    wire [ADDR_BW - 1 : 0]  weight_addr;
    wire [BW - 1 : 0]       weight_data_out [NUM_CLASSES - 1 : 0];

    for (i = 0; i < NUM_CLASSES; i = i + 1) begin: weight_banks_wr_en
        assign weight_wr_en[i] = (wr_en_i) & (rd_wr_bank_i == i);
    end
    assign weight_en      = (wr_en_i | rd_en_i | cycle_en_i);
    assign weight_data_in = (wr_en_i) ? wr_data_i[BW - 1 : 0] : 'd0;
    assign weight_addr    = (wr_en_i | rd_en_i) ? rd_wr_addr_i : frame_counter;

    for (i = 0; i < NUM_CLASSES; i = i + 1) begin: weight_banks
        dffram #(
            .WIDTH(BW),
            .DEPTH(FRAME_LEN)
        ) weight_ram_inst (
            .clk_i(clk_i),

            .wr_en_i(weight_wr_en[i]),
            .en_i(weight_en),

            .addr_i(weight_addr),
            .data_i(weight_data_in),
            .data_o(weight_data_out[i])
        );
    end

    // ========================================================================
    // Bias Memories
    // ========================================================================
    wire                   bias_wr_en [NUM_CLASSES - 1 : 0];
    wire                   bias_en;
    wire [BIAS_BW - 1 : 0] bias_data_in;
    // required to be 2 bits for dffram
    wire [1:0]             bias_addr;
    wire [BIAS_BW - 1 : 0] bias_data_out [NUM_CLASSES - 1 : 0];

    for (i = 0; i < NUM_CLASSES; i = i + 1) begin: bias_banks_wr_en
        assign bias_wr_en[i] = (wr_en_i) & (rd_wr_bank_i == i + NUM_CLASSES);
    end
    assign bias_en      = (wr_en_i | rd_en_i | cycle_en_i);
    assign bias_data_in = (wr_en_i) ? wr_data_i : 'd0;
    assign bias_addr    = 'b0;

    for (i = 0; i < NUM_CLASSES; i = i + 1) begin: bias_banks
        dffram #(
            .WIDTH(BIAS_BW),
            .DEPTH(1)
        ) bias_ram_inst (
            .clk_i(clk_i),

            .wr_en_i(bias_wr_en[i]),
            .en_i(bias_en),

            .addr_i(bias_addr),
            .data_i(bias_data_in),
            .data_o(bias_data_out[i])
        );
    end

    // ========================================================================
    // Read Data Assignment
    // ========================================================================
    reg [BANK_BW - 1 : 0] rd_wr_bank_q;
    always @(posedge clk_i) begin
        if (!rst_n_i) begin
            rd_wr_bank_q <= 'b0;
        end else begin
            rd_wr_bank_q <= rd_wr_bank_i;
        end
    end

    // build array of all the output data, properly padded, to mux to rd_data_o
    wire [BIAS_BW - 1 : 0] out_data_arr [(NUM_CLASSES * 2) - 1 : 0];

    for (i = 0; i < NUM_CLASSES; i = i + 1) begin: weight_banks_out_data_arr
        assign out_data_arr[i] = {{{BIAS_BW - BW}{1'b0}}, weight_data_out[i]};
    end
    for (i = 0; i < NUM_CLASSES; i = i + 1) begin: bias_banks_out_data_arr
        assign out_data_arr[i + NUM_CLASSES] = bias_data_out[i];
    end

    assign rd_data_o = out_data_arr[rd_wr_bank_q];

    // ========================================================================
    // Output Assignment
    // ========================================================================
    reg cycle_en_i_q;
    always @(posedge clk_i) begin
        cycle_en_i_q <= cycle_en_i;
    end

    reg frame_last;
    always @(posedge clk_i) begin
        frame_last <= (frame_counter == FRAME_LEN - 1);
    end

    // pack multiplication results
    for (i = 0; i < NUM_CLASSES; i = i + 1) begin: pack_output
        assign data_w_o[(i + 1) * BW - 1 : i * BW] = weight_data_out[i];
        assign data_b_o[(i + 1) * BIAS_BW - 1 : i * BIAS_BW] = bias_data_out[i];
    end
    assign valid_o = cycle_en_i_q;
    assign last_o  = valid_o & frame_last;

    // ========================================================================
    // Simulation Only Waveform Dump (.vcd export)
    // ========================================================================
    `ifdef COCOTB_SIM
    `ifndef SCANNED
    `define SCANNED
    initial begin
        $dumpfile ("wave.vcd");
        $dumpvars (0, fc_mem);
        #1;
    end
    `endif
    `endif

endmodule
// ============================================================================
// Module:       Fully Connected Layer
// Design:       Eldrick Millares
// Verification: Matthew Pauly
// Notes:
// Assumes BIAS_BW > BW
// ============================================================================

module fc_top #(
    parameter I_BW        = 8,
    parameter BIAS_BW     = 16,
    parameter O_BW        = 24,
    parameter FRAME_LEN   = 208,
    parameter NUM_CLASSES = 3,

    // ========================================================================
    // Local Parameters - Do Not Edit
    // ========================================================================
    parameter VECTOR_O_BW = O_BW * NUM_CLASSES,
    parameter ADDR_BW     = $clog2(FRAME_LEN),
    parameter BANK_BW     = $clog2(NUM_CLASSES * 2)
) (
    // clock and reset
    input                               clk_i,
    input                               rst_n_i,

    // streaming input
    input  signed [I_BW - 1 : 0]        data_i,
    input                               valid_i,
    input                               last_i,
    output                              ready_o,

    // streaming output
    output signed [VECTOR_O_BW - 1 : 0] data_o,
    output                              valid_o,
    output                              last_o,
    input                               ready_i,

    // memory configuration
    input                               rd_en_i,
    input                               wr_en_i,
    input         [BANK_BW - 1 : 0]     rd_wr_bank_i,
    input         [ADDR_BW - 1 : 0]     rd_wr_addr_i,
    input  signed [BIAS_BW - 1 : 0]     wr_data_i,
    output signed [BIAS_BW - 1 : 0]     rd_data_o
);

    genvar i;

    // ========================================================================
    // Local Parameters
    // ========================================================================
    // Bitwidth Definitions
    localparam VECTOR_I_BW = I_BW * NUM_CLASSES;
    localparam VECTOR_BIAS_BW = BIAS_BW * NUM_CLASSES;

    // Number of weight banks + bias bank per class
    localparam FRAME_COUNTER_BW = $clog2(FRAME_LEN);
    // ========================================================================

    // ========================================================================
    // Parameter Memory
    // ========================================================================
    wire [VECTOR_I_BW - 1 : 0] fc_mem_data_w;
    wire [VECTOR_BIAS_BW - 1 : 0] fc_mem_data_b;
    wire fc_mem_valid;
    wire fc_mem_last;
    wire fc_mem_ready;

    fc_mem #(
        .BW(I_BW),
        .BIAS_BW(BIAS_BW),
        .FRAME_LEN(FRAME_LEN),
        .NUM_CLASSES(NUM_CLASSES)
    ) fc_mem_inst (
        .clk_i(clk_i),
        .rst_n_i(rst_n_i),

        .cycle_en_i(valid_i),

        .rd_en_i(rd_en_i),
        .wr_en_i(wr_en_i),
        .rd_wr_bank_i(rd_wr_bank_i),
        .rd_wr_addr_i(rd_wr_addr_i),
        .wr_data_i(wr_data_i),
        .rd_data_o(rd_data_o),

        .data_w_o(fc_mem_data_w),
        .data_b_o(fc_mem_data_b),
        .valid_o(fc_mem_valid),
        .last_o(fc_mem_last),
        .ready_i(fc_mem_ready)
    );

    // ========================================================================
    // MAC Array
    // ========================================================================
    wire mac_ready0;

    // register stream input array to give fc_mem 1 cycle to ready outputs
    reg signed [I_BW - 1 : 0]        data_i_q;
    reg                              valid_i_q;
    reg                              last_i_q;
    reg                              mac_ready0_q;

    always @(posedge clk_i) begin
        if (!rst_n_i) begin
            data_i_q  <= 0;
            valid_i_q <= 0;
            mac_ready0_q <= 0;
            last_i_q  <= 0;
        end else begin
            data_i_q  <= data_i;
            valid_i_q <= valid_i;
            mac_ready0_q <= mac_ready0;
            last_i_q  <= last_i;
        end
    end

    mac #(
        .I_BW(I_BW),
        .O_BW(O_BW),
        .BIAS_BW(BIAS_BW),
        .NUM_CLASSES(NUM_CLASSES)
    ) mac_inst (
        .clk_i(clk_i),
        .rst_n_i(rst_n_i),

        .data0_i(data_i_q),
        .valid0_i(valid_i_q),
        .last0_i(last_i_q),
        .ready0_o(mac_ready0),

        .data1_w_i(fc_mem_data_w),
        .data1_b_i(fc_mem_data_b),
        .valid1_i(fc_mem_valid),
        .last1_i(fc_mem_last),
        .ready1_o(fc_mem_ready),

        .data_o(data_o),
        .valid_o(valid_o),
        .last_o(last_o),
        .ready_i(ready_i)
    );

    // ========================================================================
    // Simulation Only Waveform Dump (.vcd export)
    // ========================================================================
    `ifdef COCOTB_SIM
    `ifndef SCANNED
    `define SCANNED
    initial begin
        $dumpfile ("wave.vcd");
        $dumpvars (0, fc_top);
        #1;
    end
    `endif
    `endif

endmodule
// ============================================================================
// Module:       Multiply Accumulate
// Design:       Eldrick Millares
// Verification: Matthew Pauly
// Notes:
// Assumes that biases have 2x bitwidth of weights, and outputs are 3x bitwidth
// Also assumes that packet lengths are > 3 (which is the propogation length of
// the bias out to the output, since it is pipelined).
// ============================================================================

module mac #(
    parameter I_BW        = 8,          // input bitwidth
    parameter O_BW        = I_BW * 3,   // output bitwidth
    parameter BIAS_BW     = I_BW * 2,   // bias bitwidth
    parameter NUM_CLASSES = 3           // number of output classes
) (
    // clock and reset
    input                                           clk_i,
    input                                           rst_n_i,

    // streaming input
    input  signed [I_BW - 1: 0]                     data0_i,
    input                                           valid0_i,
    input                                           last0_i,
    output                                          ready0_o,

    // streaming input
    input  signed [(NUM_CLASSES * I_BW) - 1 : 0]    data1_w_i,
    input  signed [(NUM_CLASSES * BIAS_BW) - 1 : 0] data1_b_i,
    input                                           valid1_i,
    input                                           last1_i,
    output                                          ready1_o,

    // streaming output
    output signed [(NUM_CLASSES * O_BW) - 1 : 0]    data_o,
    output                                          valid_o,
    output                                          last_o,
    input                                           ready_i
);


    genvar i;

    // =========================================================================
    // Local Parameters
    // =========================================================================
    localparam VALID_TIMEOUT_CYCLES         = 8;  // num cycles to reset after
    localparam VALID_TIMEOUT_BW             = $clog2(VALID_TIMEOUT_CYCLES + 1);

    // =========================================================================
    // Output Register Declaratons
    // =========================================================================
    reg valid_q, valid_q2, valid_q3;
    reg last_q, last_q2, last_q3;
    reg ready_q;

    // =========================================================================
    // Delay Lines
    // =========================================================================
    // add 2 cycle bias delay line to account for multiplier and accumulator
    reg signed [(NUM_CLASSES * BIAS_BW) - 1 : 0] data1_b_q, data1_b_q2;
    always @(posedge clk_i) begin
        if (!rst_n_i) begin
            data1_b_q  <= 0;
            data1_b_q2 <= 0;
        end else begin
            data1_b_q  <= data1_b_i;
            data1_b_q2 <= data1_b_q;
        end
    end

    // =========================================================================
    // Input Unpacking
    // =========================================================================
    // unpacked arrays
    wire signed [I_BW - 1 : 0]    weight_arr [NUM_CLASSES - 1 : 0];
    wire signed [BIAS_BW - 1 : 0] bias_arr   [NUM_CLASSES - 1 : 0];

    // unpack data input
    for (i = 0; i < NUM_CLASSES; i = i + 1) begin: unpack_inputs
        assign weight_arr[i] = data1_w_i[(i + 1) * I_BW - 1 : i * I_BW];
        assign bias_arr[i]   = data1_b_q2[(i + 1) * BIAS_BW - 1 : i * BIAS_BW];
    end

    // =========================================================================
    // Vector Multiplication
    // =========================================================================
    // registered multiplication of input and bias
    reg signed [(I_BW * 2) - 1: 0] mult_arr [NUM_CLASSES - 1 : 0];
    for (i = 0; i < NUM_CLASSES; i = i + 1) begin: fc_multiply
        always @(posedge clk_i) begin
            if (!rst_n_i) begin
                mult_arr[i] <= 'd0;
            end else begin
                mult_arr[i] <= data0_i * weight_arr[i];
            end
        end
    end

    // =========================================================================
    // Accumulation Buffer
    // =========================================================================
    // clear the accumulation buffer when valid has a rising edge
    // wire valid_i_pos_edge;
    // assign valid_i_pos_edge = valid0_i & (!valid_q);

    // clear the accumulation buffer if no valid data has been passed in for
    // VALID_TIMEOUT_CYCLES cycles
    wire valid_timeout;
    reg [VALID_TIMEOUT_BW - 1: 0] valid_timeout_counter;
    always @(posedge clk_i) begin
        if (!rst_n_i) begin
            valid_timeout_counter <= 'd0;
        end else begin
            if (valid0_i) begin  // reset counter on valid data
                valid_timeout_counter <= 'd0;
            end else if (valid_timeout_counter == VALID_TIMEOUT_CYCLES) begin
                valid_timeout_counter <= valid_timeout_counter;
            end else begin
                valid_timeout_counter <= valid_timeout_counter + 'd1;
            end
        end
    end
    assign valid_timeout = (valid_timeout_counter == VALID_TIMEOUT_CYCLES);

    reg signed [O_BW - 1: 0] acc_arr [NUM_CLASSES - 1 : 0];
    for (i = 0; i < NUM_CLASSES; i = i + 1) begin: fc_accumulate
        always @(posedge clk_i) begin
            if (!rst_n_i) begin
                acc_arr[i] <= 'd0;
            end else begin
                if (last_q2 | valid_timeout) begin
                    acc_arr[i] <= 'd0;
                end else if (valid_q) begin
                    acc_arr[i] <= mult_arr[i] + acc_arr[i];
                end else begin
                    acc_arr[i] <= acc_arr[i];
                end
            end
        end
    end

    // =========================================================================
    // Bias Addition
    // =========================================================================
    reg signed [O_BW - 1: 0] add_arr [NUM_CLASSES - 1 : 0];
    for (i = 0; i < NUM_CLASSES; i = i + 1) begin: fc_bias
        always @(posedge clk_i) begin
            if (!rst_n_i) begin
                add_arr[i] <= 'd0;
            end else begin
                add_arr[i] <= acc_arr[i] + bias_arr[i];
            end
        end
    end

    // =========================================================================
    // Output Assignment
    // =========================================================================
    for (i = 0; i < NUM_CLASSES; i = i + 1) begin: pack_output
        assign data_o[(i + 1) * O_BW - 1 : i * O_BW] = add_arr[i];
    end

    // register all outputs
    always @(posedge clk_i) begin
        if (!rst_n_i) begin
            valid_q  <= 'b0;
            valid_q2 <= 'b0;
            valid_q3 <= 'b0;
            last_q   <= 'b0;
            last_q2  <= 'b0;
            last_q3  <= 'b0;
            ready_q  <= 'b0;
        end else begin
            valid_q  <= valid0_i && valid1_i;
            valid_q2 <= valid_q;
            valid_q3 <= valid_q2;
            // last_q   <= last0_i | last1_i;
            last_q   <= last1_i;
            last_q2  <= last_q;
            last_q3  <= last_q2;
            ready_q  <= ready_i;
        end
    end


    assign valid_o  = valid_q3 && last_q3;
    assign last_o   = last_q3;
    assign ready0_o = ready_q;
    assign ready1_o = ready_q;

    // =========================================================================
    // Simulation Only Waveform Dump (.vcd export)
    // =========================================================================
    `ifdef COCOTB_SIM
    `ifndef SCANNED
    `define SCANNED
    initial begin
        $dumpfile ("wave.vcd");
        $dumpvars (0, mac);
        // reg [7:0] idx; // need integer for loop
        $dumpvars(0, mult_arr[0]);
        $dumpvars(0, acc_arr[0]);
        $dumpvars(0, add_arr[0]);
        $dumpvars(0, mult_arr[1]);
        $dumpvars(0, acc_arr[1]);
        $dumpvars(0, add_arr[1]);
        #1;
    end
    `endif
    `endif

endmodule
// ============================================================================
// Module:       Wake
// Design:       Eldrick Millares
// Verification: Matthew Pauly
// Notes:
// INFO: Assumes wake word class is 0th bit of data_i
// INFO: SUSTAIN_LEN hard coded for 1/2 second
// ============================================================================

module wake #(
    parameter NUM_CLASSES = 3
) (
    // clock and reset
    input                       clk_i,
    input                       rst_n_i,

    // streaming input
    input [NUM_CLASSES - 1 : 0] data_i,
    input                       valid_i,
    input                       last_i,
    output                      ready_o,

    // wake output
    output                      wake_o,
    output                      valid_o
);

    // =========================================================================
    // Local Parameters
    // =========================================================================
    `ifdef COCOTB_SIM
        localparam SUSTAIN_LEN = 1024;  // short sustain for simulation
    `else
        localparam SUSTAIN_LEN = 8000000;  // half second
    `endif
    localparam COUNTER_BW = $clog2(SUSTAIN_LEN);

    // =========================================================================
    // Control Logic
    // =========================================================================
    localparam STATE_IDLE = 1'd0,
               STATE_WAKE = 1'd1;

    reg [COUNTER_BW - 1 : 0] counter;
    reg state;

    always @(posedge clk_i) begin
        if (!rst_n_i) begin
            counter <= 'd0;
            state   <= STATE_IDLE;
        end else begin
            case (state)
                STATE_IDLE: begin
                    counter <= 'd0;
                    state <= (data_i[0] & valid_i) ? STATE_WAKE : STATE_IDLE;
                end
                STATE_WAKE: begin
                    counter <= counter + 'd1;
                    state <= (counter == SUSTAIN_LEN - 1) ? STATE_IDLE :
                                                            STATE_WAKE;
                end
                default: begin
                    counter <= 'd0;
                    state   <= STATE_IDLE;
                end
            endcase
        end
    end

    // =========================================================================
    // Output Assignment
    // =========================================================================
    assign wake_o = (state == STATE_WAKE);
    assign valid_o = (valid_i | wake_o);

    // =========================================================================
    // Simulation Only Waveform Dump (.vcd export)
    // =========================================================================
    `ifdef COCOTB_SIM
    `ifndef SCANNED
    `define SCANNED
    initial begin
        $dumpfile ("wave.vcd");
        $dumpvars (0, wake);
        #1;
    end
    `endif
    `endif

endmodule
// =============================================================================
// Module:       Word Recognition Top Module
// Design:       Eldrick Millares
// Verification: Matthew Pauly
// Notes:
// =============================================================================
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
