eldrickm/wakey_wakey/rtl/aco/framing/framing.v

// =============================================================================
// Module:       Framing
// Design:       Matthew Pauly
// Verification: Eldrick Millares
// Notes:        Aggregates 256 samples into a FIFO and outputs them in one
//               large block.
// =============================================================================

module framing # (
    parameter I_BW         = 9,   // preemphasis input
    parameter O_BW         = 16,  // output to FFT
    parameter FRAME_LEN    = 256,
    parameter CADENCE_CYC  = 3,  // how long to hold output data before changing
                                 // Must be lower than the rate at which data
                                 // comes in.
    parameter SKIP_ELEMS   = 0   // num elements to skip after a complete frame
) (
    // clock and reset
    input                                   clk_i,
    input                                   rst_n_i,
    input                                   en_i,

    // streaming input
    input  signed [I_BW - 1 : 0]            data_i,
    input                                   valid_i,

    // streaming output
    output  signed [O_BW - 1 : 0]           data_o,
    output                                  valid_o,
    output                                  last_o
);
    // =========================================================================
    // Local Parameters
    // =========================================================================
    localparam FIFO_DEPTH       = FRAME_LEN + 4;   // 4 spaces of headroom
    localparam COUNTER_BW       = $clog2(FIFO_DEPTH);
    localparam FULL_PERIOD      = FRAME_LEN + SKIP_ELEMS;
    localparam SKIP_COUNTER_BW  = $clog2(FIFO_DEPTH + SKIP_ELEMS);
    localparam CADENCE_BW       = $clog2(CADENCE_CYC);

    localparam STATE_LOAD   = 1'd0,
               STATE_UNLOAD = 1'd1;

    // =========================================================================
    // Signal Declarations
    // =========================================================================
    reg state;

    reg [COUNTER_BW - 1 : 0] fifo_count;  // number of elements in the fifo

    reg [COUNTER_BW - 1 : 0] frame_elem;  // Number of frame elements outputted.
                                          // Zero-indexed counting, so last
                                          // element is FRAME_LEN - 1
    wire last_elem = (frame_elem == FRAME_LEN - 'd1);

    // Determines how long to hold an output
    reg [CADENCE_BW - 1 : 0] cadence;
    wire next_elem = (cadence == CADENCE_CYC - 'd1);

    wire fifo_deq = ((state == STATE_UNLOAD) & next_elem);

    reg [COUNTER_BW - 1 : 0] skip_count;
    wire skip = (skip_count >= FRAME_LEN);  // skip if already have FRAME_LEN
                                            // elements in the current period

    wire fifo_enq = (en_i & valid_i & !skip);

    // =========================================================================
    // State Machine
    // =========================================================================
    always @(posedge clk_i) begin
        if (!rst_n_i | !en_i) begin
            frame_elem <= 'd0;
            state <= STATE_LOAD;
        end else begin
            case (state)
                STATE_LOAD: begin
                    frame_elem <= 'd0;
                    state      <= (fifo_count == FRAME_LEN) ? STATE_UNLOAD
                                                            : STATE_LOAD;
                end
                STATE_UNLOAD: begin
                    if (next_elem) frame_elem <= frame_elem + 'd1;
                    else frame_elem <= frame_elem;
                    state      <= (last_elem & next_elem) ? STATE_LOAD
                                                          : STATE_UNLOAD;
                end
                default: begin
                    frame_elem <= 'd0;
                    state <= STATE_LOAD;
                end
            endcase
        end
    end

    // =========================================================================
    // FIFO element tracking
    // =========================================================================
    always @(posedge clk_i) begin
        if (!rst_n_i | !en_i) begin
            fifo_count <= 'd0;
        end else begin
            if (fifo_enq & !fifo_deq) begin
                fifo_count <= fifo_count + 'd1;
            end else if (!fifo_enq & fifo_deq) begin
                fifo_count <= fifo_count - 'd1;
            end else begin
                fifo_count <= fifo_count;
            end
        end
    end

    // =========================================================================
    // Skip Counter
    // =========================================================================
    // Tracks the number of elements seen across one period, including
    // elements that are to be skipped
    always @(posedge clk_i) begin
        if (!rst_n_i | !en_i) begin
            skip_count <= 'd0;
        end else begin
            if (valid_i & (skip_count == FULL_PERIOD - 'd1)) begin
                skip_count <= 'd0;
            end else if (valid_i) begin
                skip_count <= skip_count + 'd1;
            end else begin
                skip_count <= skip_count;
            end
        end
    end

    // =========================================================================
    // Cadence
    // =========================================================================
    always @(posedge clk_i) begin
        if (!rst_n_i | !en_i) begin
            cadence <= 'd0;
        end else begin
            if (next_elem) begin  // reset to 0
                cadence <= 'd0;
            end else if (state == STATE_UNLOAD) begin
                cadence <= cadence + 'd1;
            end else begin
                cadence <= 'd0;
            end
        end
    end

    // =========================================================================
    // FIFO
    // =========================================================================
    wire signed [I_BW - 1 : 0]  fifo_dout;
    fifo #(
        .DATA_WIDTH(I_BW),
        .FIFO_DEPTH(FIFO_DEPTH)
    ) fifo_inst (
        .clk_i(clk_i),
        .rst_n_i(rst_n_i & en_i),

        .enq_i(fifo_enq),
        .din_i(data_i),

        .deq_i(fifo_deq),
        .dout_o(fifo_dout),

        .full_o_n(),
        .empty_o_n()
    );

    // =========================================================================
    // Output Assignment
    // =========================================================================
    assign valid_o = (en_i & (state == STATE_UNLOAD));
    assign data_o = fifo_dout;
    assign last_o = (fifo_deq & last_elem);

    // =========================================================================
    // Simulation Only Waveform Dump (.vcd export)
    // =========================================================================
    `ifdef COCOTB_SIM
    `ifndef SCANNED
    `define SCANNED
    initial begin
        $dumpfile ("wave.vcd");
        $dumpvars (0, framing);
        #1;
    end
    `endif
    `endif

endmodule
