eldrickm/wakey_wakey/pd/caravel_integration/verilog/rtl/gl/user_project_wrapper.v

module user_project_wrapper (user_clock2,
    wb_clk_i,
    wb_rst_i,
    wbs_ack_o,
    wbs_cyc_i,
    wbs_stb_i,
    wbs_we_i,
    vccd1,
    vssd1,
    vccd2,
    vssd2,
    vdda1,
    vssa1,
    vdda2,
    vssa2,
    analog_io,
    io_in,
    io_oeb,
    io_out,
    la_data_in,
    la_data_out,
    la_oenb,
    // la_oen,
    user_irq,
    wbs_adr_i,
    wbs_dat_i,
    wbs_dat_o,
    wbs_sel_i);
 input user_clock2;
 input wb_clk_i;
 input wb_rst_i;
 output wbs_ack_o;
 input wbs_cyc_i;
 input wbs_stb_i;
 input wbs_we_i;
 input vccd1;
 input vssd1;
 input vccd2;
 input vssd2;
 input vdda1;
 input vssa1;
 input vdda2;
 input vssa2;
 inout [28:0] analog_io;
 // inout [30:0] analog_io;
 input [37:0] io_in;
 output [37:0] io_oeb;
 output [37:0] io_out;
 input [127:0] la_data_in;
 output [127:0] la_data_out;
 // input [127:0] la_oen;
 input [127:0] la_oenb;
 output [2:0] user_irq;
 input [31:0] wbs_adr_i;
 input [31:0] wbs_dat_i;
 output [31:0] wbs_dat_o;
 input [3:0] wbs_sel_i;

 user_proj_example mprj (.wb_clk_i(wb_clk_i),
    .wb_rst_i(wb_rst_i),
    .wbs_ack_o(wbs_ack_o),
    .wbs_cyc_i(wbs_cyc_i),
    .wbs_stb_i(wbs_stb_i),
    .wbs_we_i(wbs_we_i),
    .VDD(vccd1),
    .VSS(vssd1),
    // .vccd1(vccd1),
    // .vssd1(vssd1),
    // .vccd2(vccd2),
    // .vssd2(vssd2),
    // .vdda1(vdda1),
    // .vssa1(vssa1),
    // .vdda2(vdda2),
    // .vssa2(vssa2),
    .io_in({io_in[37],
    io_in[36],
    io_in[35],
    io_in[34],
    io_in[33],
    io_in[32],
    io_in[31],
    io_in[30],
    io_in[29],
    io_in[28],
    io_in[27],
    io_in[26],
    io_in[25],
    io_in[24],
    io_in[23],
    io_in[22],
    io_in[21],
    io_in[20],
    io_in[19],
    io_in[18],
    io_in[17],
    io_in[16],
    io_in[15],
    io_in[14],
    io_in[13],
    io_in[12],
    io_in[11],
    io_in[10],
    io_in[9],
    io_in[8],
    io_in[7],
    io_in[6],
    io_in[5],
    io_in[4],
    io_in[3],
    io_in[2],
    io_in[1],
    io_in[0]}),
    .io_oeb({io_oeb[37],
    io_oeb[36],
    io_oeb[35],
    io_oeb[34],
    io_oeb[33],
    io_oeb[32],
    io_oeb[31],
    io_oeb[30],
    io_oeb[29],
    io_oeb[28],
    io_oeb[27],
    io_oeb[26],
    io_oeb[25],
    io_oeb[24],
    io_oeb[23],
    io_oeb[22],
    io_oeb[21],
    io_oeb[20],
    io_oeb[19],
    io_oeb[18],
    io_oeb[17],
    io_oeb[16],
    io_oeb[15],
    io_oeb[14],
    io_oeb[13],
    io_oeb[12],
    io_oeb[11],
    io_oeb[10],
    io_oeb[9],
    io_oeb[8],
    io_oeb[7],
    io_oeb[6],
    io_oeb[5],
    io_oeb[4],
    io_oeb[3],
    io_oeb[2],
    io_oeb[1],
    io_oeb[0]}),
    .io_out({io_out[37],
    io_out[36],
    io_out[35],
    io_out[34],
    io_out[33],
    io_out[32],
    io_out[31],
    io_out[30],
    io_out[29],
    io_out[28],
    io_out[27],
    io_out[26],
    io_out[25],
    io_out[24],
    io_out[23],
    io_out[22],
    io_out[21],
    io_out[20],
    io_out[19],
    io_out[18],
    io_out[17],
    io_out[16],
    io_out[15],
    io_out[14],
    io_out[13],
    io_out[12],
    io_out[11],
    io_out[10],
    io_out[9],
    io_out[8],
    io_out[7],
    io_out[6],
    io_out[5],
    io_out[4],
    io_out[3],
    io_out[2],
    io_out[1],
    io_out[0]}),
    .irq({user_irq[2],
    user_irq[1],
    user_irq[0]}),
    .la_data_in({la_data_in[127],
    la_data_in[126],
    la_data_in[125],
    la_data_in[124],
    la_data_in[123],
    la_data_in[122],
    la_data_in[121],
    la_data_in[120],
    la_data_in[119],
    la_data_in[118],
    la_data_in[117],
    la_data_in[116],
    la_data_in[115],
    la_data_in[114],
    la_data_in[113],
    la_data_in[112],
    la_data_in[111],
    la_data_in[110],
    la_data_in[109],
    la_data_in[108],
    la_data_in[107],
    la_data_in[106],
    la_data_in[105],
    la_data_in[104],
    la_data_in[103],
    la_data_in[102],
    la_data_in[101],
    la_data_in[100],
    la_data_in[99],
    la_data_in[98],
    la_data_in[97],
    la_data_in[96],
    la_data_in[95],
    la_data_in[94],
    la_data_in[93],
    la_data_in[92],
    la_data_in[91],
    la_data_in[90],
    la_data_in[89],
    la_data_in[88],
    la_data_in[87],
    la_data_in[86],
    la_data_in[85],
    la_data_in[84],
    la_data_in[83],
    la_data_in[82],
    la_data_in[81],
    la_data_in[80],
    la_data_in[79],
    la_data_in[78],
    la_data_in[77],
    la_data_in[76],
    la_data_in[75],
    la_data_in[74],
    la_data_in[73],
    la_data_in[72],
    la_data_in[71],
    la_data_in[70],
    la_data_in[69],
    la_data_in[68],
    la_data_in[67],
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
    wbs_dat_o[19],
    wbs_dat_o[18],
    wbs_dat_o[17],
    wbs_dat_o[16],
    wbs_dat_o[15],
    wbs_dat_o[14],
    wbs_dat_o[13],
    wbs_dat_o[12],
    wbs_dat_o[11],
    wbs_dat_o[10],
    wbs_dat_o[9],
    wbs_dat_o[8],
    wbs_dat_o[7],
    wbs_dat_o[6],
    wbs_dat_o[5],
    wbs_dat_o[4],
    wbs_dat_o[3],
    wbs_dat_o[2],
    wbs_dat_o[1],
    wbs_dat_o[0]}),
    .wbs_sel_i({wbs_sel_i[3],
    wbs_sel_i[2],
    wbs_sel_i[1],
    wbs_sel_i[0]}));
endmodule
