eldrickm/wakey_wakey/(commit log)

2021-04-12 Refactors ports to be zero indexed, fixes vec_add test
    [test_vec_add.py]
2021-04-21 amended conv_mem logic to not reset counters when cyc_en is deasserted in the middle of inferencing
    [conv_mem.v]
2021-04-23 Adds pos edge detector acc buf reset to mac.v
    [mac.v]
2021-04-24 Completes wrd top module wire up
2021-04-28 add valid timeout for resetting accumulation
    [mac.v]
2021-04-28 fix testbench bug, fc array packing bug
    [fc_top.v, mac.v]
2021-04-28 fix conv sipo bug
    [conv_sipo.v]
2021-04-28 fix maxpool inconsistency with sw model
    [max_pool.v]
2021-04-28 fix bug introduced in previous max pool fix
    [max_pool.v]
2021-05-01 update testbench to print values if argmax dimension error occurs
2021-05-01 update printed output
2021-05-03 Add PDM and CIC filter simulation.
2021-05-06 add sampler
2021-05-09 added valid de-assertions to test_comb.py
2021-05-09 add pdm filter
2021-05-10 replaced FIFO with registers
    [comb.v]
2021-05-10 Adds sequential store load test, fixes address bug
    [cfg.v, test_cfg.py]
2021-05-11 Adds pd flow setup scripts
2021-05-13 Updates power to complete PDN, adds update_caravel_integration
2021-05-16 add power_spectrum
2021-05-17 add filterbank_half
2021-05-17 add MFCC filterbank
2021-05-20 Refactors pd flow, updates readme, start DV integration
2021-05-21 add option for framing to skip elements between frames
    [framing.v, test_framing.py]
2021-05-21 fix aco.py bugs, update aco.v with frame skipping params
2021-05-24 update aco tests to randomly choose audio samples
2021-05-24 Adds case ROMs to dct, filterbank_half, fftstage
2021-05-27 broke up long path in ACO
    [power_spectrum.v]
2021-05-27 update power spectrum test bench, fix bug
    [power_spectrum.v, test_power_spectrum.py]
2021-05-30 Updates pd/caravel_integration structure, changes user_proj_example wiring
2021-05-30 Add Teensy PDM capture code
2021-05-30 Adds pipecleaner and flow, better user_proj_example integration
2021-05-30 Updates macro.cfg for pipecleaner, reverts user_project_wrapper config.tcl
    [macro.cfg]
2021-05-31 Adds delay o addr and ctrl in cfg - NOT FUNCTIONALLY CORRECT YET
    [cfg.v]
2021-06-02 decided on second cic stage, with reasonable default quantization
2021-06-02 update dfe to have second cic stage
2021-06-02 fix filter port slicing
    [filter.v]
2021-06-02 add regs to dfe/filter to break up long path
2021-06-04 Fixes wake pin regression, fixes CFG to be functional, adds load/store tet
    [cfg.v, test_cfg.py, wake.v]
2021-06-04 Adds ifndef SCANNED to all dumpvars, adds basic load store test top tb, fixes CFG
    [cfg.v, cfg_harness.v, comb.v, conv_mem.v, conv_sipo.v, conv_top.v, decimator.v]
2021-06-08 Adds proprietary pd flow
2021-06-08 Adds dc flow starter files, needs dc-compatible refactor
2021-06-08 Fixes DC Flow - Remove rtoi in ctl.v
    [ctl.v]
2021-06-08 Fixes DC Flow - Moves localparams in conv_mem.v
    [conv_mem.v]
2021-06-08 Fixes DC Flow - Moves localparams in recycler.v
    [recycler.v]
2021-06-08 Fixes DC Flow - Moves localparams in argmax.v, Fixes argmax test
2021-06-08 Fixes DC Flow - Moves localparams in conv_sipo, Moves wire decl order
    [conv_sipo.v]
2021-06-08 Fixes DC Flow - Moves localparams in conv_top
    [conv_top.v]
2021-06-08 Fixes DC Flow - Moves localparams in fc_mem
    [fc_mem.v]
2021-06-08 Fixes DC Flow - Moves localparams in fc_top
    [fc_top.v]
2021-06-08 Fixes DC Flow - Moves wire decl in fc_top
    [fc_top.v]
2021-06-08 Fixes DC Flow - Moves signal decls in mac.v
    [mac.v]
2021-06-08 Fixes DC Flow - Moves signal decls in max_pool, cleans up max_pool
    [max_pool.v]
2021-06-08 Fixes DC Flow - Moves localparams in wrd
2021-06-08 Fixes DC Flow - Removes ceil and rtoi calls in wrd
2021-06-08 Fixes DC Flow - Moves localparams in zero_pad
    [zero_pad.v]
2021-06-08 Fixes DC Flow - Moves localparams in decimator.v
    [decimator.v]
2021-06-08 Fixes DC Flow - Moves localparams in dfe
    [dfe.v]
2021-06-08 Fixes DC Flow - Moves localparams in filter.v
    [filter.v]
2021-06-09 Fixes DC Flow - Moves localparams in aco.v
2021-06-09 Fixes DC Flow - Moves localparams in dct.v
    [dct.v]
2021-06-09 Fixes DC Flow - Moves signal decls in dct.v
    [dct.v]
2021-06-09 Fixes DC Flow - Moves localparams in fft_wrapper.v
    [fft_wrapper.v]
2021-06-09 Fixes DC Flow - Removes rtoi in fft_wrapper
    [fft_wrapper.v]
2021-06-09 Fixes DC Flow - Moves localparams in filterbank.v
    [filterbank.v]
2021-06-09 Fixes DC Flow - Moves localparams and signal decls in filterbank_half.v
    [filterbank_half.v]
2021-06-09 Fixes DC Flow - Moves localparams and signal decls in aco modules
    [framing.v, log.v, packing.v, power_spectrum.v, preemphasis.v, quant.v]
2021-06-09 Fixes DC Flow - Moves state machine state decls in framing.v
    [framing.v]
2021-06-09 Fixes DC Flow - Fixes simul = <= assignment to skip_count in framing.v
    [framing.v]
2021-06-09 Fixes DC Flow - Removes pow call in quant.v
    [quant.v]
2021-06-09 Fixes DC Flow - Moves signal decl in packing.v
    [packing.v]
2021-06-09 Fixes DC Flow - Moves localparams in dffram.v
2021-06-09 Fixes DC Flow - Moves localparams in bimpy.v
2021-06-09 Fixes DC Flow - Moves localparams in longbimpy.v
2021-06-09 Fixes DC Flow - Moves signal decls in fftstage.v
2021-06-09 Corrects clock name, removes use-before-declare warnings for DC
    [conv_top.v, ctl.v, recycler.v]
2021-06-09 Adds innovus flows, gdsmerge
2021-06-09 Adds floorplan and pin-placement starter files
2021-06-09 Starts custom pin-assignments
2021-06-09 Updates pin-placement according to user_project_wrapper lef
2021-06-10 Adds floorplan, pin assignment nodes, targets user_proj_example
2021-06-10 Corrects IRQ name in pin-assignments.tcl
2021-06-10 Adds magic, netgen, rtl-only pt nodes to flow
2021-06-10 Updates openlane pd flow with commerical tool hooks
2021-06-10 Updates openlane configs, patch script
    [macro.cfg]
2021-06-10 Adds pin assignment python script
2021-06-11 fix minor calculator error
    [test_wakey_wakey.py]
2021-06-11 update top test to correct for fft variation
    [test_wakey_wakey.py]
2021-06-11 Removes cad path to allow magic and netgen
2021-06-11 Updates pin assignments to use LEF layer names, adds updated lef and gds
2021-06-12 update firmware test bench to write conv1 weights; finish pretty printing of wrd params in numpy arch
2021-06-15 resolve remaining RTL TODOs
    [cfg.v, conv_mem.v, conv_sipo.v, conv_top.v, ctl.v, dbg.v, fc_mem.v]
2021-06-15 add dbg tests, fix oenb polarity
    [dbg.v, test_dbg.py]
2021-06-15 fix la read in dbg, make unit test more comprehensive
    [dbg.v, test_dbg.py]
2021-06-16 Updates clock period, adds power pin spec in config.tcl
2021-06-17 tweak vim scripting flows
2021-06-18 add hand routed power gds
2021-06-20 Adds diode fix to SPICE netlist, passes LVS
