eldrickm/wakey_wakey/(notices)

Notices in the files:
pd/caravel_integration/verilog/rtl/design.v:
Copyright (c) 2000-2012 Bluespec, Inc.
Copyright (C) 2015-2021, Gisselquist Technology, LLC
The pipelined FFT project is free software (firmware): you can redistribute
it and/or modify it under the terms of the GNU Lesser General Public License
License: LGPL, v3, as defined and found on www.gnu.org,
http://www.gnu.org/licenses/lgpl.html
